TeamCyberwar/Deadlock/CAD files/concept layout1b.PNG

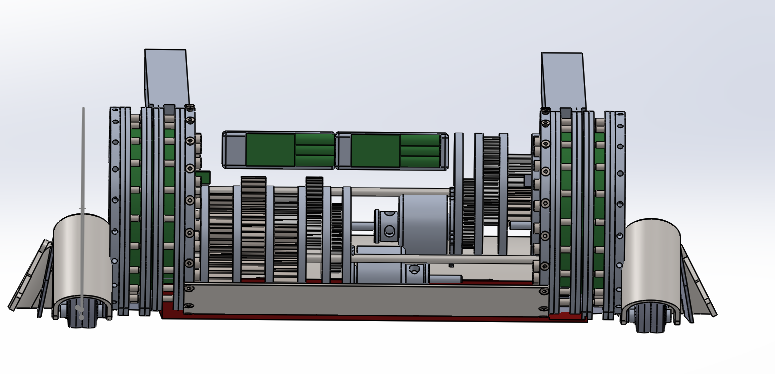
CAD files/concept layout1b.PNG
