TeamCyberwar/Deadlock/CAD files/concept layout1c.PNG

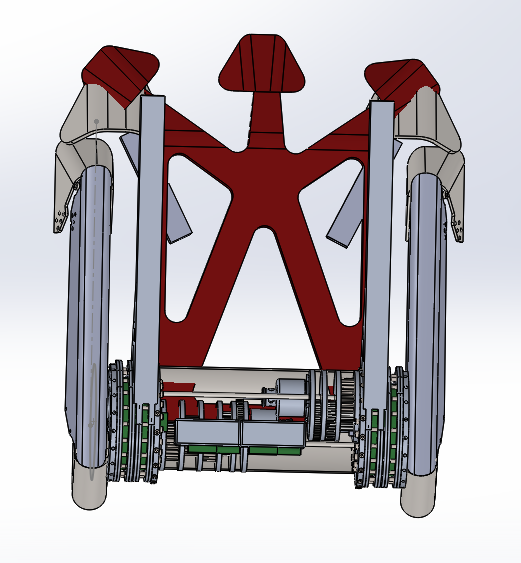
CAD files/concept layout1c.PNG
