TeamCyberwar/Deadlock/readme.md

# What is a Deadlock?

Deadlock is heavyweight combat robot. It’s a fast four wheel drive design whose main weapon is control: a geared lifter & clamping jaws arrangement which is capable of lifting an opponent and rotating them 360 degrees around the main body. The whole robot can do backward rolls. Yes, that is awesome.

Deadlock’s armour is formed from laser cut Hardox sheet, bent and shaped to cover the drive pods and main weapon.

Traction and speed is achieved with full four wheel drive, tank style steering, with power distributed from the 2 high torque 6kw peak brushless motors via chains. The unique body shape allows the front wheels to be close to the lifting point, giving a stable base for driving whilst lifting other robots. An advanced motor control strategy using hall effect sensors allows low speed control from the light but powerful motors.

Deadlock’s weapon is an electrically powered geared lifter/clamper. Using 2 more of the powerful, high torque, 6kw brushless motors, the lift is fast and aggressive. Opponents can not only be lifted and moved around the arena, they can be slammed overhead or into the ground, bashing them into submission. The gearing is achieved by high torque but compact multi stage planetary gearboxes. The weapon is made safe by means of a locking bar when not in the arena.

## I want a Deadlock of my own!
If you have an [onshape](http://onshape.com) account (they're free), you can look at and copy [all the CAD models we used when building Deadlock](https://cad.onshape.com/documents?filter=team&teamId=58c42a52575aee0f7acbd498&column=modifiedAt&order=desc).
If your ambitions are a little smaller, why not build a [scale model of an early iteration](http://www.thingiverse.com/thing:218009) or even a [drivable one](http://www.thingiverse.com/thing:2181223)?

## I *like* Deadlock - where can I find out more?
We're glad to hear it! The best thing to do is to [like and follow us on Facebook](https://www.facebook.com/teamcyberwar) or [follow us on Twitter](https://twitter.com/deadlockrw).

## Acknowledgements

This design was helped by the online community sharing their designs. below are the sources of the files that were used in our test rigs and final design.

All EC connector family models based on model by Graham Baldwin on grabcad https://grabcad.com/library/connector-for-rc-model
RS/3dcontent central for indicator LED model

XT30 by Chrsitian Honig on grabcad https://grabcad.com/library/xt30-connector-1

cable tie model based on model by 'Gregg' on GrabCAd https://grabcad.com/library/cable-tie

cable tie hold down KR5G5-100P by nguyen duc on grabcad https://grabcad.com/library/cable-tie-fixture-misumi-1

vibration isolation VG-2 by RS on 3d content central https://www.3dcontentcentral.com/secure/Download-Partner-Model.aspx?id=327894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

VGS-5 screw direct from essentra components

screws, sprockets, most bearings and eclips from solidworks toolbox

chain root model by  Will Bickerstaff from grabcad https://grabcad.com/library/bs-simplex-roller-chains-1

piano hinge modified from model by Michael Ploof from grabcad https://grabcad.com/library/piano-hinge-mcmaster-carr-part-1658a731-1

vice by Husni Fajar on grabcad https://grabcad.com/library/ragum-vice-1/details?folder_id=1902834

jubilee clip by mark flintoft on grabcad https://grabcad.com/library/jubilee-clips-13mm-wide-1

box end wrench by William Truk on 3dcontentcentral https://www.3dcontentcentral.com/secure/download-model.aspx?catalogid=171&id=229573

pillow block bearings from traceparts http://www.tracepartsonline.net/(S(ny1p1buk5kjeki55kkfjhl45))/partdetails.aspx?PartFamilyID=69-19042013-064161&PartID=69-19042013-064161&sk_Reference=&Class=INAFAG&ClsID=/F_INAFAG/&fwsid=INAFAG&ManId=INAFAG

hammond case models direct from www.hammondmfg.com

sliding T bar from cnc-akura on grabcad https://grabcad.com/library/sliding-t-bar-handles

Eye bolt by J.A.N on grabcad https://grabcad.com/library/din-444-eyebolt-m5-m20-different-sizes-1

banana for scale by Stephan on grabcad https://grabcad.com/library/banana-for-scale-1

# Licence
<br />This work is licensed under a <a rel="license" href="http://creativecommons.org/licenses/by-nc-sa/4.0/">Creative Commons Attribution-NonCommercial-ShareAlike 4.0 International License</a>.
