TeamCyberwar/Deadlock/CAD files/concept layout1a.PNG

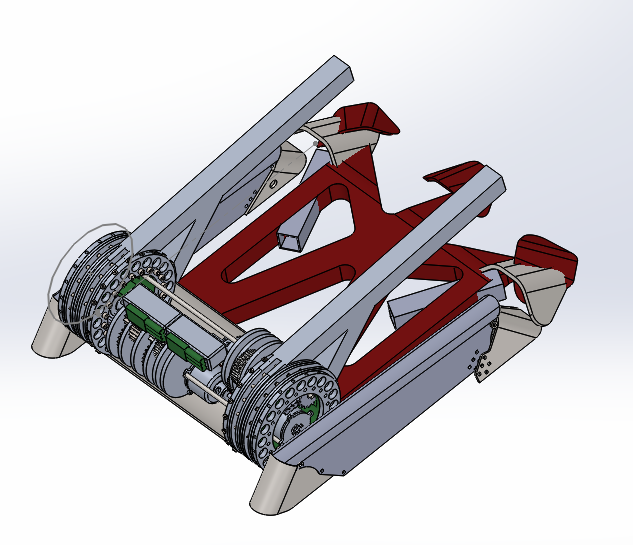
CAD files/concept layout1a.PNG
