TeamCyberwar/Deadlock/CAD files/NYRDI heavy 1.PNG

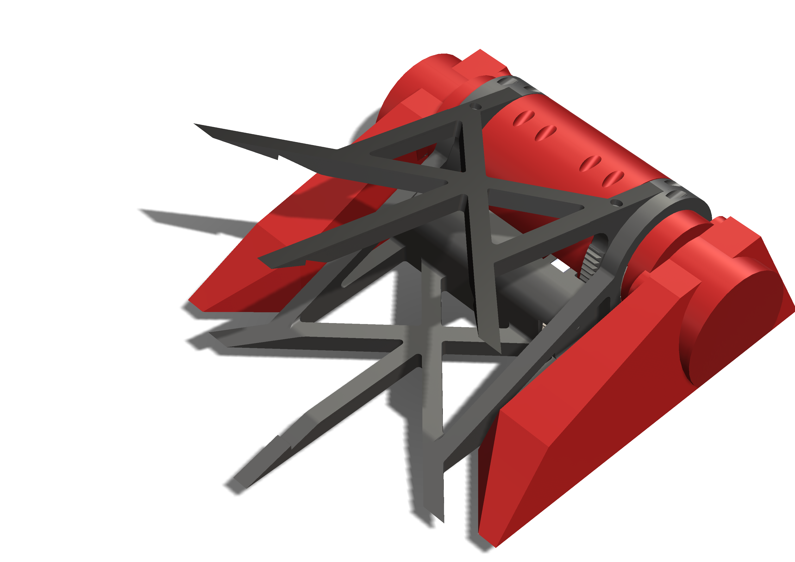
CAD files/NYRDI heavy 1.PNG
