TeamCyberwar/Deadlock/dogfood/Gearbox and Wheel Cassette v2.png

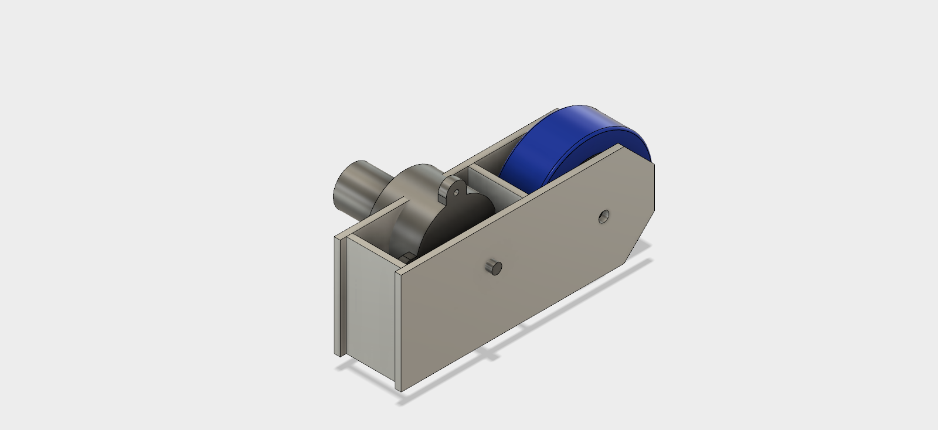
dogfood/Gearbox and Wheel Cassette v2.png
