TeamCyberwar/Deadlock/dogfood/motor mounting holes.PNG

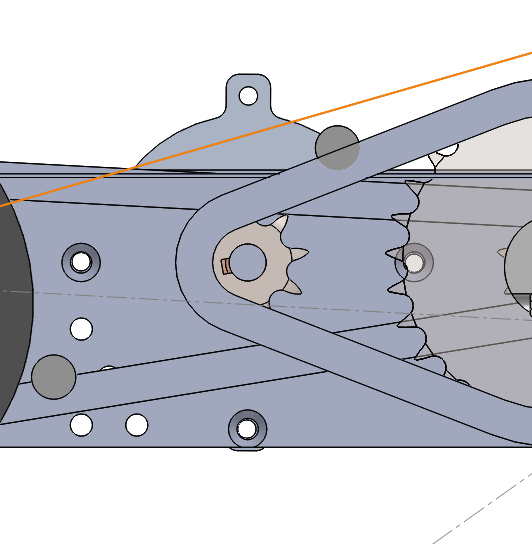
dogfood/motor mounting holes.PNG
