TeamCyberwar/Deadlock/dogfood/sb4a.PNG

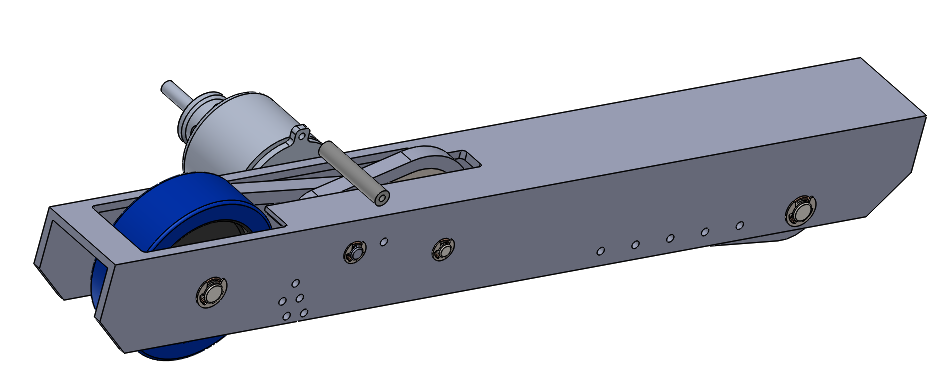
dogfood/sb4a.PNG
