TeamCyberwar/Deadlock/dogfood/sb4b.PNG

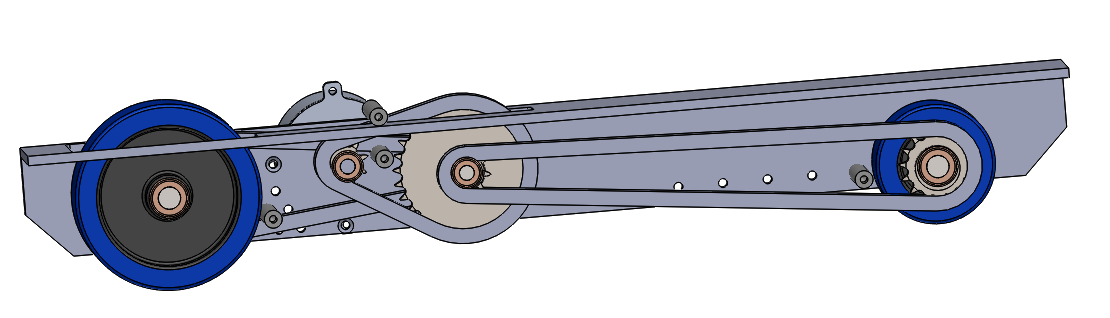
dogfood/sb4b.PNG
