TeamCyberwar/Deadlock/dogfood/sb4c.PNG

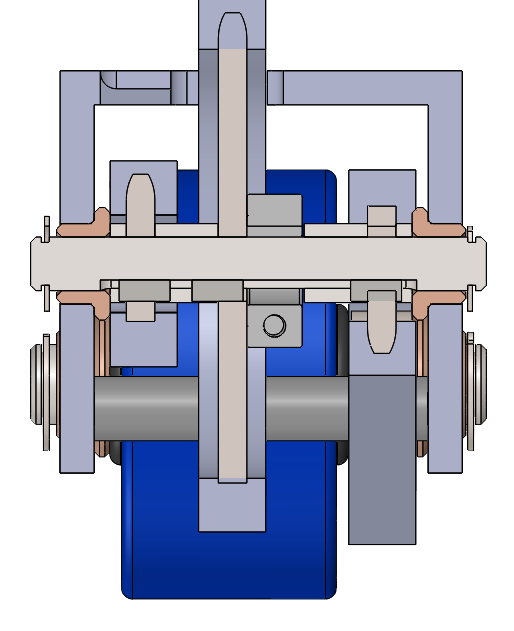
dogfood/sb4c.PNG
