TeamCyberwar/Deadlock/dogfood/sb4d.PNG

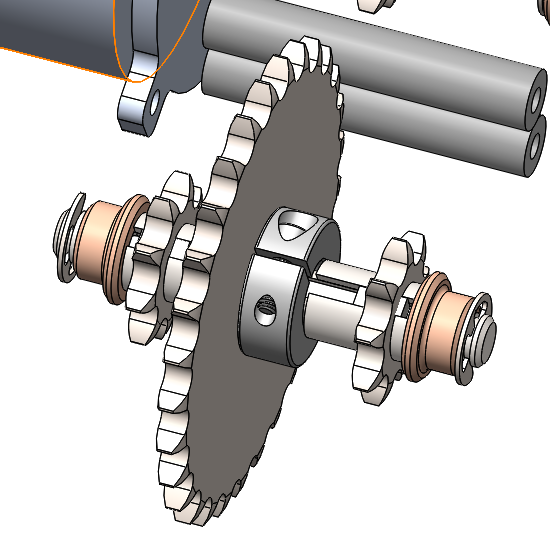
dogfood/sb4d.PNG
