TeamCyberwar/Deadlock/CAD files/piano_hinge_MM_1658A731.SLDASM

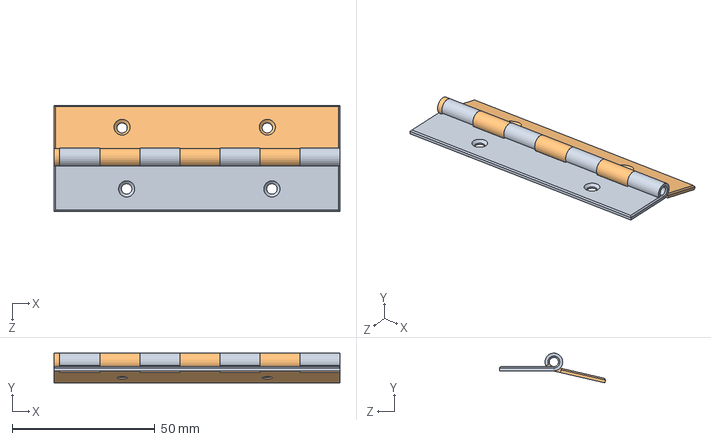
[picture p11: CAD file, 2017-03-15]
CAD files/piano_hinge_MM_1658A731.SLDASM
100.0 x 10.4 x 37.1 mm
piano_hinge_MM_1658A731_A
piano_hinge_MM_1658A731_B
