TeamCyberwar/Deadlock/dogfood/lifter test bed/ucp210_adhynrzrmw05zbap5u401bjt8.SLDASM

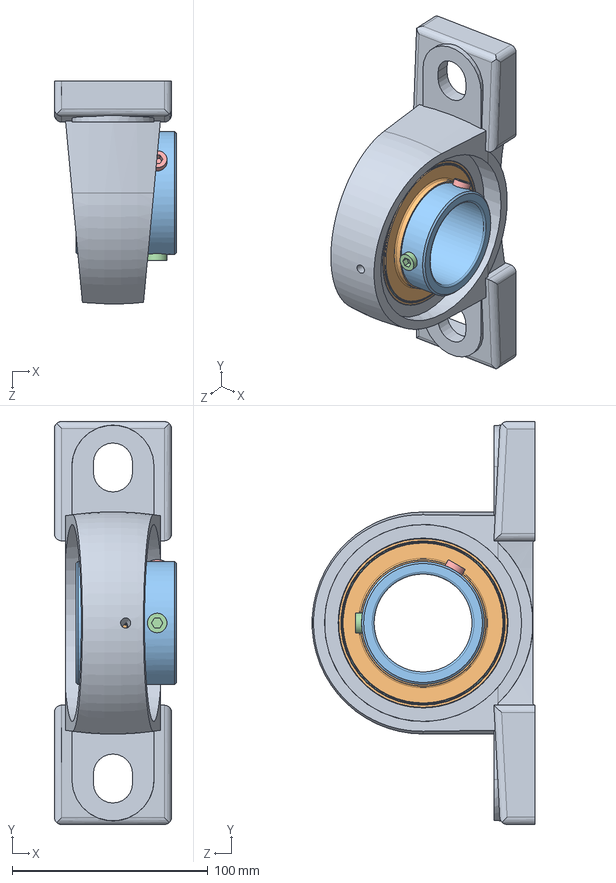
[picture p12: CAD file, 2017-03-15]
dogfood/lifter test bed/ucp210_adhynrzrmw05zbap5u401bjt8.SLDASM
62.6 x 206.0 x 113.9 mm
ucp210_adhynrzrmw05zbap5u401bjt8_01
ucp210_adhynrzrmw05zbap5u401bjt8_02
ucp210_adhynrzrmw05zbap5u401bjt8_03
ucp210_adhynrzrmw05zbap5u401bjt8_04
ucp210_adhynrzrmw05zbap5u401bjt8_05
ucp210_adhynrzrmw05zbap5u401bjt8_06
ucp210_adhynrzrmw05zbap5u401bjt8_07
ucp210_adhynrzrmw05zbap5u401bjt8_08
ucp210_adhynrzrmw05zbap5u401bjt8_09
ucp210_adhynrzrmw05zbap5u401bjt8_10
ucp210_adhynrzrmw05zbap5u401bjt8_11
ucp210_adhynrzrmw05zbap5u401bjt8_12
ucp210_adhynrzrmw05zbap5u401bjt8_13
ucp210_adhynrzrmw05zbap5u401bjt8_14
