TeamCyberwar/Deadlock/dogfood/06B-1b.SLDASM

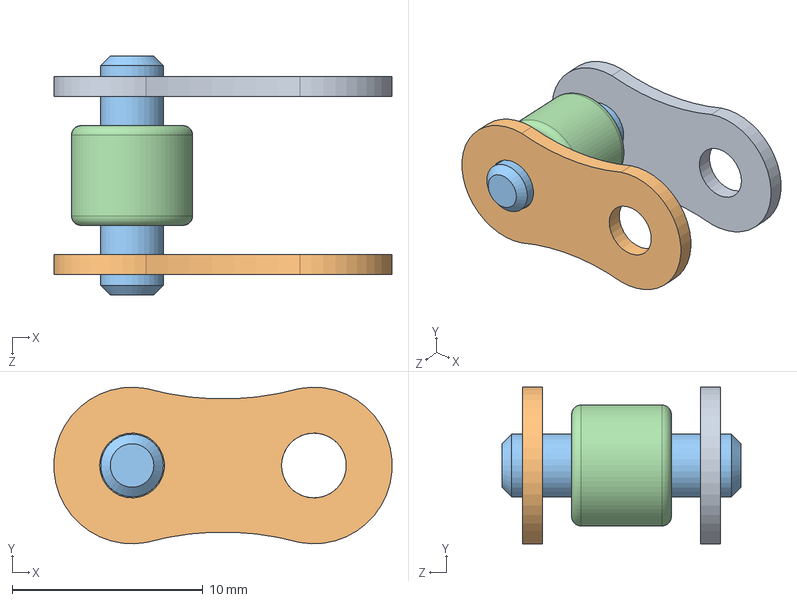
[picture p13: CAD file, 2017-03-15]
dogfood/06B-1b.SLDASM
17.7 x 8.20 x 12.5 mm
Outer_(Mirror_#1)
Outer
Pin_(Mirror_#3)
Roller_(Mirror_#4)
