TeamCyberwar/Deadlock/dogfood/vice/vice.SLDASM

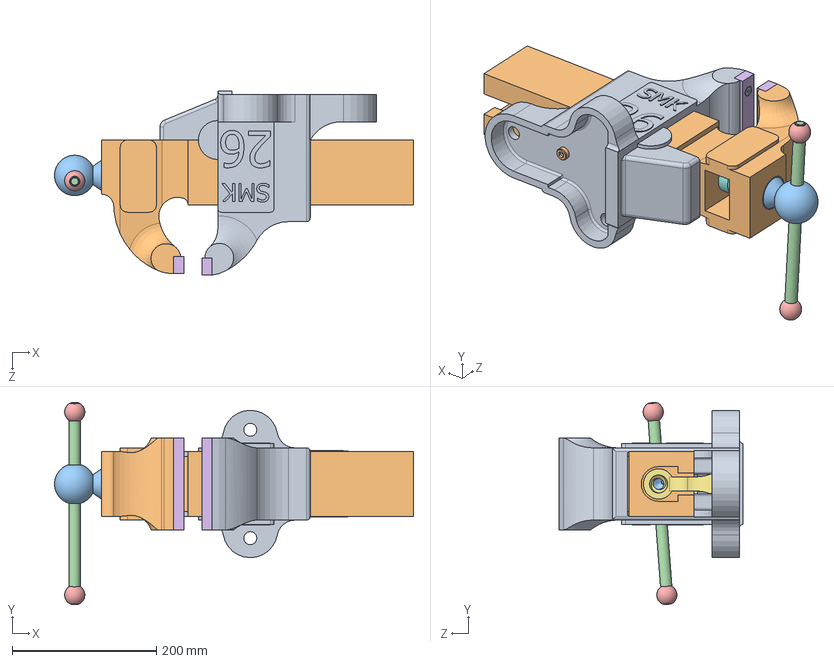
[picture p14: CAD file, 2017-03-15]
dogfood/vice/vice.SLDASM
497.0 x 280.0 x 255.0 mm
Base
Rahang Geser
Shaft Ulir Head
Shaft handle
Shaft Handle Head x 2
Block x 2
Shaft Ulir House
Stoper
ISO 10642 - M6 x 25 x 4
DIN 6912 - M10 x 30
DIN 913 - M5 x 10
