TeamCyberwar/Deadlock/dogfood/vice/Assembly1.stp

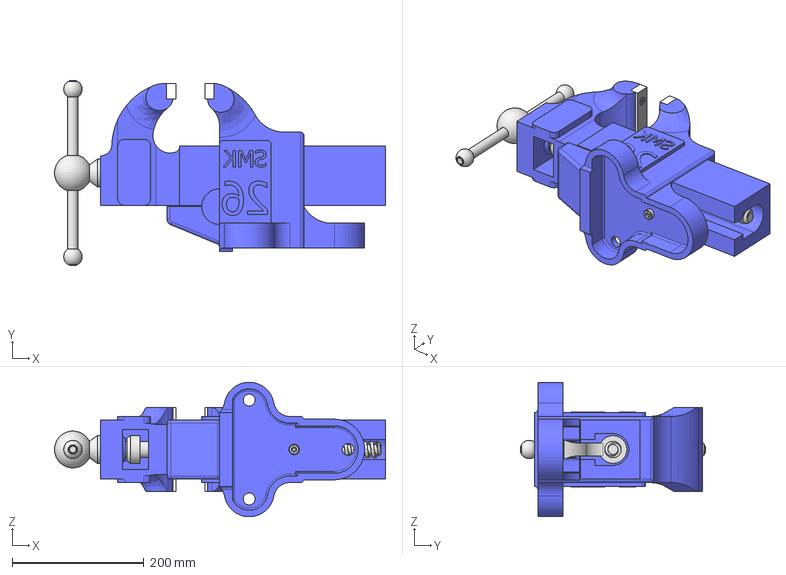
[picture p15: CAD file, 2017-03-15]
dogfood/vice/Assembly1.stp
501.9 x 280.0 x 203.9 mm
