TeamCyberwar/Deadlock/dogfood/06B-1a.SLDASM

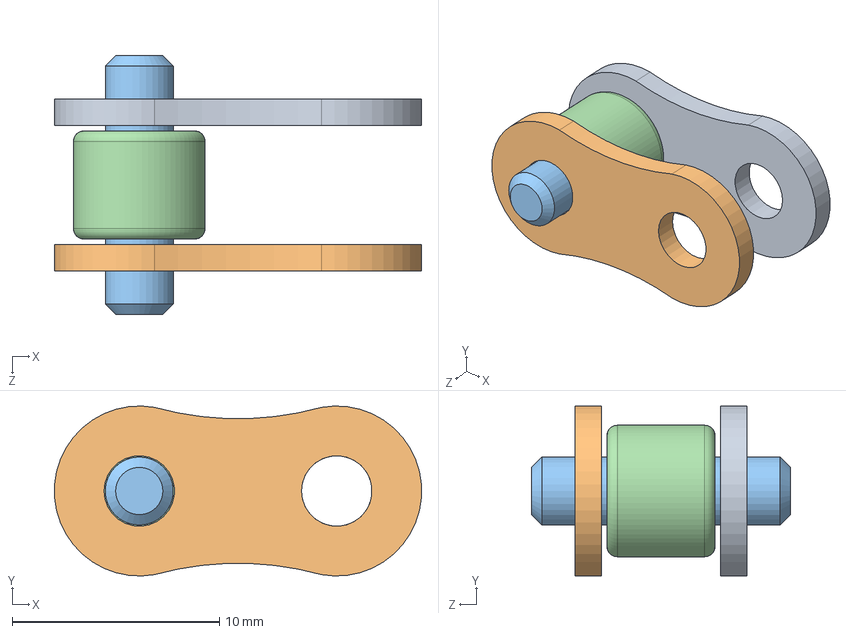
[picture p16: CAD file, 2017-03-15]
dogfood/06B-1a.SLDASM
17.7 x 8.20 x 12.5 mm
Inner_(Mirror_#1)
Inner
Pin
Roller
