TeamCyberwar/Deadlock/dogfood/lifter test bed/lifterc.SLDASM

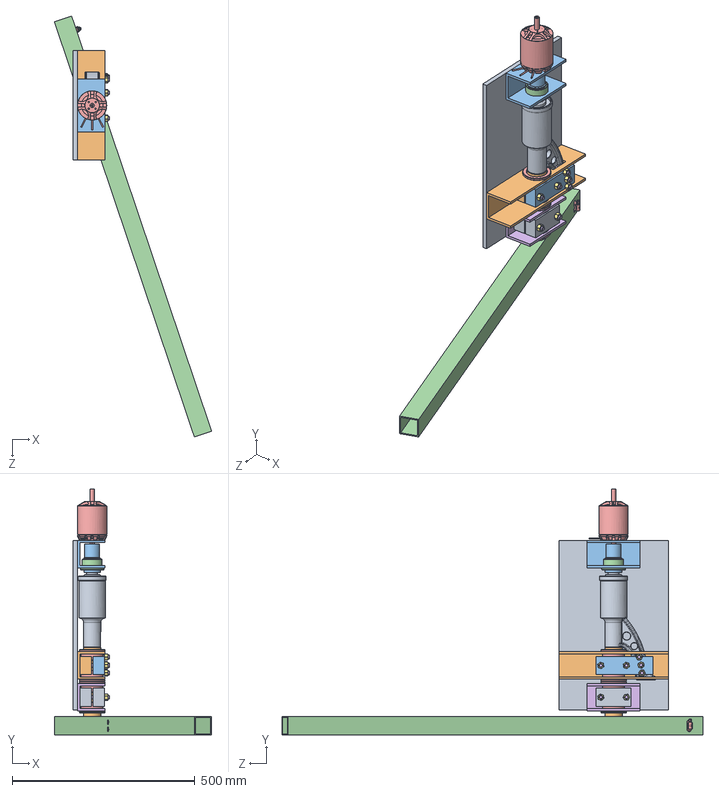
[picture p17: CAD file, 2017-03-15]
dogfood/lifter test bed/lifterc.SLDASM
430.8 x 673.1 x 1153.1 mm
torque multiplier
3x3channelc
3x3channelc2
OBF506030 Flanged Oilite x 4
ISO 10642 - M10 x 100 - 32N x 7
ISO - 4034 - M10 - N x 7
input shaftb
baseboard
33mm socket x 2
20 to 25mm square adapter
OBF455530 Flanged Oilite
C80100 50kv
3x3channelc3
32mm hex bar
0.75in t bar handle
nylon spacer 1 x 2
nylon spacer 2
Mirrornylon spacer 2
steel tube
Jubilee
