TeamCyberwar/Deadlock/eVESC/Mounting HW.sldasm

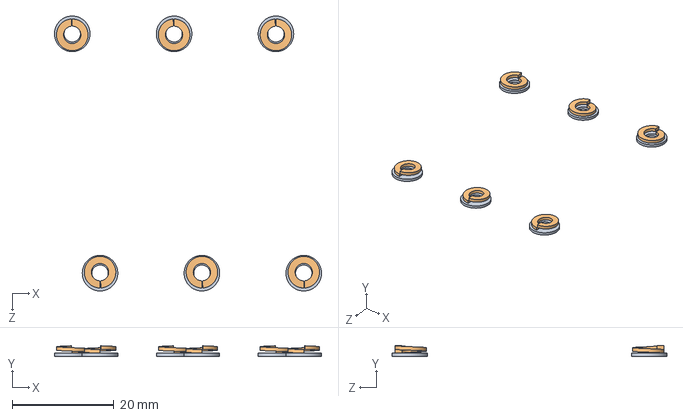
[picture p18: CAD file, 2017-03-15]
eVESC/Mounting HW.sldasm
52.4 x 2.07 x 54.0 mm
M3 washer x 6
M3 split washer x 6
