TeamCyberwar/Deadlock/CAD files/clamp fork v1.sldasm

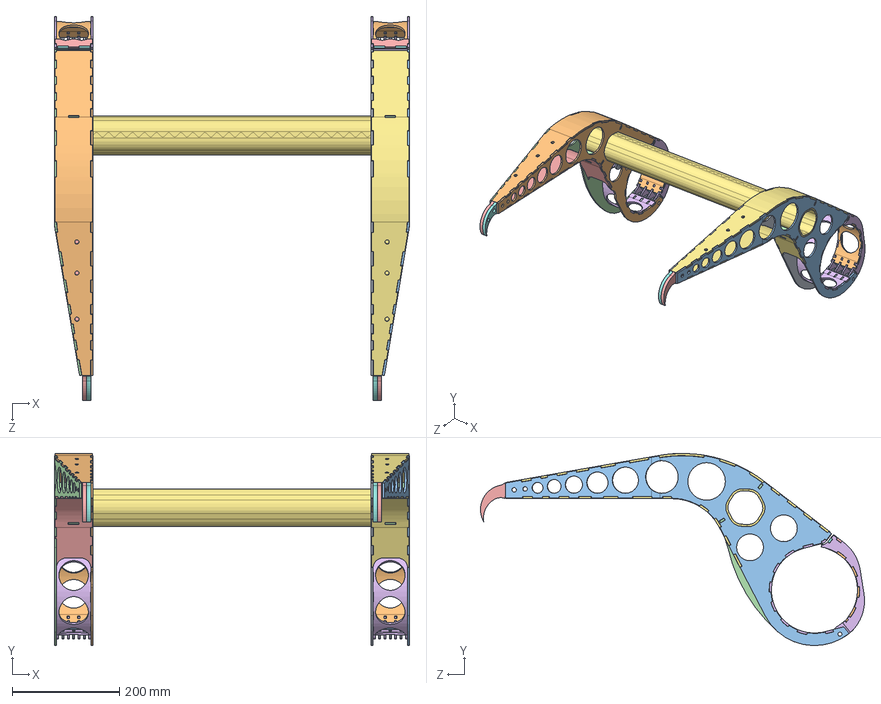
[picture p19: CAD file, 2017-03-15]
CAD files/clamp fork v1.sldasm
661.4 x 357.7 x 714.7 mm
clamp1 x 6
clamp24
clampsaddle10 x 6
clamp20
clampsaddle repeat7 x 2
clampsaddle4 x 8
clamp12
clampclawrepeat x 2
clamp21 x 2
clamp8
clamp18
clamp6 x 2
clampclaw2 x 2
clampsaddle1 x 4
clamp10
clampsaddle3 x 2
clamp17
clampsaddle6 x 2
clamp23
clamp19 x 2
clamp4
clamp9 x 2
clamp tube x 2
