TeamCyberwar/Deadlock/dogfood/16B-2.SLDASM

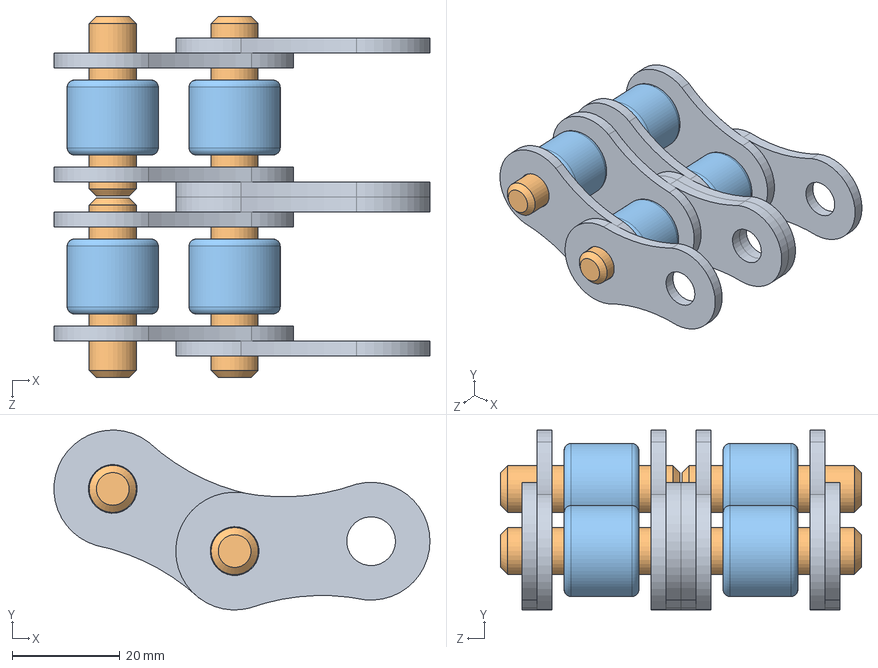
[picture p20: CAD file, 2017-03-15]
dogfood/16B-2.SLDASM
69.8 x 33.4 x 67.0 mm
Outer16 x 8
Pin_(Mirror_#3)16 x 4
Roller_(Mirror_#4)16 x 4
