TeamCyberwar/Deadlock/dogfood/lifter test bed/lifterd.SLDASM

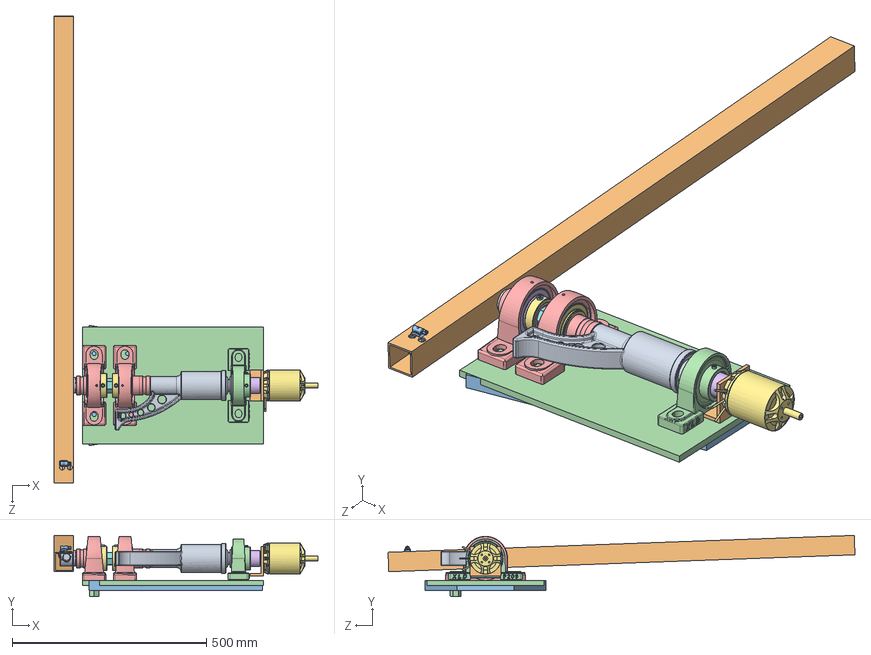
[picture p21: CAD file, 2017-03-15]
dogfood/lifter test bed/lifterd.SLDASM
678.2 x 157.5 x 1201.0 mm
torque multiplier
3x3channeld2
input shaftb
33mm socket x 2
20 to 25mm square adapter
C80100 50kv
32mm hex bar
0.75in t bar handle
steel tube
Jubilee
User Library-Block Bearings Pilow Blocks
ucp210_adhynrzrmw05zbap5u401bjt8_01 x 2
ucp210_adhynrzrmw05zbap5u401bjt8_02 x 2
ucp210_adhynrzrmw05zbap5u401bjt8_03 x 2
ucp210_adhynrzrmw05zbap5u401bjt8_04 x 2
ucp210_adhynrzrmw05zbap5u401bjt8_05 x 2
ucp210_adhynrzrmw05zbap5u401bjt8_06 x 2
ucp210_adhynrzrmw05zbap5u401bjt8_07 x 2
ucp210_adhynrzrmw05zbap5u401bjt8_08 x 2
ucp210_adhynrzrmw05zbap5u401bjt8_09 x 2
ucp210_adhynrzrmw05zbap5u401bjt8_10 x 2
ucp210_adhynrzrmw05zbap5u401bjt8_11 x 2
ucp210_adhynrzrmw05zbap5u401bjt8_12 x 2
ucp210_adhynrzrmw05zbap5u401bjt8_13 x 2
ucp210_adhynrzrmw05zbap5u401bjt8_14 x 2
welded frame2
ISO - 4034 - M16 - N
