TeamCyberwar/Deadlock/eVESC/VESC Power Stage v7.SLDASM

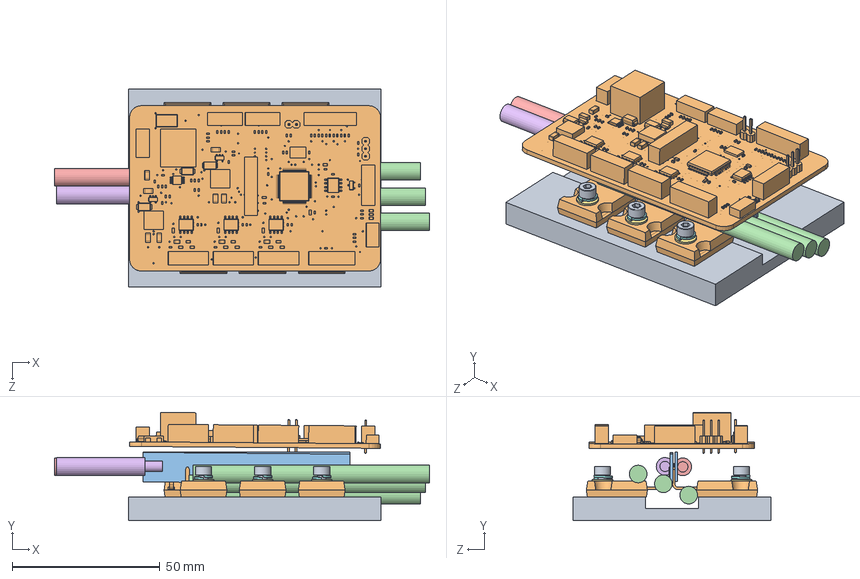
[picture p22: CAD file, 2017-03-15]
eVESC/VESC Power Stage v7.SLDASM
126.9 x 36.6 x 67.0 mm
Heatsink 8mm
TO-247AC-HF v1 x 6
Bus Bar x 2
10AWG Phase Wire x 3
10AWG VCC Wire
10AWG GND Wire
M3 washer x 6
M3 split washer x 6
M3 x 12 - 12N x 6
eVESC v2
