TeamCyberwar/Deadlock/CAD files/drive pod v0.9.SLDASM

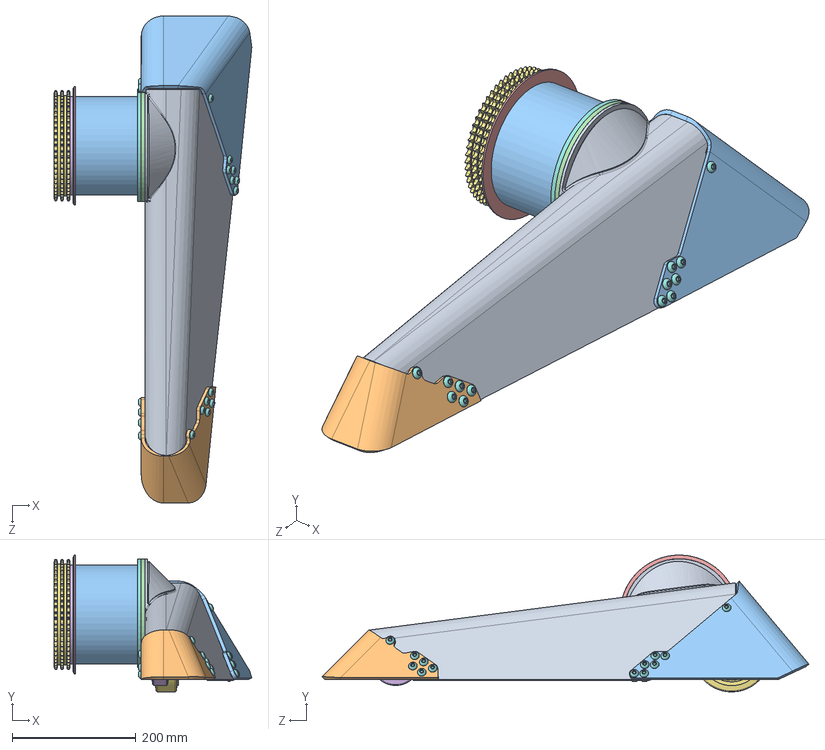
[picture p23: CAD file, 2017-03-15]
CAD files/drive pod v0.9.SLDASM
319.5 x 221.2 x 787.3 mm
pod tube flared v0.8
front wheel mount flared2
rear wheel mount flaredv0.6
06b1 15T
23Z 06B-1
80mm wheel 4
125mm wheel v2
Inner_(Mirror_#1) x 75
Inner x 75
Pin x 75
Roller x 75
Outer_(Mirror_#1) x 74
Outer x 74
Pin_(Mirror_#3) x 74
Roller_(Mirror_#4) x 74
rear wheel hub v2
OBF253020 Flanged Oilite x 3
rear wheel axle
front wheel hub
front wheel axle2
drive pod base v0.4
OBF152110 Flanged Oilite
9T 06b3
ISO 7380 - M8 x 16 - 16N x 26
ISO 10642 - M3 x 8 - 8N x 4
M6 x 40 - 24N x 4
ISO 10642 - M4 x 30 - 20N x 4
ISO 4762 M8 x 140 - 28N x 20
ISO 4762 M6 x 16 - 16N x 4
ISO 4762 M6 x 20 - 20N
ISO 4762 M6 x 12 - 12N x 5
1301-NSK self aligning bearing
drive pod rear plastic block v0.3
5 x 14 pin x 4
nylon tube v3
outer inner anti friction ring v3
inner flange plate
inner spacer plate v0.2
57T 06b3 v0.2
front drive chain keeper
rear drive chain keeper
M4 barrel nut x 4
drive motor bearing spacer
Washer ISO 7092 - 14
B27.7M - 3CM1-15
B27.7M - 3CM1-25
rear wheel plastic washer
intermediate anti friction ring v3
ISO 4762 M5 x 20 - 20N
ISO 4762 M6 x 25 - 25N x 4
