TeamCyberwar/Deadlock/eVESC/housed vesc.SLDASM

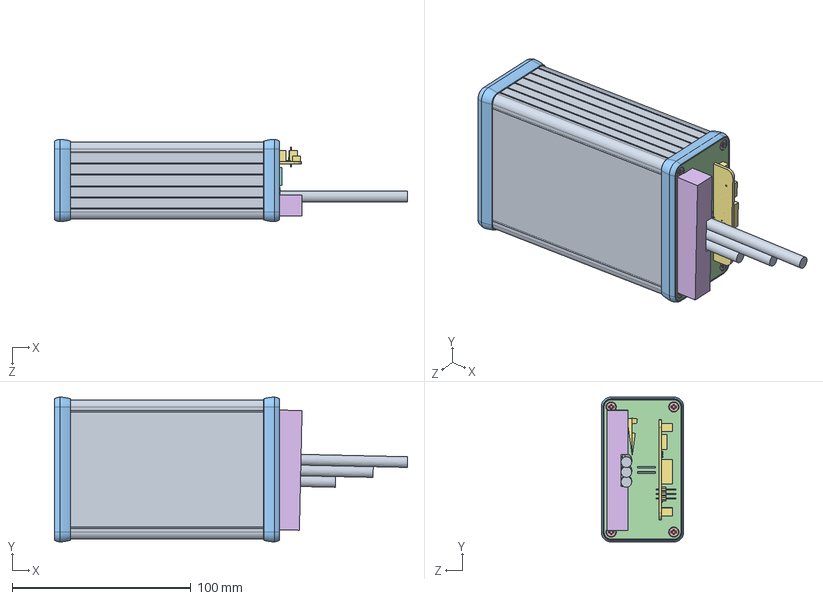
[picture p24: CAD file, 2017-03-15]
eVESC/housed vesc.SLDASM
197.5 x 81.1 x 46.1 mm
K Channel Extrusion 120mmt
K Cap Extrusion 120mm
K Bezel Open x 2
K End Plate
1455 screw x 8
Heatsink
TO-247AC-HF v1 x 6
Bus Bar x 2
10AWG Phase Wire x 3
10AWG VCC Wire
10AWG GND Wire
M3 washer x 6
M3 split washer x 6
M3x12mm socket x 6
eVESC v2
