TeamCyberwar/Deadlock/dogfood/lifter test bed/0.5in t bar handles.SLDASM

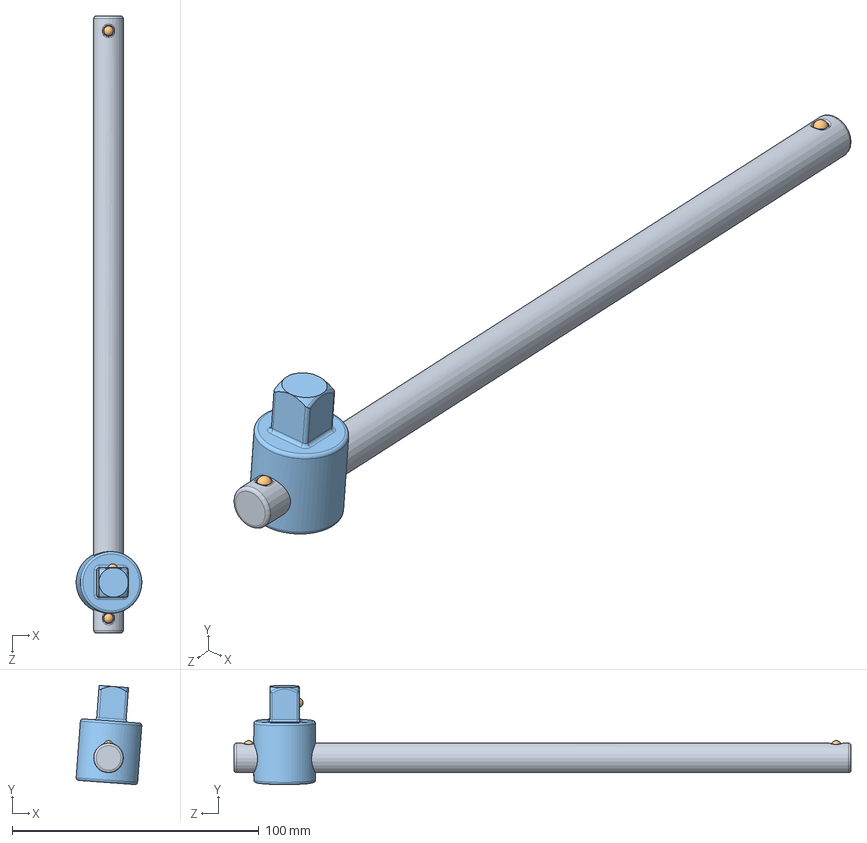
[picture p25: CAD file, 2017-03-15]
dogfood/lifter test bed/0.5in t bar handles.SLDASM
26.6 x 40.2 x 250.0 mm
Part2 ball x 3
Part3 conector
