TeamCyberwar/Deadlock/CAD files/front forks v2.7 from sheet.sldasm

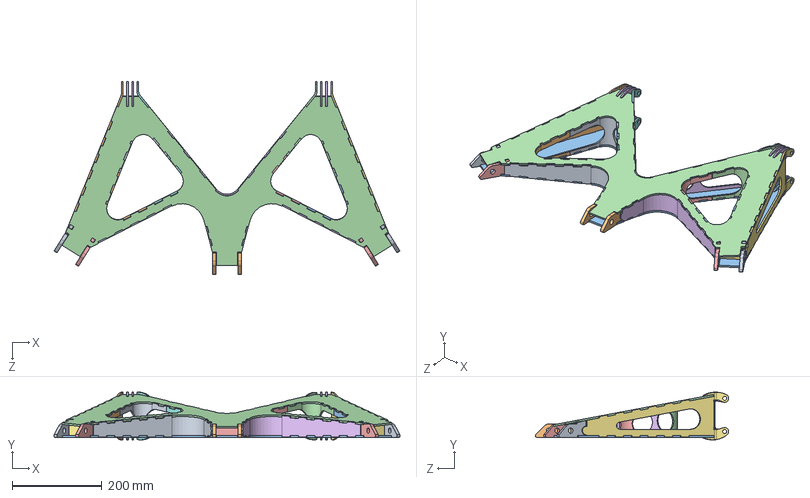
[picture p26: CAD file, 2017-03-15]
CAD files/front forks v2.7 from sheet.sldasm
771.7 x 106.4 x 431.5 mm
fork16 v2
fork10 x 2
fork9 v2
fork7 v2
fork8
fork1 x 4
fork4 x 2
fork3
fork18 x 2
fork11
fork2 x 4
fork6
fork20 x 2
fork15 v2
fork12
fork22
fork23
fork5
fork24
fork25
fork26
fork27
