TeamCyberwar/Deadlock/CAD files/lifter hardox v3.6 from sheet.sldasm

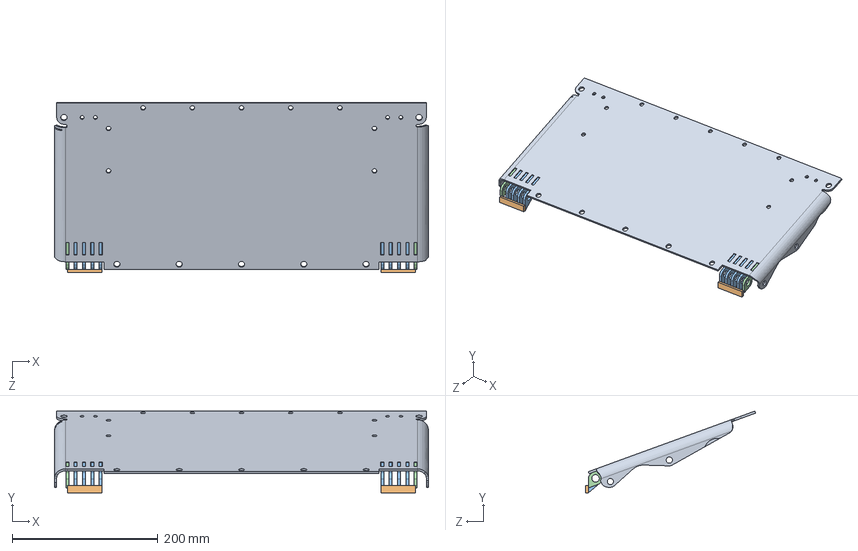
[picture p27: CAD file, 2017-03-15]
CAD files/lifter hardox v3.6 from sheet.sldasm
513.0 x 112.3 x 233.5 mm
lifter1v2
lifter2v2 x 2
lifter3v2 x 8
lifter4v2 x 2
