TeamCyberwar/Deadlock/CAD files/clamp chain v2.sldasm

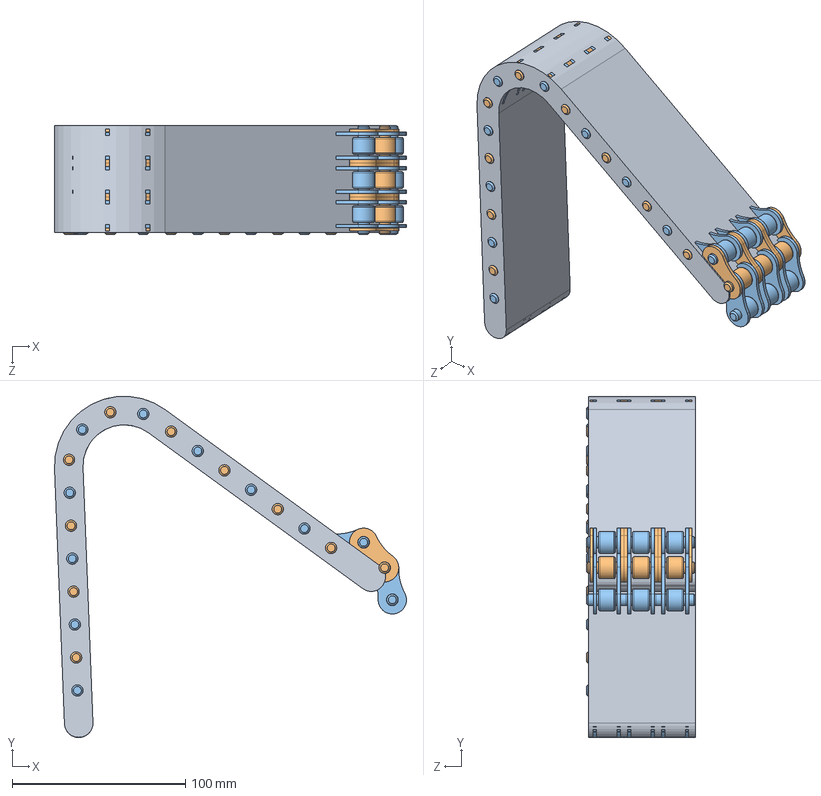
[picture p28: CAD file, 2017-03-15]
CAD files/clamp chain v2.sldasm
203.4 x 197.1 x 63.2 mm
simple clamp chain v2
12B-3b x 10
12B-3a x 11
