TeamCyberwar/Deadlock/dogfood/SB drive pod 3b.SLDASM

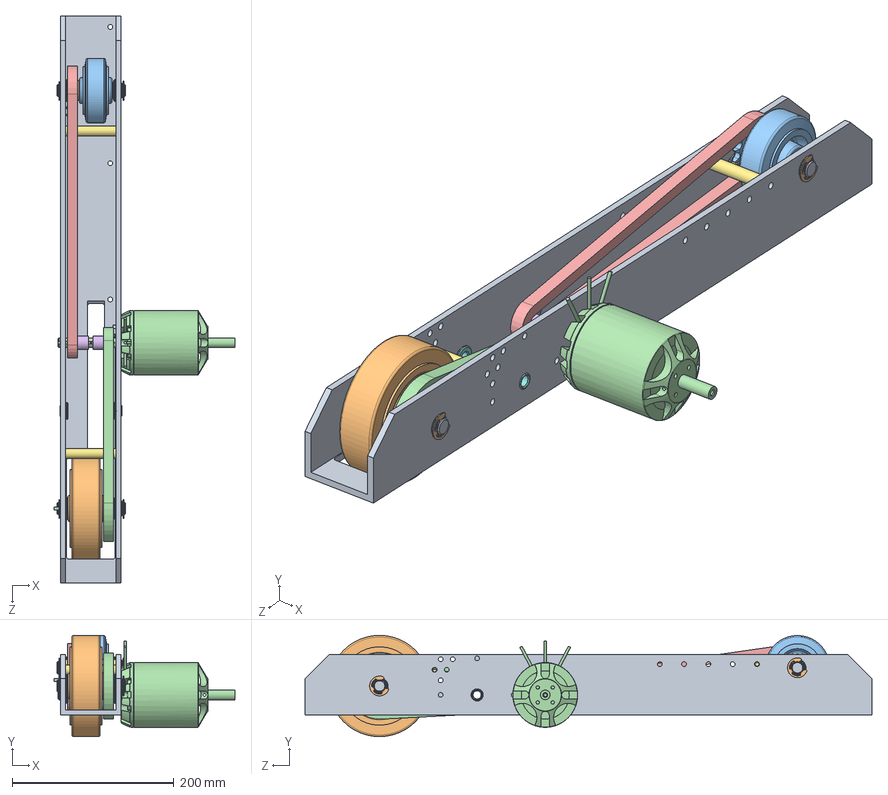
[picture p29: CAD file, 2017-03-15]
dogfood/SB drive pod 3b.SLDASM
223.4 x 124.9 x 700.0 mm
3x3channel 3
125mm wheel 458-9670 3
80mm wheel 3
Outer_(Mirror_#1)
Outer
Inner_(Mirror_#1)
Inner
Pin_(Mirror_#3)
Pin
Roller_(Mirror_#4)
Roller
3rd chain
Chain wheel ISO - 9Z 06B-1 --9SB18H22L12.0N x 2
Chain wheel ISO - 24Z 06B-1 --24SA15.0S1
OBF152110 Flanged Oilite x 4
15mm axle 682 187 x 2
B27.7M - 3CM1-16 x 4
Chain wheel ISO - 15Z 06B-1 --15SA10.0N
4mm key x 4
3mm key x 3
wheel spacer2 x 2
chain tensioner 282-0632 x 2
OBF101510 Flanged Oilite x 2
rear wheel sleeve
Front wheel sleeve
rear sprocket spacer
C80100 50kv
