TeamCyberwar/Deadlock/CAD files/EC5-Male-connector.SLDASM

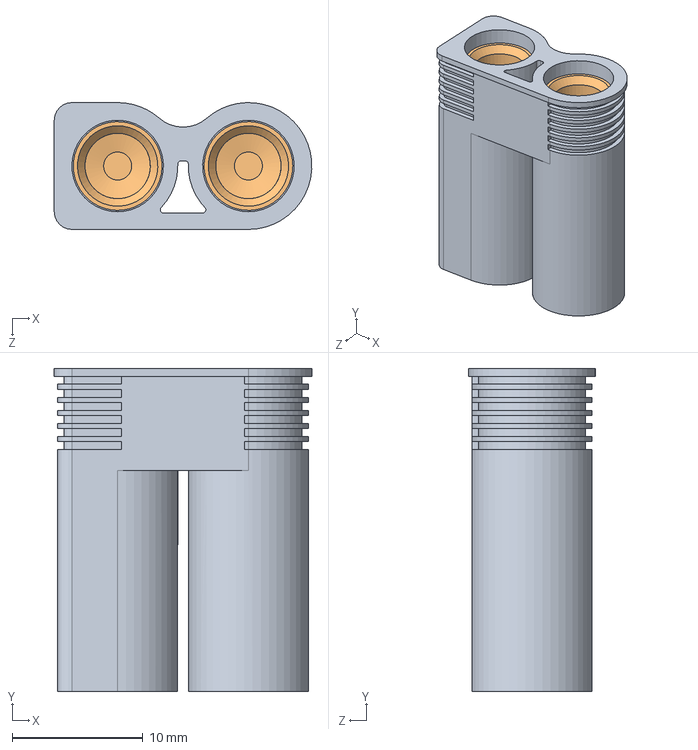
[picture p30: CAD file, 2017-03-15]
CAD files/EC5-Male-connector.SLDASM
19.7 x 24.7 x 9.70 mm
EC5 Male housing
EC3 Male contact x 2
