TeamCyberwar/Deadlock/CAD files/motor antirotation bracket laser cut.sldasm

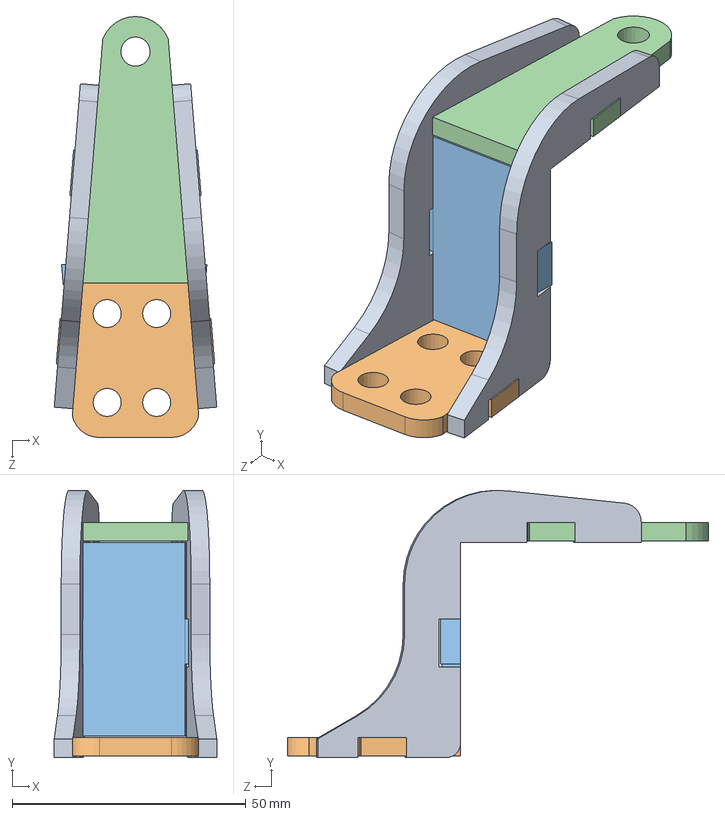
[picture p31: CAD file, 2017-03-15]
CAD files/motor antirotation bracket laser cut.sldasm
34.8 x 57.1 x 90.0 mm
motorantirotation1 x 2
motorantirotation2
motorantirotation3
motorantirotation4
