TeamCyberwar/Deadlock/dogfood/06B-1.SLDASM

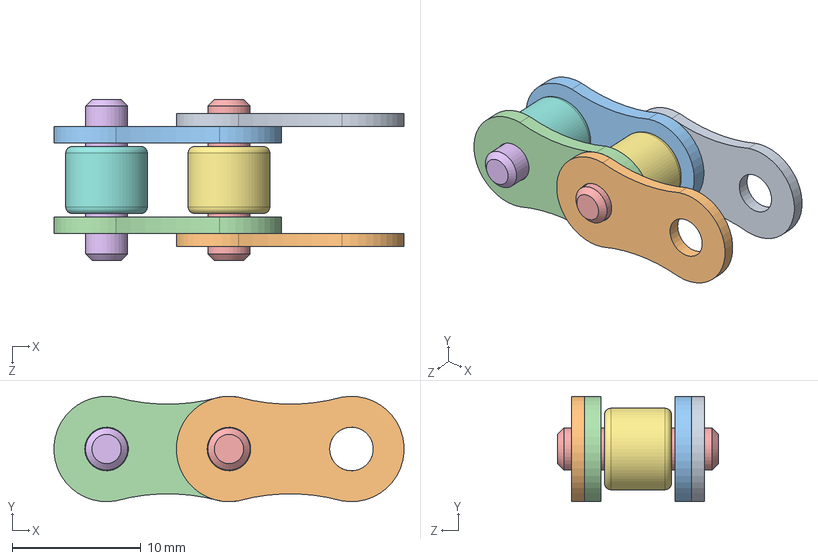
[picture p32: CAD file, 2017-03-15]
dogfood/06B-1.SLDASM
27.2 x 8.20 x 12.5 mm
Outer_(Mirror_#1)
Outer
Inner_(Mirror_#1)
Inner
Pin_(Mirror_#3)
Pin
Roller_(Mirror_#4)
Roller
