TeamCyberwar/Deadlock/CAD files/front fork options.sldasm

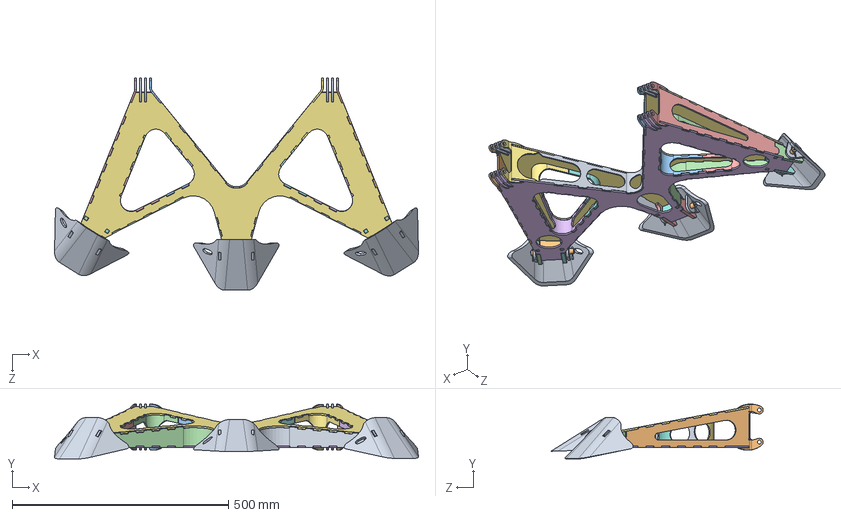
[picture p33: CAD file, 2017-03-15]
CAD files/front fork options.sldasm
841.4 x 126.6 x 491.1 mm
wedgelet for laser cutting 6mm x 3
M12 based wedgelet pin x 3
split pin x 6
fork16 v2
fork10 x 2
fork9 v2
fork7 v2
fork8
fork1 x 4
fork4 x 2
fork3
fork18 x 2
fork11
fork2 x 4
fork6
fork20 x 2
fork15 v2
fork12
fork22
fork23
fork5
fork24
fork25
fork26
fork27
