TeamCyberwar/Deadlock/CAD files/pod tube flared v0.8 from sheet.sldasm

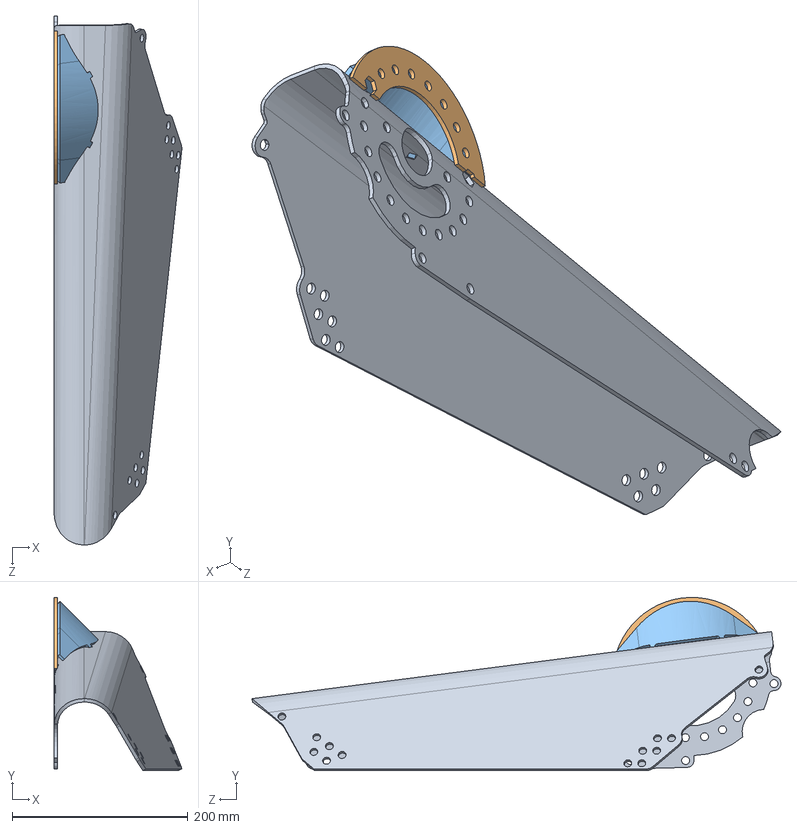
[picture p34: CAD file, 2017-03-15]
CAD files/pod tube flared v0.8 from sheet.sldasm
145.3 x 197.0 x 602.1 mm
pod tube
pod tube gusset
pod tube mounting plate
