TeamCyberwar/Deadlock/CAD files/custom wheel.SLDASM

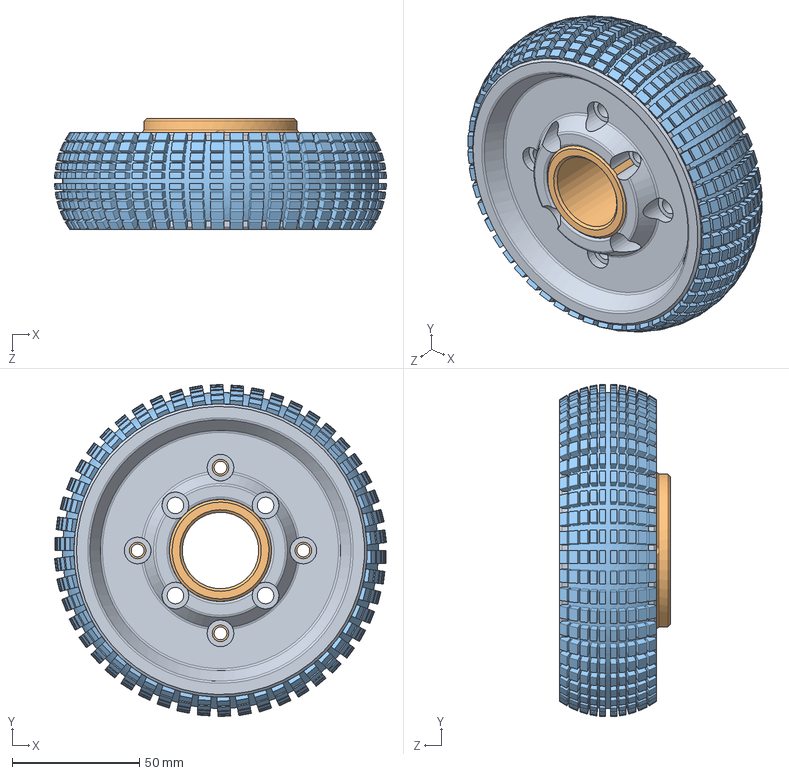
[picture p35: CAD file, 2017-03-15]
CAD files/custom wheel.SLDASM
130.2 x 130.4 x 43.4 mm
solid HDPE wheels
rear wheel hub v2
tyre
