TeamCyberwar/Deadlock/CAD files/wedgelet for laser cutting 6mm.SLDASM

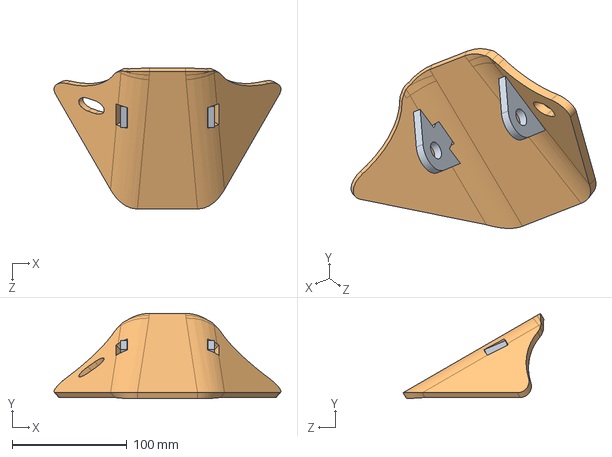
[picture p36: CAD file, 2017-03-15]
CAD files/wedgelet for laser cutting 6mm.SLDASM
198.2 x 74.5 x 123.0 mm
wedgelet2 x 2
wedgelet1
