TeamCyberwar/Deadlock/CAD files/XT30.SLDASM

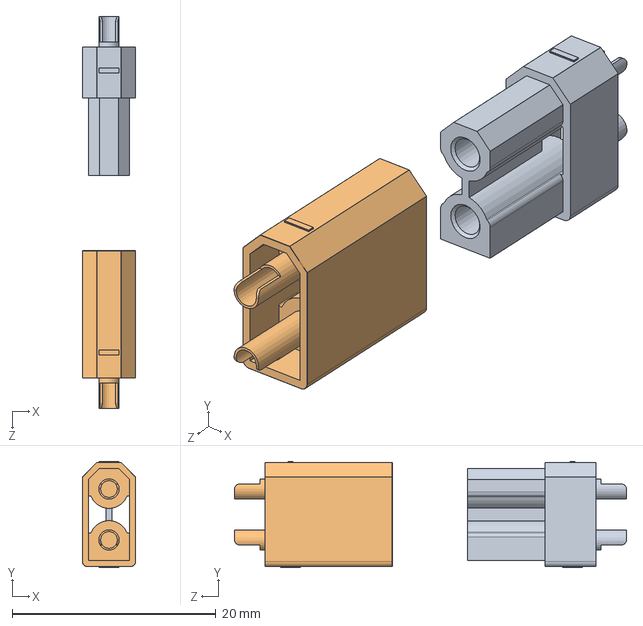
[picture p37: CAD file, 2017-03-15]
CAD files/XT30.SLDASM
5.25 x 10.4 x 38.5 mm
XT30_Buchse
XT30_Stecker
