TeamCyberwar/Deadlock/CAD files/forks comparison.SLDASM

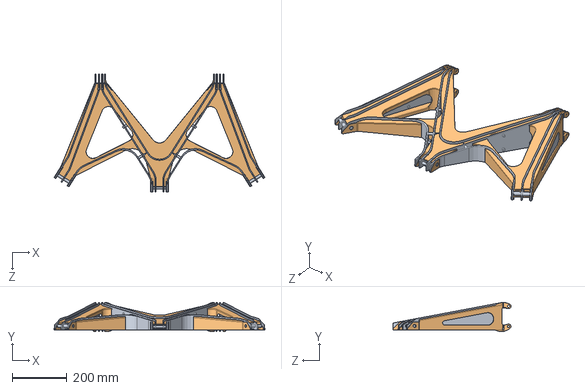
[picture p38: CAD file, 2017-03-15]
CAD files/forks comparison.SLDASM
771.7 x 106.4 x 431.5 mm
no weld forks
front forks v2.6
