TeamCyberwar/Deadlock/CAD files/right lifter chain.sldasm

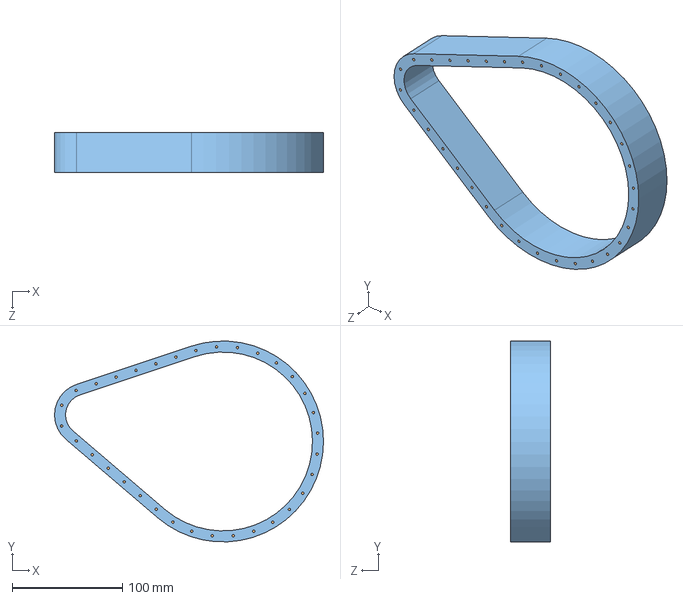
[picture p39: CAD file, 2017-03-15]
CAD files/right lifter chain.sldasm
243.7 x 181.7 x 36.0 mm
06B-3a x 33
06B-3b x 33
