TeamCyberwar/Deadlock/dogfood/EC3 Connector Socket.SLDASM

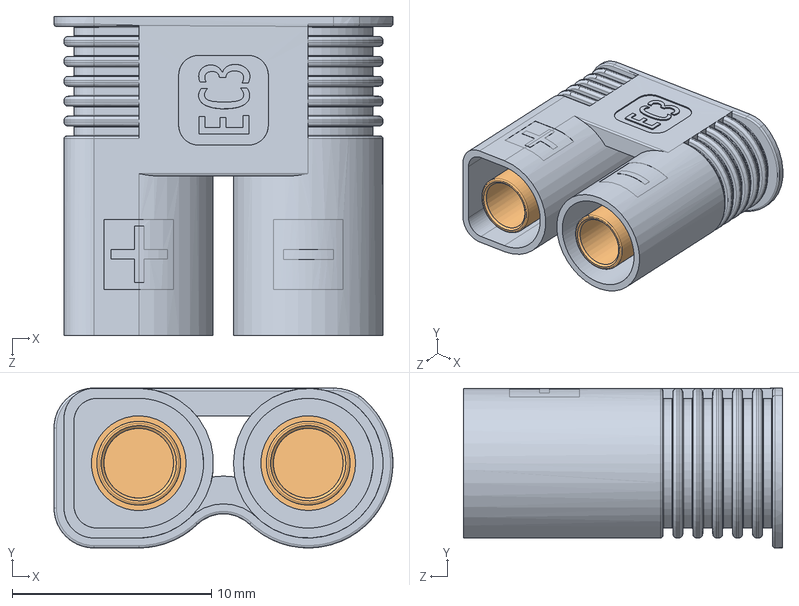
[picture p40: CAD file, 2017-03-15]
dogfood/EC3 Connector Socket.SLDASM
17.0 x 8.02 x 16.0 mm
3-5mm Bullit Socket x 2
