TeamCyberwar/Deadlock/CAD files/tube from plate.SLDASM

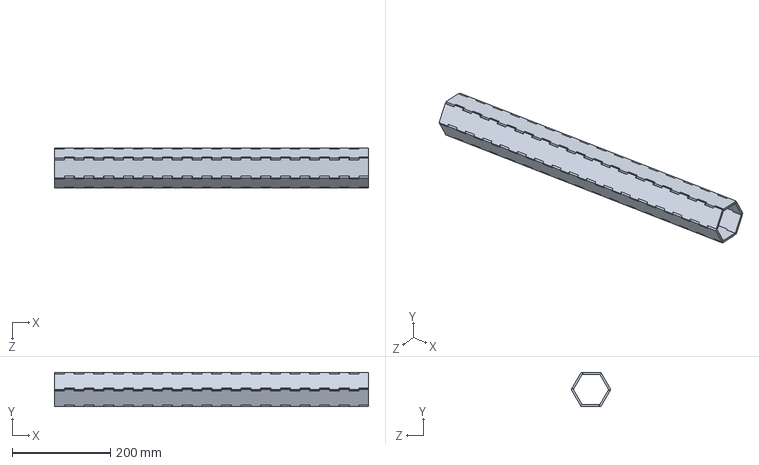
[picture p41: CAD file, 2017-03-15]
CAD files/tube from plate.SLDASM
640.0 x 70.0 x 80.8 mm
tube from plate x 6
