TeamCyberwar/Deadlock/CAD files/baseplate v0.3.sldasm

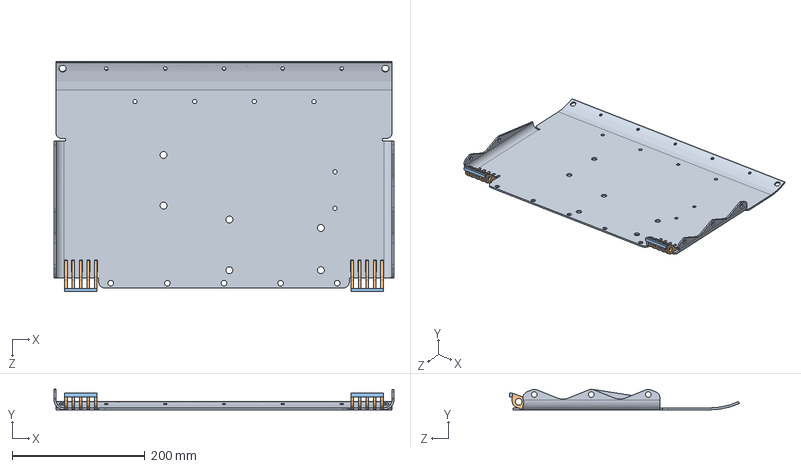
[picture p42: CAD file, 2017-03-15]
CAD files/baseplate v0.3.sldasm
513.0 x 31.0 x 346.4 mm
base1v2
base2v2 x 10
base3v2 x 2
