TeamCyberwar/Deadlock/CAD files/gearmotor assembly v3.SLDASM

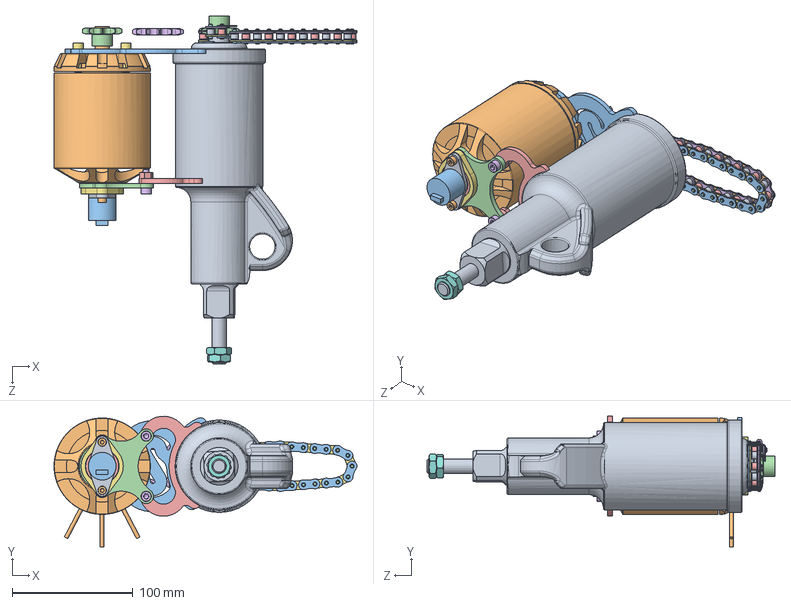
[picture p43: CAD file, 2017-03-15]
CAD files/gearmotor assembly v3.SLDASM
251.4 x 108.3 x 288.6 mm
torque multiplier v2
C80100 50kv v2
motor rear mount v0.2
motor bearing support v2
6001 ball bearing
ISO 4762 M5 x 16 - 16N x 2
M5 x 20 x 4
thin M12 - Nut x 2
encoder mounting plate
M4 x 12 - 12N x 2
AEAT-6010-A06
9T 06b1 x 2
motor rear mount bracket v0.3
Inner_(Mirror_#1) x 15
Inner x 15
Pin x 15
Roller x 15
Outer_(Mirror_#1) x 15
Outer x 15
Pin_(Mirror_#3) x 15
Roller_(Mirror_#4) x 15
weapon first stage chain tensioner
motor rear bearing support
