TeamCyberwar/Deadlock/CAD files/wedgelet assembly.sldasm

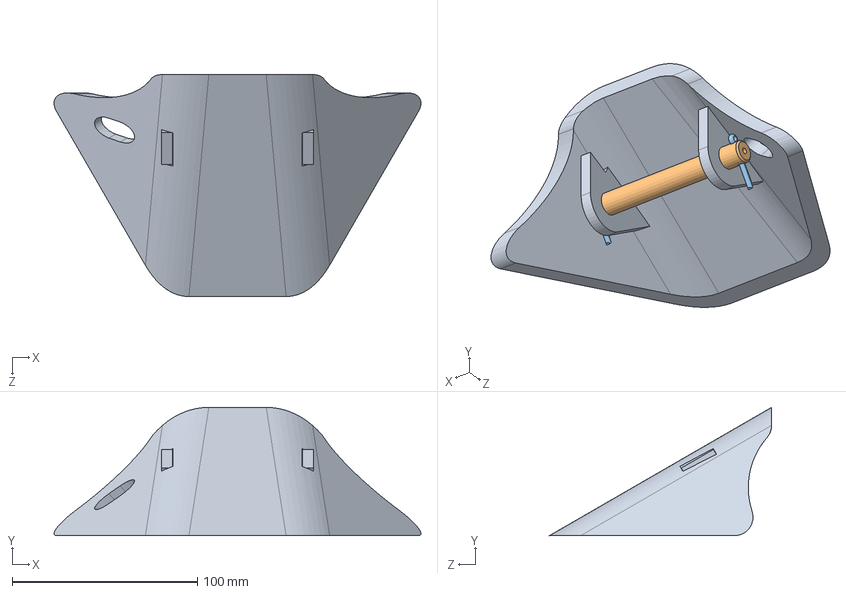
[picture p44: CAD file, 2017-03-15]
CAD files/wedgelet assembly.sldasm
198.2 x 69.3 x 120.0 mm
wedgelet for laser cutting 6mm
M12 based wedgelet pin
split pin x 2
