TeamCyberwar/Deadlock/dogfood/SB drive pod.SLDASM

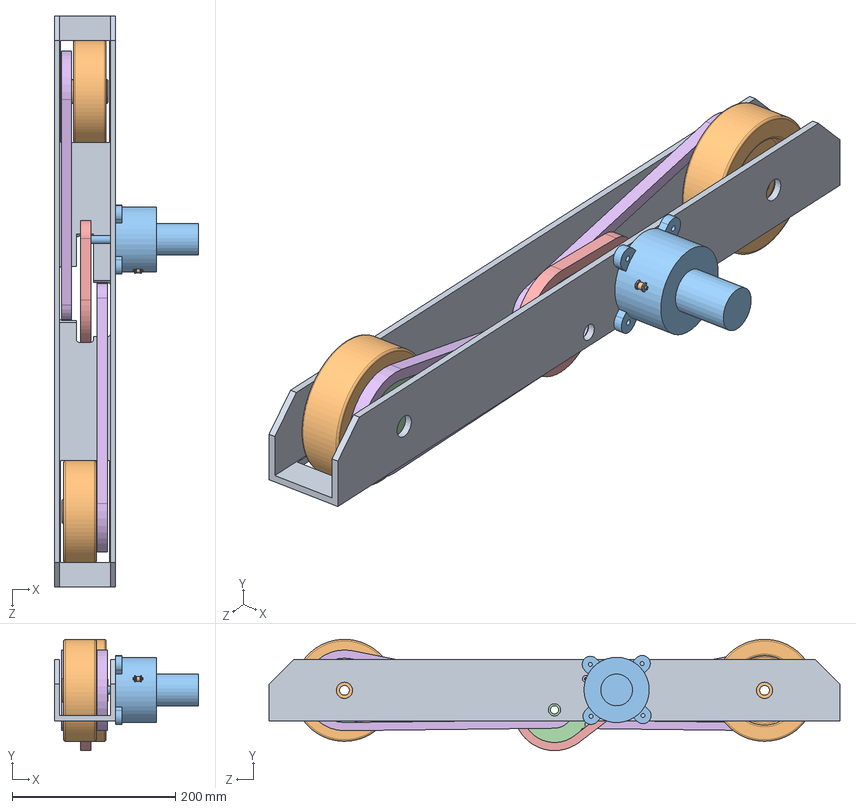
[picture p45: CAD file, 2017-03-15]
dogfood/SB drive pod.SLDASM
177.0 x 136.4 x 700.0 mm
3x3channel
125mm wheel 458-9670 x 2
Outer_(Mirror_#1) x 2
Outer x 2
Inner_(Mirror_#1) x 2
Inner x 2
Pin_(Mirror_#3) x 2
Pin x 2
Roller_(Mirror_#4) x 2
Roller x 2
simplified 50cc
short pitch roller chain wheel_s_iso x 6
1st chain
2nd chain x 2
