TeamCyberwar/Deadlock/(list of files, cad)

Other CAD files:
dogfood/Mirror06B-1a80.SLDASM
dogfood/Mirror06B-1a52.SLDASM
dogfood/Mirror06B-1a64.SLDASM
dogfood/Mirror06B-1a13.SLDASM
dogfood/Mirror06B-1a27.SLDASM
dogfood/Mirror06B-1b13.SLDASM
dogfood/Mirror06B-1b44.SLDASM
dogfood/Mirror06B-1a60.SLDASM
dogfood/Mirror06B-1b64.SLDASM
eVESC/1455K Channel and Cover 120mm.sldasm
dogfood/Mirror06B-1a68.SLDASM
dogfood/Mirror06B-1a25.SLDASM
dogfood/Mirror06B-1b75.SLDASM
dogfood/Mirror06B-1b49.SLDASM
dogfood/Mirror06B-1a19.SLDASM
dogfood/Mirror06B-1b54.SLDASM
dogfood/Mirror06B-1a54.SLDASM
dogfood/Mirror06B-1a26.SLDASM
dogfood/Mirror06B-1a30.SLDASM
dogfood/Mirror06B-1b74.SLDASM
dogfood/Mirror06B-1a34.SLDASM
dogfood/Mirror06B-1b55.SLDASM
dogfood/Mirror06B-1a59.SLDASM
dogfood/Mirror06B-1b63.SLDASM
dogfood/Mirror06B-1a3.SLDASM
dogfood/Mirror06B-1a31.SLDASM
dogfood/Mirror06B-1a15.SLDASM
dogfood/Mirror06B-1a62.SLDASM
dogfood/Mirror06B-1b68.SLDASM
dogfood/Mirror06B-1a53.SLDASM
dogfood/Mirror06B-1b18.SLDASM
dogfood/Mirror06B-1a41.SLDASM
dogfood/Mirror06B-1a57.SLDASM
dogfood/Mirror06B-1a10.SLDASM
dogfood/Mirror06B-1a70.SLDASM
dogfood/Mirror06B-1b59.SLDASM
dogfood/Mirror06B-1b16.SLDASM
dogfood/Mirror06B-1b23.SLDASM
dogfood/Mirror06B-1a21.SLDASM
dogfood/Mirror06B-1a74.SLDASM
dogfood/Mirror06B-1a11.SLDASM
dogfood/Mirror06B-1a66.SLDASM
dogfood/Mirror06B-1a75.SLDASM
dogfood/Mirror06B-1b36.SLDASM
CAD files/clamp assembly v0.5.SLDASM
dogfood/Mirror06B-1a56.SLDASM
dogfood/Mirror06B-1a22.SLDASM
dogfood/Mirror06B-1b25.SLDASM
dogfood/Mirror06B-1b28.SLDASM
dogfood/Mirror06B-1a44.SLDASM
dogfood/Mirror06B-1a28.SLDASM
dogfood/Mirror06B-1a71.SLDASM
dogfood/Mirror06B-1b56.SLDASM
dogfood/Mirror06B-1b79.SLDASM
dogfood/Mirror06B-1b57.SLDASM
dogfood/Mirror06B-1b15.SLDASM
dogfood/Mirror06B-1b22.SLDASM
dogfood/Mirror06B-1a12.SLDASM
dogfood/Mirror06B-1b32.SLDASM
dogfood/Mirror06B-1b52.SLDASM
dogfood/Mirror06B-1a33.SLDASM
dogfood/Mirror06B-1a8.SLDASM
dogfood/Mirror06B-1b70.SLDASM
dogfood/Mirror06B-1a5.SLDASM
dogfood/Mirror06B-1b46.SLDASM
dogfood/Mirror06B-1a72.SLDASM
dogfood/Mirror06B-1b19.SLDASM
dogfood/Mirror06B-1b72.SLDASM
dogfood/Mirror06B-1b6.SLDASM
dogfood/Mirror06B-1a39.SLDASM
dogfood/Mirror06B-1b31.SLDASM
dogfood/Mirror06B-1b26.SLDASM
dogfood/Mirror06B-1a29.SLDASM
dogfood/Mirror06B-1b78.SLDASM
dogfood/Mirror06B-1a69.SLDASM
dogfood/Mirror06B-1a47.SLDASM
dogfood/Mirror06B-1b42.SLDASM
dogfood/16B-2a.SLDASM
dogfood/Mirror06B-1a40.SLDASM
dogfood/Mirror06B-1a18.SLDASM
dogfood/Mirror06B-1b45.SLDASM
dogfood/Mirror06B-1b21.SLDASM
dogfood/Mirror06B-1b73.SLDASM
dogfood/Mirror06B-1a17.SLDASM
dogfood/Mirror06B-1a2.SLDASM
dogfood/Mirror06B-1a46.SLDASM
dogfood/Mirror06B-1b71.SLDASM
dogfood/Mirror06B-1a50.SLDASM
dogfood/Mirror06B-1a35.SLDASM
dogfood/Mirror06B-1b2.SLDASM
dogfood/Mirror06B-1b20.SLDASM
dogfood/Mirror06B-1b11.SLDASM
dogfood/Mirror06B-1a45.SLDASM
dogfood/Mirror06B-1b65.SLDASM
dogfood/Mirror06B-1a48.SLDASM
dogfood/Mirror06B-1b67.SLDASM
dogfood/Mirror06B-1b17.SLDASM
dogfood/Mirror06B-1b9.SLDASM
dogfood/Mirror06B-1b35.SLDASM
dogfood/Mirror06B-1a.SLDASM
dogfood/Mirror06B-1a20.SLDASM
dogfood/Mirror06B-1b69.SLDASM
dogfood/Mirror06B-1b51.SLDASM
dogfood/Mirror06B-1a79.SLDASM
dogfood/Mirror06B-1b80.SLDASM
dogfood/Mirror06B-1b5.SLDASM
dogfood/Mirror06B-1a9.SLDASM
dogfood/Mirror06B-1b37.SLDASM
dogfood/Mirror06B-1b38.SLDASM
dogfood/Mirror06B-1a32.SLDASM
dogfood/Mirror06B-1b4.SLDASM
dogfood/Mirror06B-1b58.SLDASM
dogfood/Mirror06B-1a7.SLDASM
dogfood/Mirror06B-1b12.SLDASM
dogfood/Mirror06B-1a4.SLDASM
CAD files/06b1 15T.SLDDRW
CAD files/06b1 15T.sldprt
CAD files/125mm wheel v2.SLDDRW
CAD files/12B3 10T.SLDDRW
CAD files/12B3 10T.sldprt
CAD files/1301-NSK self aligning bearing.SLDPRT
CAD files/15Z 06B-3 --15SB75H50L24.0R1.SLDDRW
CAD files/15Z 06B-3 idler.SLDDRW
CAD files/15mm hdpe 408 3857.SLDPRT
CAD files/160mm nylon rod.SLDPRT
CAD files/16mm rod.SLDPRT
CAD files/20mm hdpe 408 3863.SLDPRT
CAD files/21T 06b3 clutch.SLDDRW
CAD files/21T 06b3 clutch.sldprt
CAD files/23T 06b1.SLDDRW
CAD files/23Z 06B-1.sldprt
CAD files/2mm acetal.SLDPRT
CAD files/30T 06b1.SLDDRW
CAD files/30T 06b1.sldprt
CAD files/30mm hdpe 408 3885.SLDPRT
CAD files/3201-0403 quick release pin.SLDPRT
CAD files/33010.SLDPRT
CAD files/35304.SLDPRT
CAD files/3mm acetal.SLDPRT
CAD files/50mm silver steel 447-8902.SLDPRT
CAD files/57T 06b3 v0.2.SLDDRW
CAD files/57T 06b3 v0.2.sldprt
CAD files/5ah 5s.SLDPRT
CAD files/5mm delrin 514 338.SLDPRT
CAD files/6mm delrin 325 7057.SLDPRT
CAD files/80mm wheel 4.SLDDRW
CAD files/80mm wheel 4.SLDPRT
CAD files/9T 06b1.SLDDRW
CAD files/9T 06b1.sldprt
CAD files/9T 06b3.SLDDRW
CAD files/9T 06b3.sldprt
CAD files/AEAT-6010-A06.SLDPRT
CAD files/C80100 50kv v2.SLDPRT
CAD files/C80100 50kv.SLDPRT
CAD files/Cable Tie.SLDPRT
CAD files/Cable Tie2.SLDPRT
CAD files/Cable Tie3.SLDPRT
CAD files/EC3 Male contact.sldprt
CAD files/EC5 Male housing.sldprt
CAD files/IRT2020.SLDPRT
CAD files/KR5G5-100P.SLDPRT
CAD files/M12 based wedgelet pin .SLDDRW
CAD files/M12 based wedgelet pin .sldprt
CAD files/M3 clinch nut RS 827 603.sldprt
CAD files/M4 barrel nut.SLDPRT
CAD files/M6 penny washer.sldprt
CAD files/M8 barrel nut.SLDPRT
CAD files/Mirror1301-NSK self aligning bearing.SLDPRT
CAD files/Mirror80mm wheel 4.SLDPRT
CAD files/MirrorC80100 50kv.SLDPRT
CAD files/MirrorM4 barrel nut.SLDPRT
CAD files/MirrorOBF253020 Flanged Oilite.SLDPRT
CAD files/Mirrordrive motor bearing spacer.SLDPRT
CAD files/Mirrordrive pod base v0.4.SLDPRT
CAD files/Mirrordrive pod v0.8.SLDASM
CAD files/Mirrorfront drive chain keeper.SLDPRT
CAD files/Mirrorfront wheel axle2.SLDPRT
CAD files/Mirrorfront wheel mount flared2.SLDPRT
CAD files/Mirrorinner flange plate.SLDPRT
CAD files/Mirrorinner spacer plate v0.2.SLDPRT
CAD files/Mirrornylon tube v3.SLDPRT
CAD files/Mirrorouter inner anti friction ring v3.SLDPRT
CAD files/Mirrorpod tube flared v0.8.SLDPRT
CAD files/Mirrorrear drive chain keeper.SLDPRT
CAD files/Mirrorrear wheel axle.SLDPRT
CAD files/Mirrorrear wheel mount flaredv0.6.SLDPRT
CAD files/OBF253020 Flanged Oilite.SLDPRT
CAD files/RS513-925 24mmID needle bearing.sldprt
CAD files/USB-Socket.SLDPRT
CAD files/VGS_5_PART1.sldprt
CAD files/XT30_Buchse.sldprt
CAD files/XT30_Stecker.sldprt
CAD files/bananaforscale.SLDPRT
CAD files/base1.SLDDRW
CAD files/base1.sldprt
CAD files/base1fordxf.SLDDRW
CAD files/base1v2.SLDDRW
CAD files/base1v2.sldprt
CAD files/base1v2fordxf.SLDDRW
CAD files/base2.sldprt
CAD files/base2fordxf.SLDDRW
CAD files/base2forscale.SLDDRW
CAD files/base2v2.sldprt
CAD files/base2v2fordxf.SLDDRW
CAD files/base2v2forscale.SLDDRW
CAD files/base3.sldprt
CAD files/base3fordxf.SLDDRW
CAD files/base3forscale.SLDDRW
CAD files/base3v2.sldprt
CAD files/base3v2fordxf.SLDDRW
CAD files/base3v2forscale.SLDDRW
CAD files/baseplate v0.2 sheetmetal.SLDPRT
CAD files/baseplate v0.2.SLDDRW
CAD files/baseplate v0.2.SLDPRT
CAD files/baseplate v0.2.sldasm
CAD files/baseplate v0.3 sheetmetal.SLDPRT
CAD files/baseplate v0.3.SLDDRW
CAD files/battery backboard v4.SLDDRW
CAD files/battery backboard v4.SLDPRT
CAD files/battery backboard v4fordxf.SLDDRW
CAD files/battery box bottom plate v2 fordxf.SLDDRW
CAD files/battery box bottom plate v2.SLDDRW
CAD files/battery box bottom plate v2.SLDPRT
CAD files/battery box side plate v2.SLDDRW
CAD files/battery box side plate v2.SLDPRT
CAD files/battery box side plate v2fordxf.SLDDRW
CAD files/battery box top plate v4 for dxf.SLDDRW
CAD files/battery box top plate v4.SLDDRW
CAD files/battery box top plate v4.SLDPRT
CAD files/battery foam2.SLDPRT
CAD files/battery pack top plate fordxf.SLDDRW
CAD files/battery pack top plate forscale.SLDDRW
CAD files/battery pack top plate.SLDPRT
CAD files/battery velcro grommet.SLDPRT
CAD files/battery velcro.SLDPRT
CAD files/belleville washer.SLDPRT
CAD files/cabletie holder.SLDPRT
CAD files/castle BAT connector.SLDPRT
CAD files/castle ESC connector.SLDPRT
CAD files/castlecreations 6.5 connector.SLDPRT
CAD files/clamp arm pins.SLDDRW
CAD files/clamp arm pins.SLDPRT
CAD files/clamp arm top chain pin.SLDDRW
CAD files/clamp arm top chain pin.SLDPRT
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
