TeamCyberwar/Deadlock/dogfood/lifter test bed/testbed1.PNG

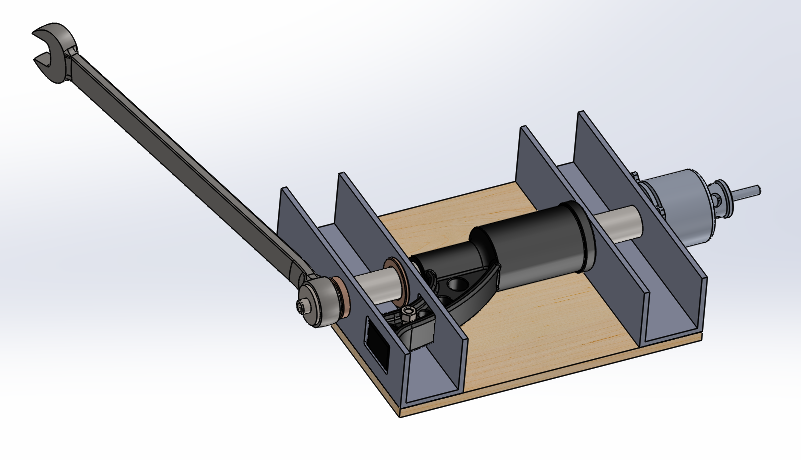
dogfood/lifter test bed/testbed1.PNG
