TeamCyberwar/Deadlock/drawings and step files/folding/clamp10.PDF

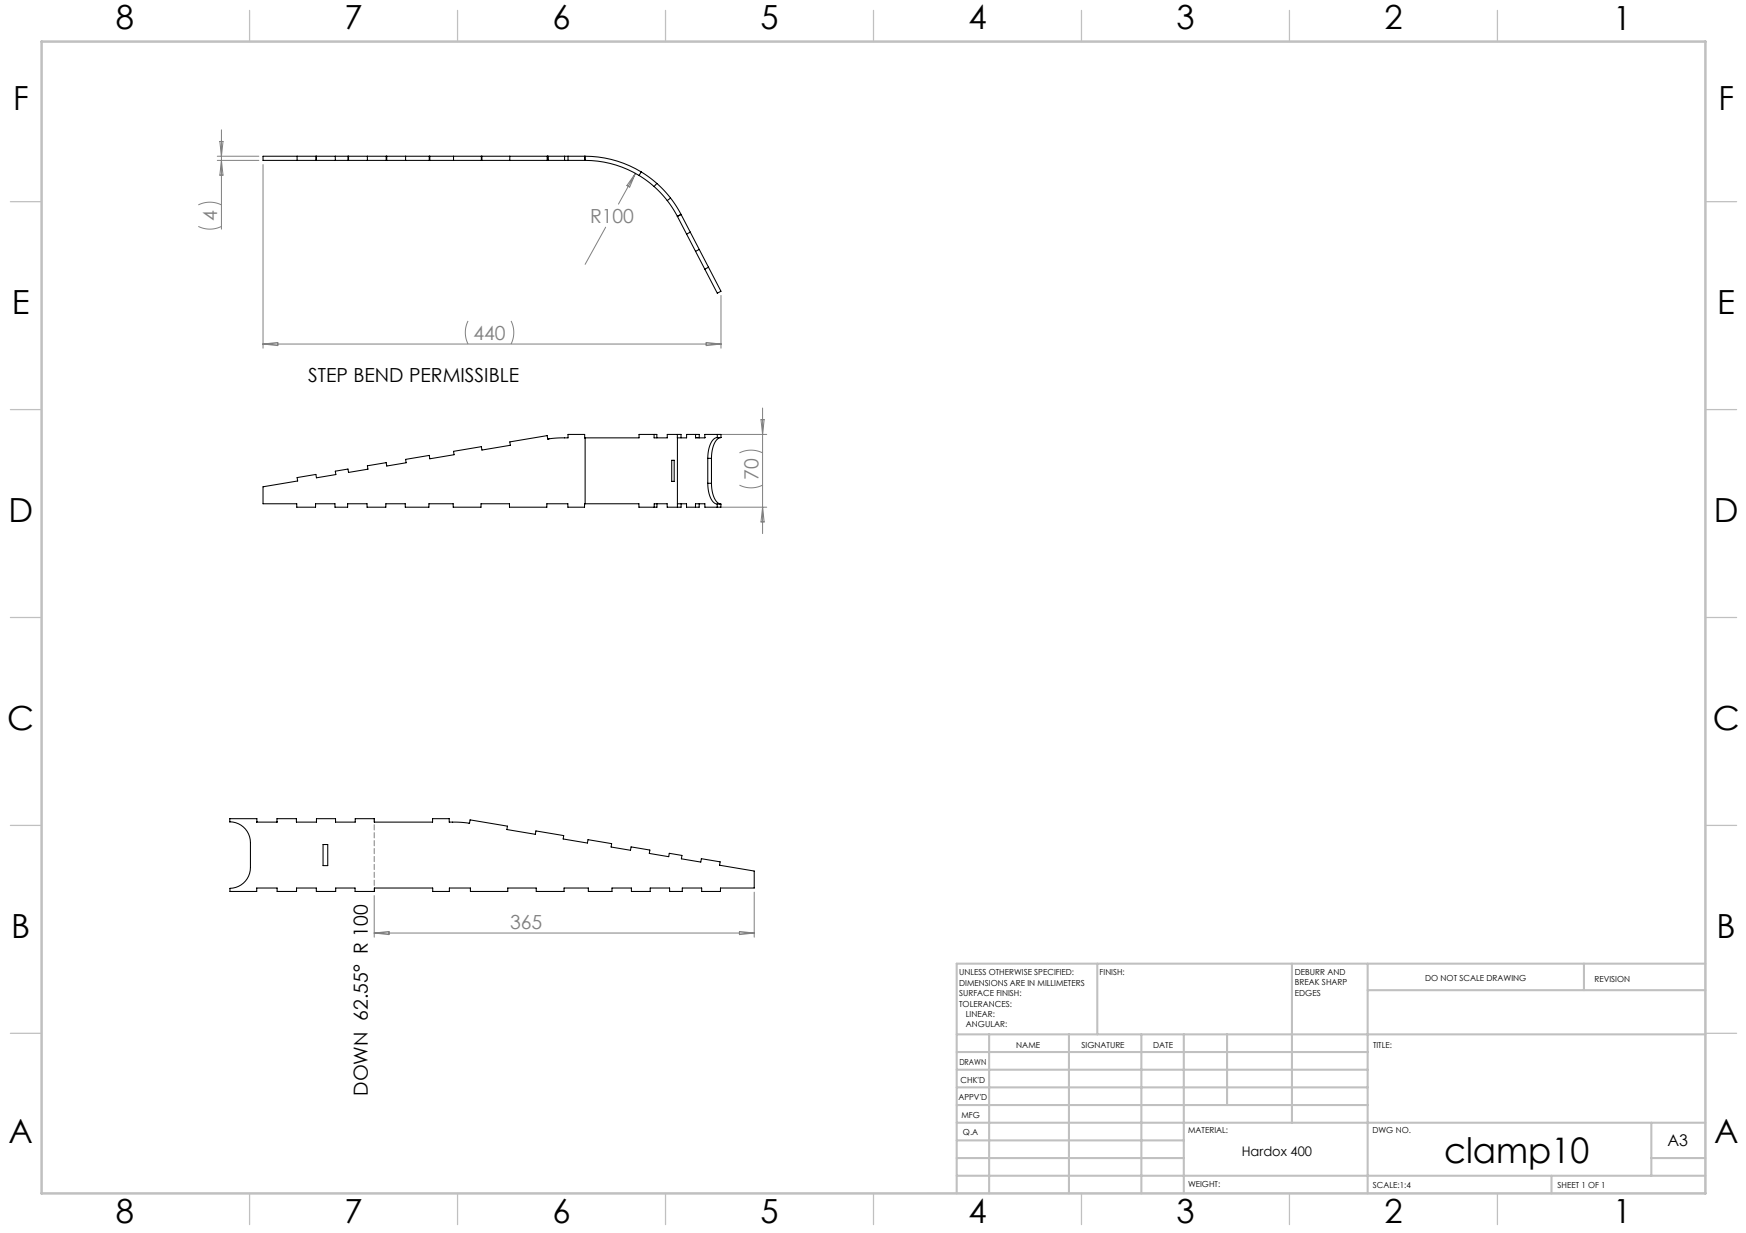
[picture p50: page 1]
DOWN 62.55° R 100; FINISH:; DEBURR AND; BREAK SHARP; DO NOT SCALE DRAWING; REVISION; SCALE:1:4; SHEET 1 OF 1

STEP BEND PERMISSIBLE

UNLESS OTHERWISE SPECIFIED:
DIMENSIONS ARE IN MILLIMETERS
SURFACE FINISH:
TOLERANCES:
LINEAR:
ANGULAR:

NAME | SIGNATURE | DATE | | | | TITLE:

DRAWN
CHK'D
APPV'D
MFG
Q.A | | | | MATERIAL: | DWG NO. clamp10 | A3 Hardox 400
