TeamCyberwar/Deadlock/drawings and step files/folding/front wheel mount flared2.PDF

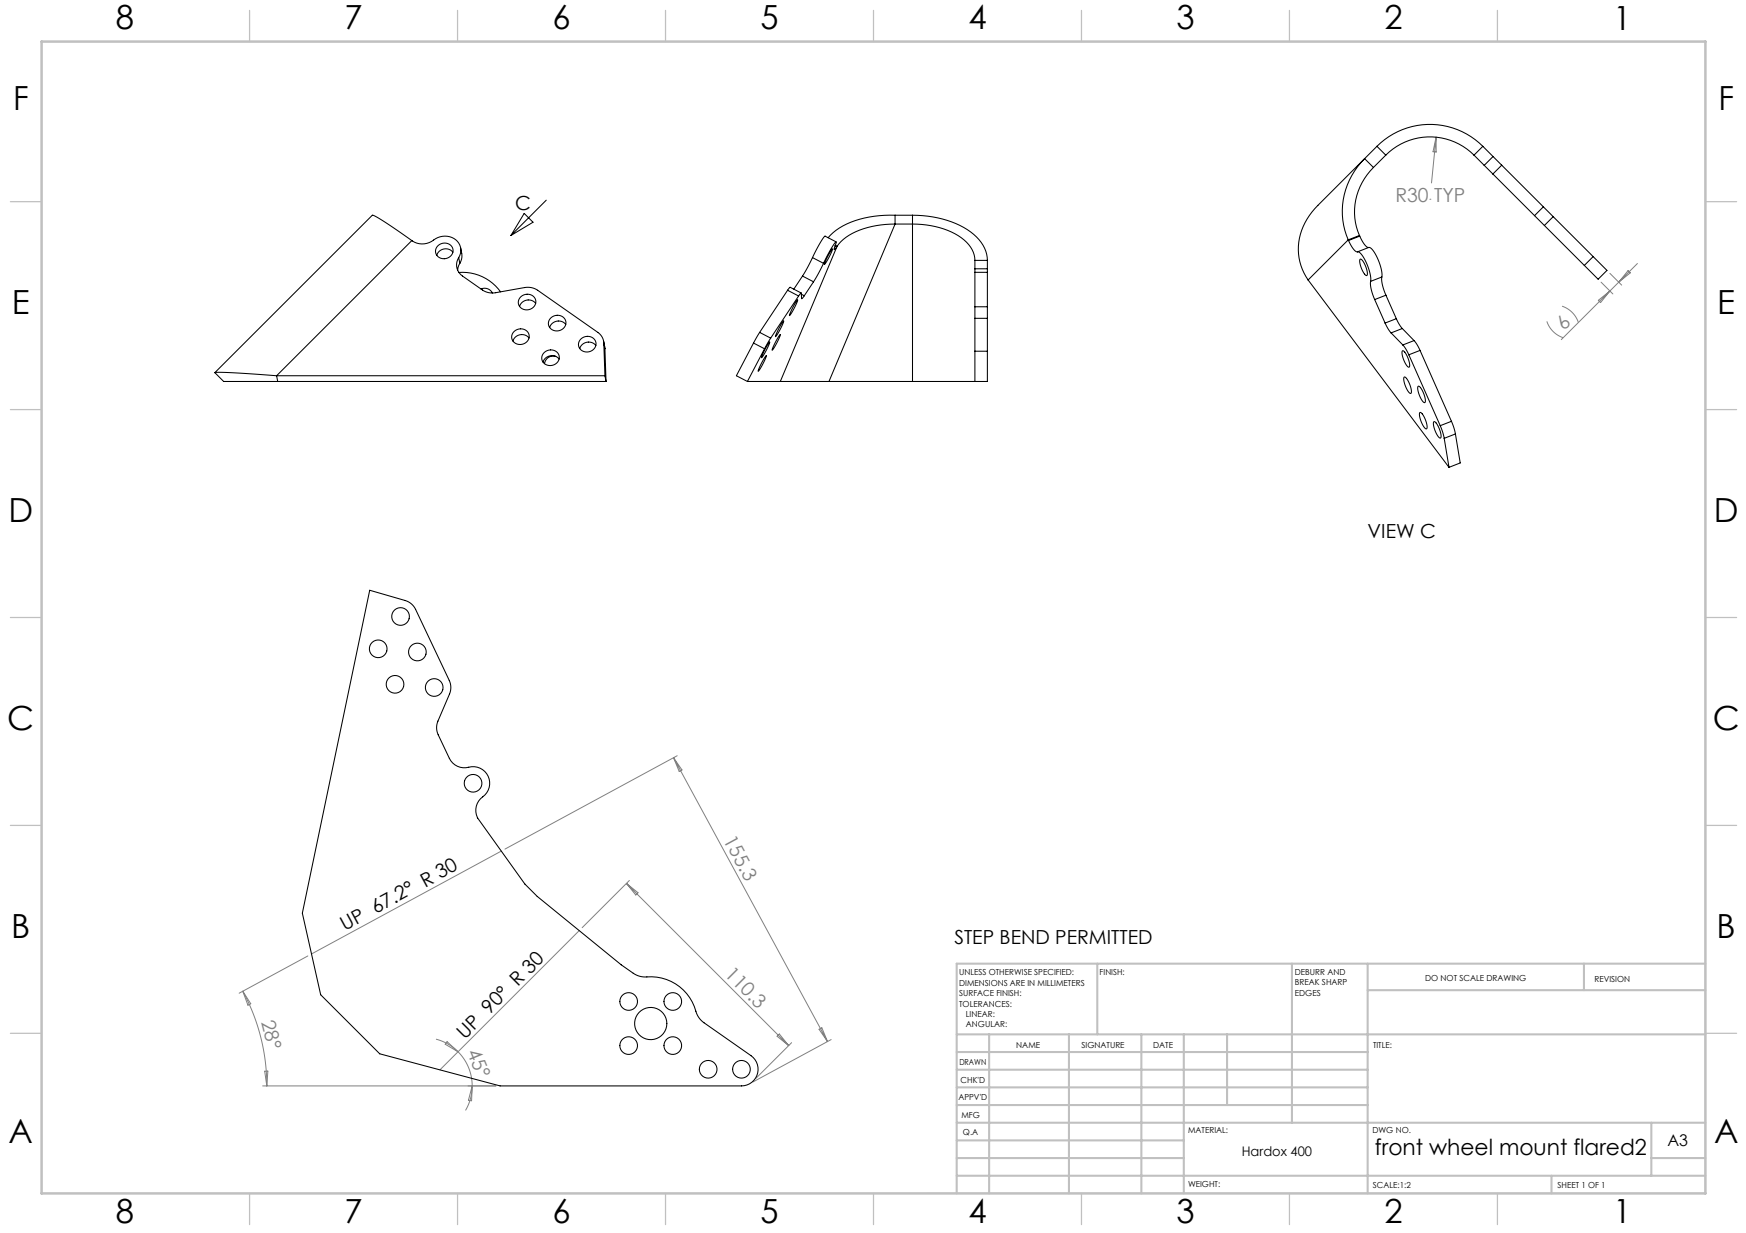
[picture p54: page 1]
R30 TYP; VIEW C; FINISH:; DEBURR AND; BREAK SHARP; DO NOT SCALE DRAWING; REVISION; SCALE:1:2; SHEET 1 OF 1

STEP BEND PERMITTED

UNLESS OTHERWISE SPECIFIED:
DIMENSIONS ARE IN MILLIMETERS
SURFACE FINISH:
TOLERANCES:
LINEAR:
ANGULAR:

NAME | SIGNATURE | DATE | | | | TITLE:

DRAWN
CHK'D
APPV'D
MFG
Q.A | | | | MATERIAL: | DWG NO. front wheel mount flared2 | A3 Hardox 400
