TeamCyberwar/Deadlock/drawings and step files/folding/lifter hardox back armour v0.2.PDF

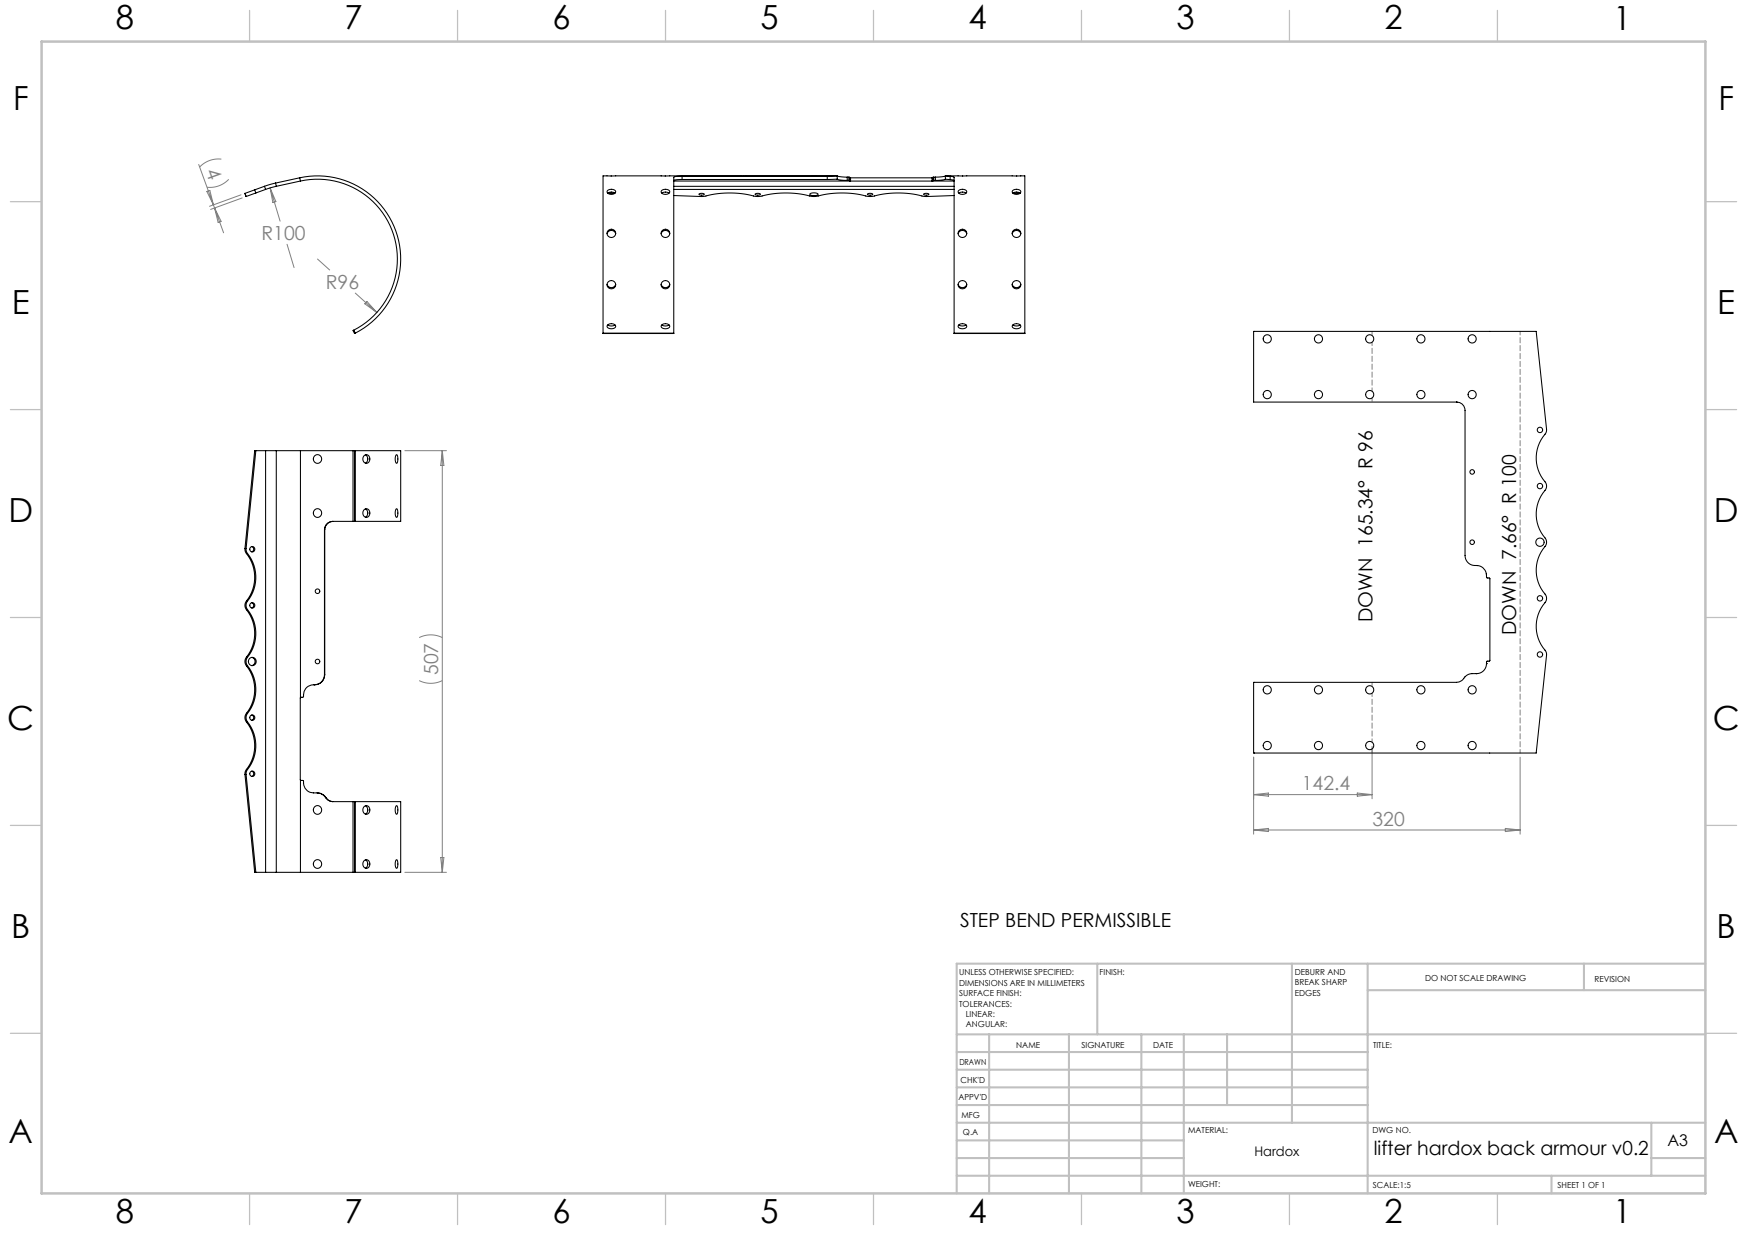
[picture p55: page 1]
DOWN 7.66° R 100; DOWN 165.34° R 96; FINISH:; DEBURR AND; BREAK SHARP; DO NOT SCALE DRAWING; REVISION; SCALE:1:5; SHEET 1 OF 1

STEP BEND PERMISSIBLE

UNLESS OTHERWISE SPECIFIED:
DIMENSIONS ARE IN MILLIMETERS
SURFACE FINISH:
TOLERANCES:
LINEAR:
ANGULAR:

NAME | SIGNATURE | DATE | | | | TITLE:

DRAWN
CHK'D
APPV'D
MFG
Q.A | | | | MATERIAL: | DWG NO. lifter hardox back armour v0.2 | A3 Hardox
