TeamCyberwar/Deadlock/drawings and step files/folding/link cover v2.PDF

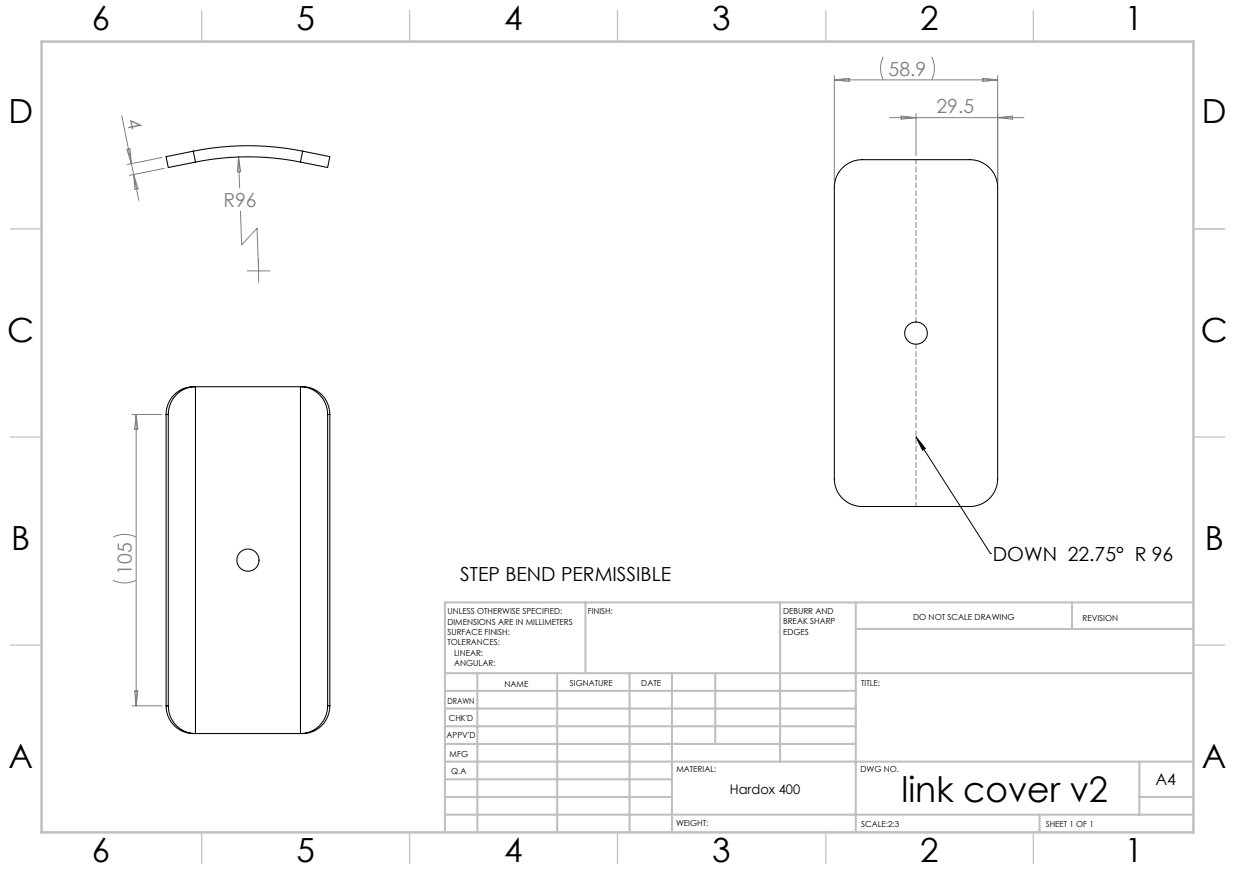
[picture p56: page 1]
DOWN 22.75° R 96; FINISH:; DEBURR AND; BREAK SHARP; DO NOT SCALE DRAWING; REVISION; SCALE:2:3; SHEET 1 OF 1

STEP BEND PERMISSIBLE

UNLESS OTHERWISE SPECIFIED:
DIMENSIONS ARE IN MILLIMETERS
SURFACE FINISH:
TOLERANCES:
LINEAR:
ANGULAR:

NAME | SIGNATURE | DATE | | | | TITLE:

DRAWN
CHK'D
APPV'D
MFG
Q.A | | | | MATERIAL: Hardox 400 | DWG NO. link cover v2 | A4
