TeamCyberwar/Deadlock/drawings and step files/folding/open hex tube.PDF

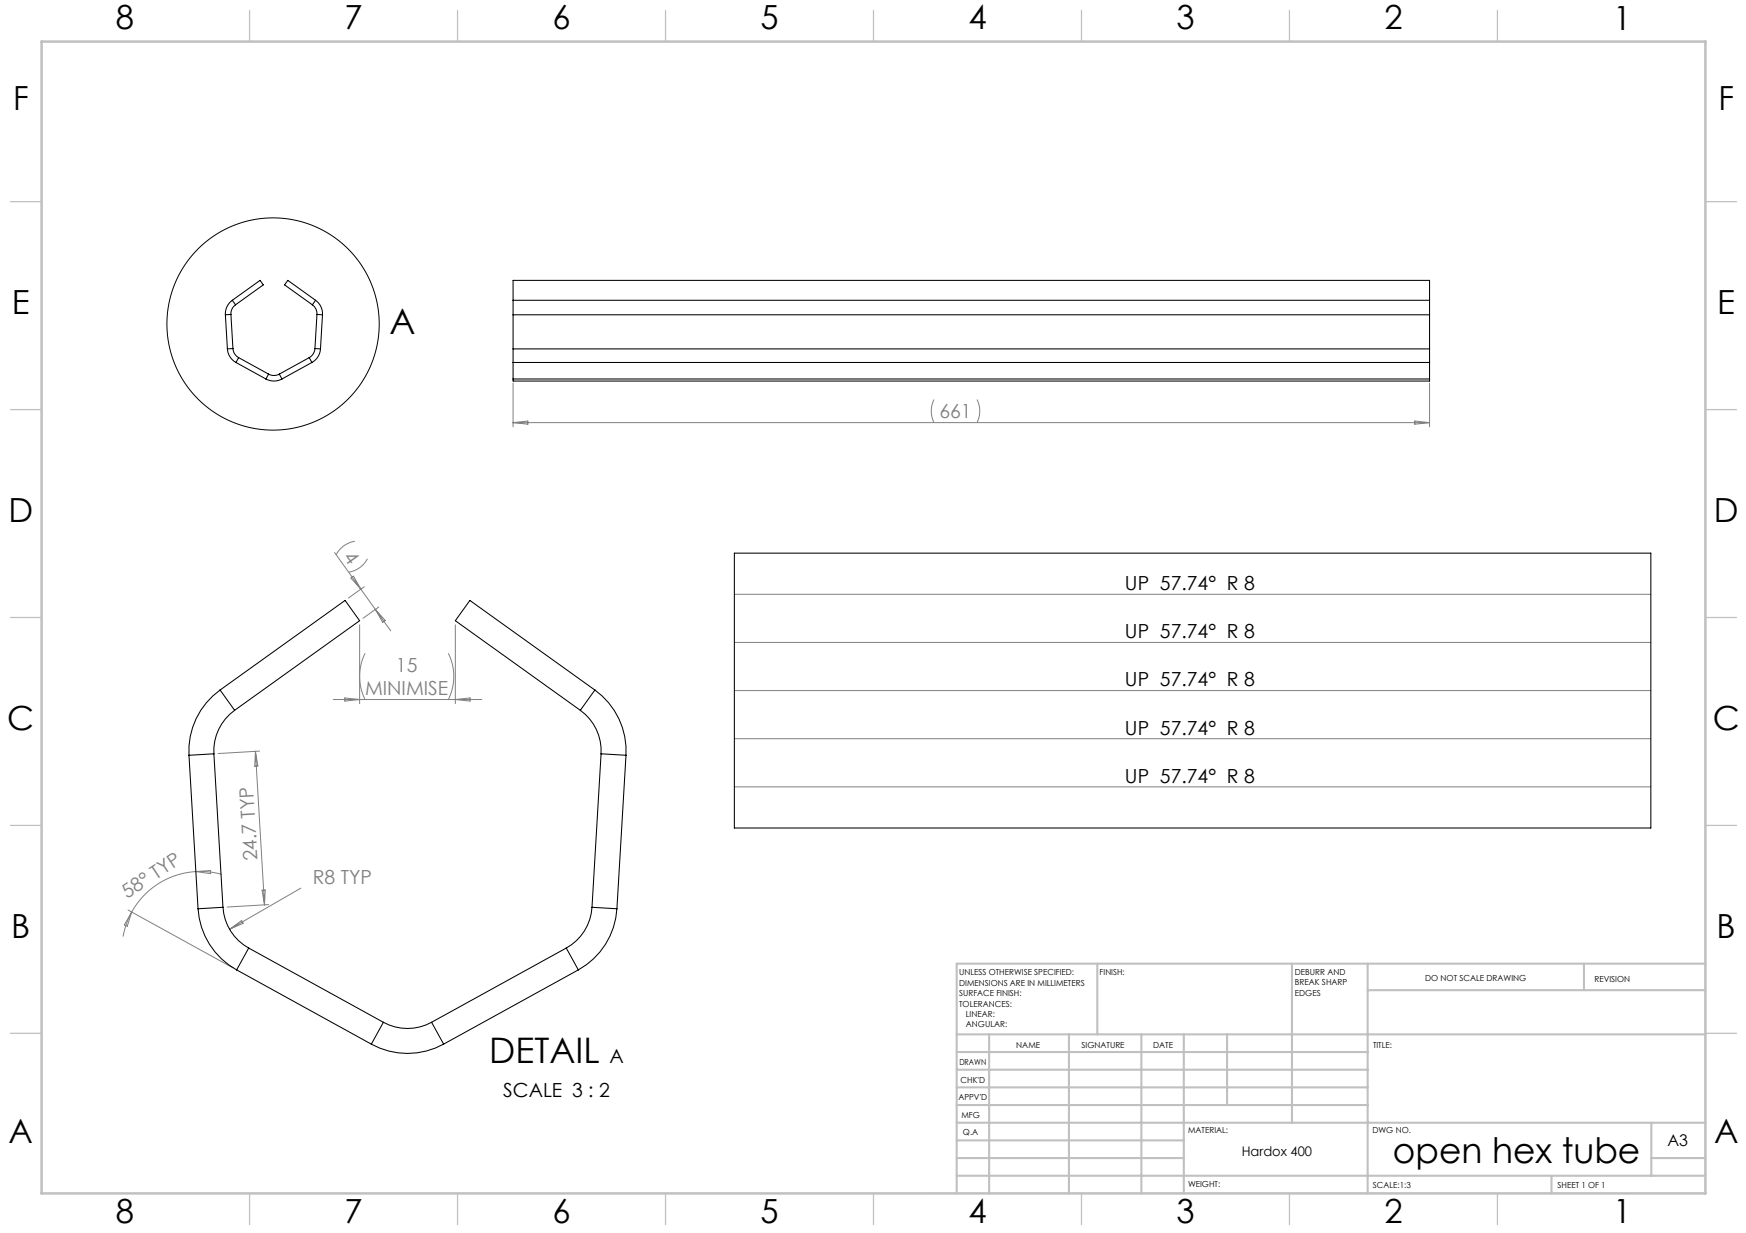
[picture p57: page 1]
24.7 TYP; 58° TYP; R8 TYP; DETAIL A; SCALE 3 : 2; FINISH:; DEBURR AND; BREAK SHARP; DO NOT SCALE DRAWING; REVISION; SCALE:1:3; SHEET 1 OF 1

UNLESS OTHERWISE SPECIFIED:
DIMENSIONS ARE IN MILLIMETERS
SURFACE FINISH:
TOLERANCES:
LINEAR:
ANGULAR:

NAME | SIGNATURE | DATE | | | | TITLE:

DRAWN
CHK'D
APPV'D
MFG
Q.A | | | | MATERIAL: | DWG NO. open hex tube | A3 Hardox 400
