TeamCyberwar/Deadlock/drawings and step files/machining/06b1 15T.PDF

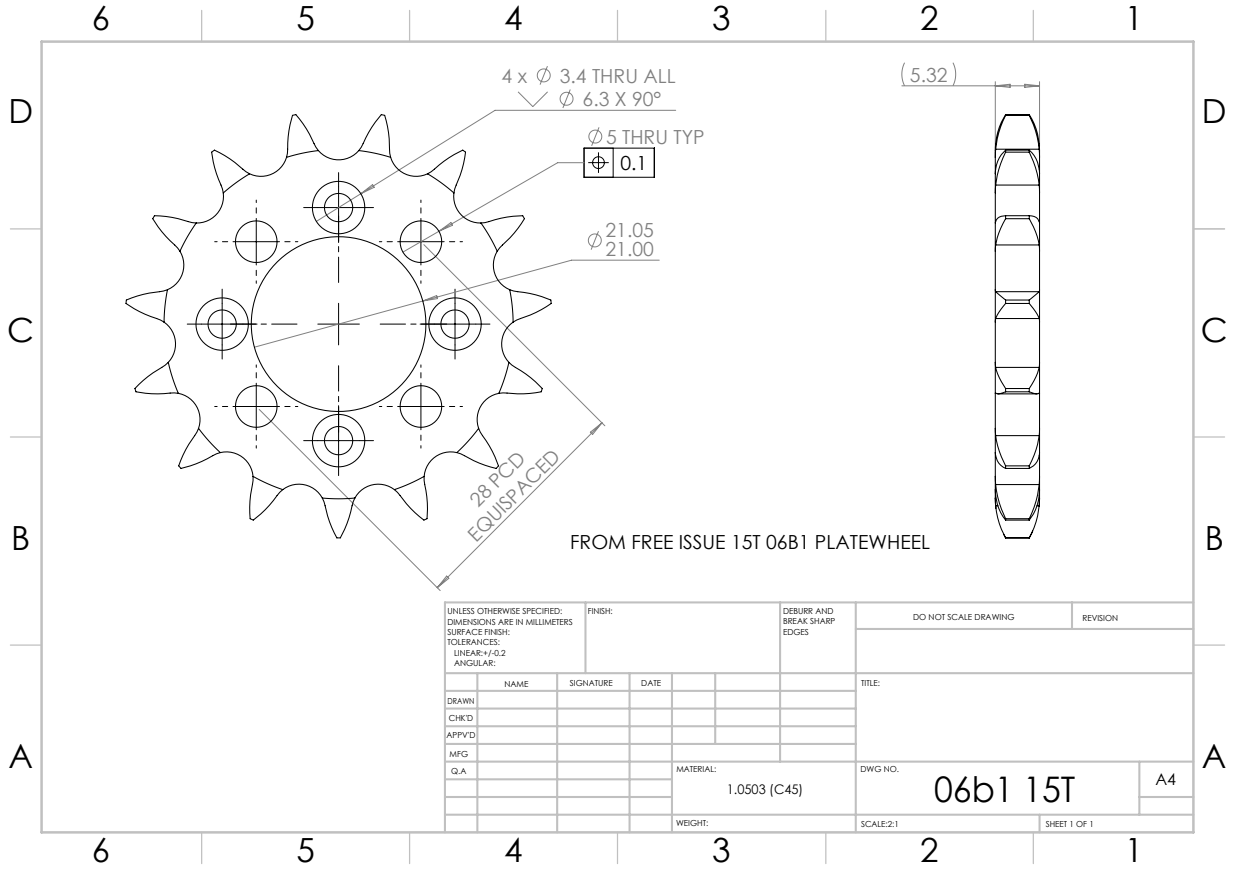
[picture p59: page 1]
28 PCD; 5 THRU TYP; 3.4 THRU ALL; FINISH:; DEBURR AND; BREAK SHARP; DO NOT SCALE DRAWING; REVISION; SCALE:2:1; SHEET 1 OF 1

FROM FREE ISSUE 15T 06B1 PLATEWHEEL

UNLESS OTHERWISE SPECIFIED:
DIMENSIONS ARE IN MILLIMETERS
SURFACE FINISH:
TOLERANCES:
LINEAR:+/-0.2
ANGULAR:

NAME | SIGNATURE | DATE | | | | TITLE:

DRAWN
CHK'D
APPV'D
MFG
Q.A | | | | MATERIAL: | DWG NO. 06b1 15T | A4 1.0503 (C45)
