TeamCyberwar/Deadlock/drawings and step files/machining/12B3 10T.PDF

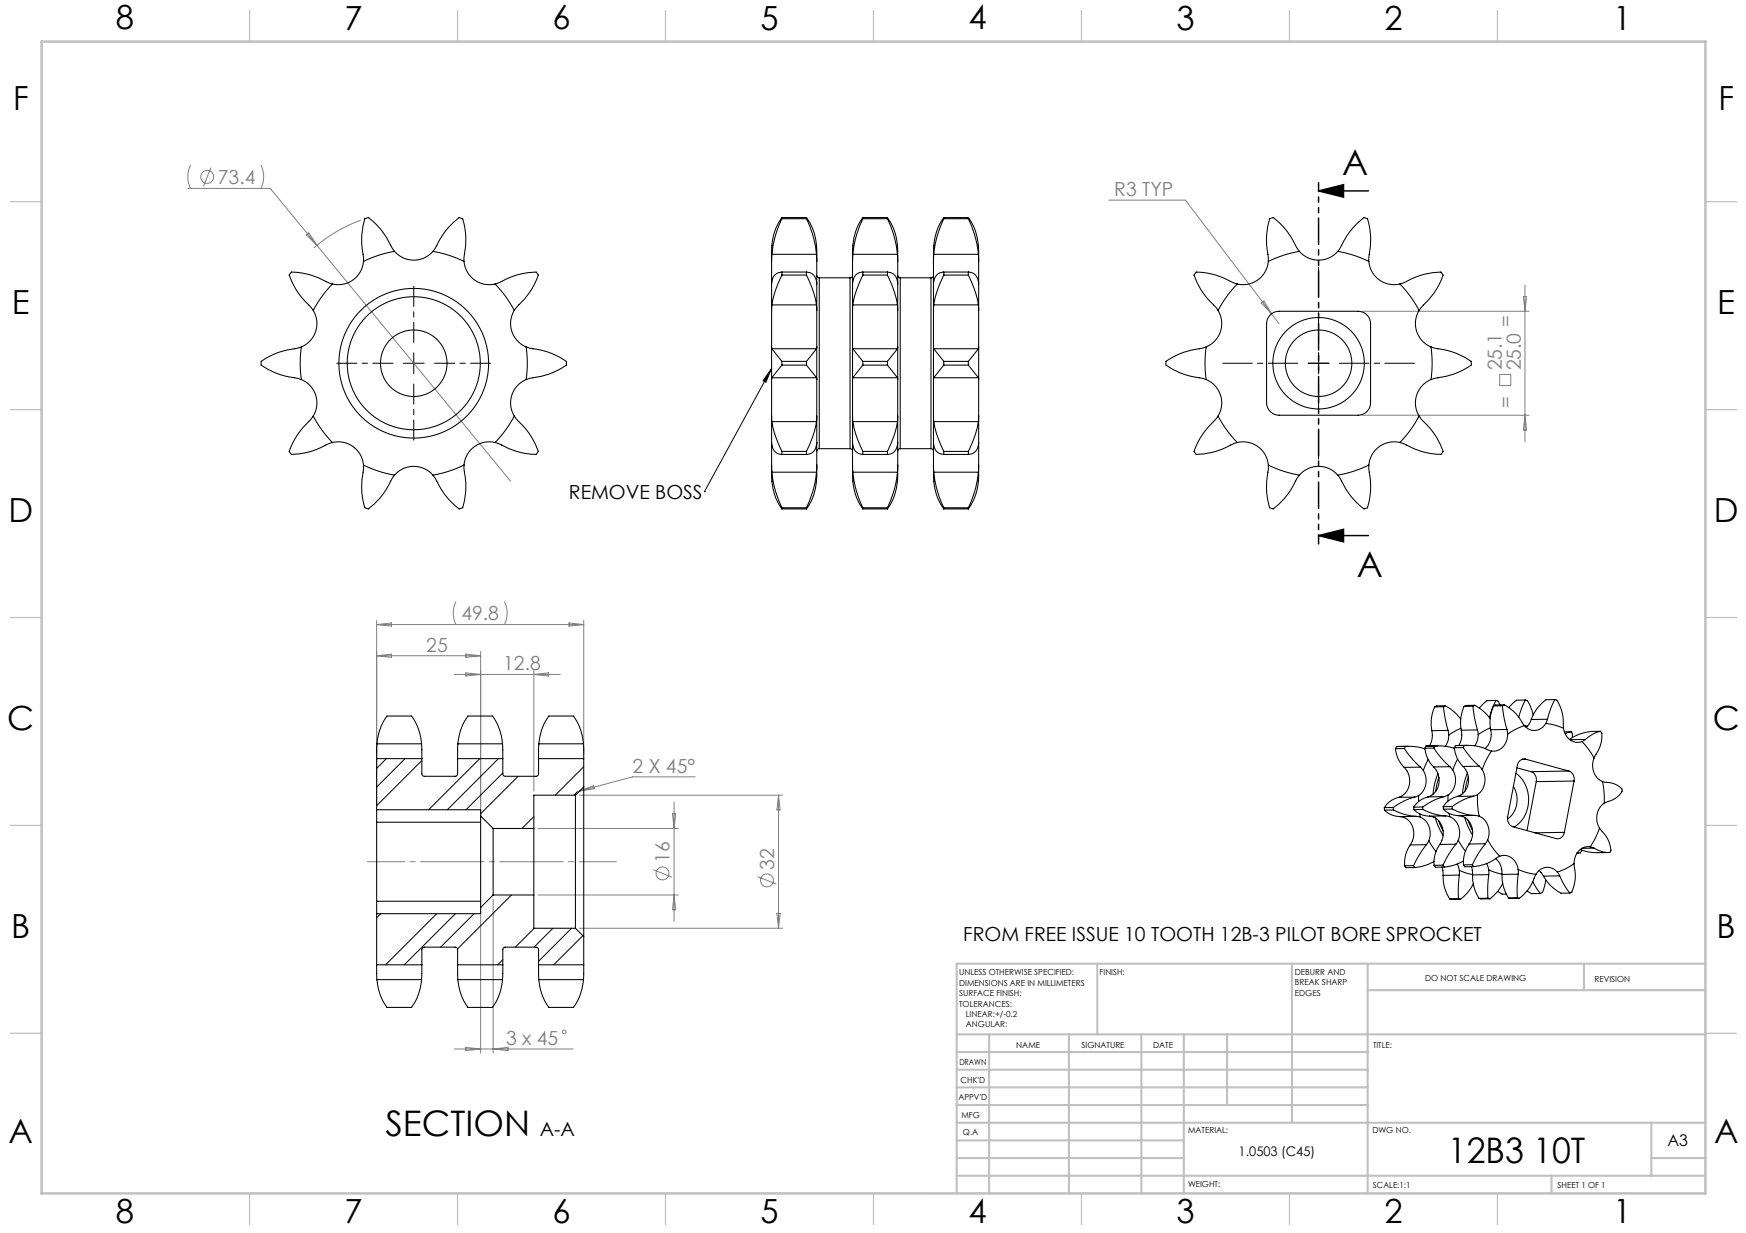
[picture p60: page 1]
REMOVE BOSS; R3 TYP; SECTION A-A; FINISH:; DEBURR AND; BREAK SHARP; DO NOT SCALE DRAWING; REVISION; SCALE:1:1; SHEET 1 OF 1

FROM FREE ISSUE 10 TOOTH 12B-3 PILOT BORE SPROCKET

UNLESS OTHERWISE SPECIFIED:
DIMENSIONS ARE IN MILLIMETERS
SURFACE FINISH:
TOLERANCES:
LINEAR:+/-0.2
ANGULAR:

NAME | SIGNATURE | DATE | | | | TITLE:

DRAWN
CHK'D
APPV'D
MFG
Q.A | | | | MATERIAL: | DWG NO. 12B3 10T | A3 1.0503 (C45)
