TeamCyberwar/Deadlock/drawings and step files/machining/15Z 06B-3 idler.PDF

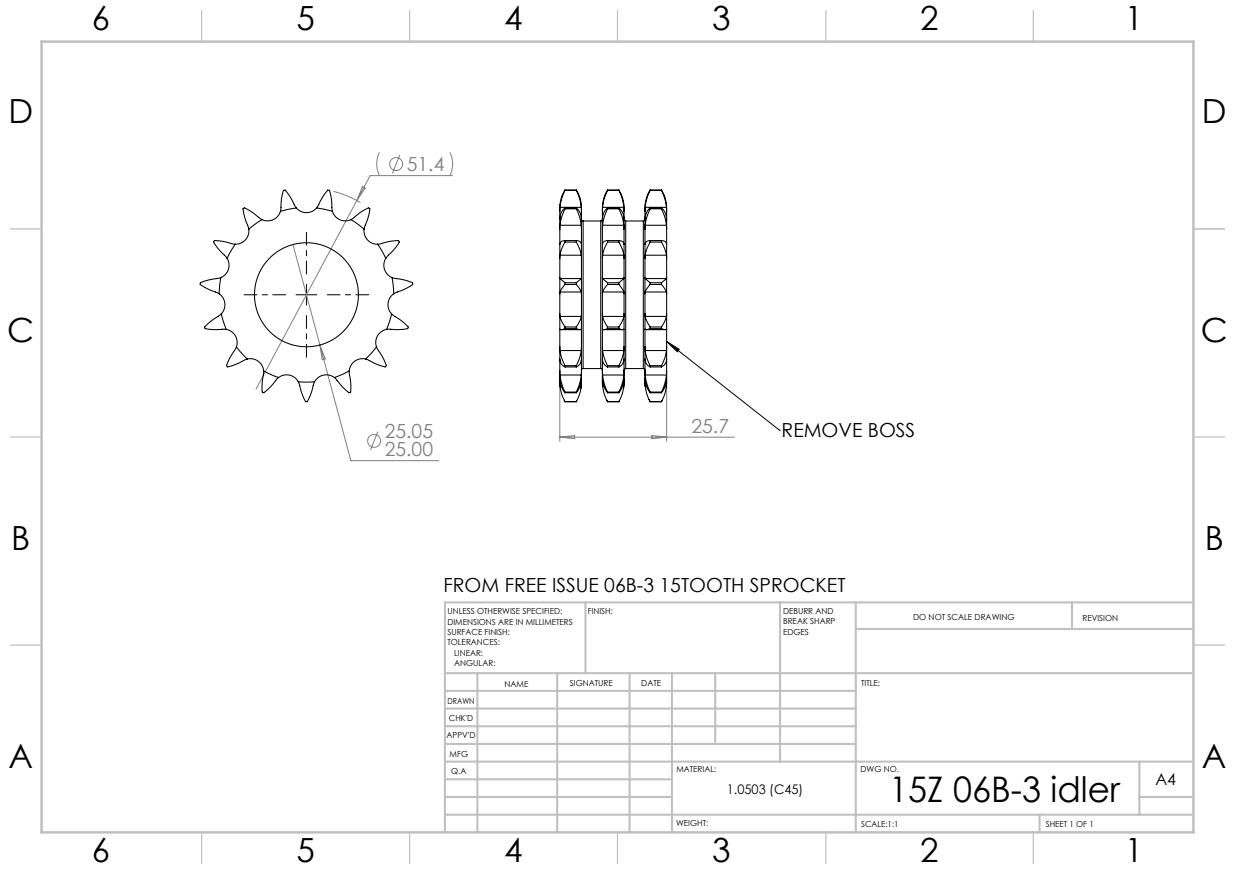
[picture p61: page 1]
REMOVE BOSS; FINISH:; DEBURR AND; BREAK SHARP; DO NOT SCALE DRAWING; REVISION; SCALE:1:1; SHEET 1 OF 1

FROM FREE ISSUE 06B-3 15TOOTH SPROCKET

UNLESS OTHERWISE SPECIFIED:
DIMENSIONS ARE IN MILLIMETERS
SURFACE FINISH:
TOLERANCES:
LINEAR:
ANGULAR:

NAME | SIGNATURE | DATE | | | | TITLE:

DRAWN
CHK'D
APPV'D
MFG
Q.A | | | | MATERIAL: | DWG NO. 15Z 06B-3 idler | A4 1.0503 (C45)
