TeamCyberwar/Deadlock/drawings and step files/machining/21T 06b3 clutch.PDF

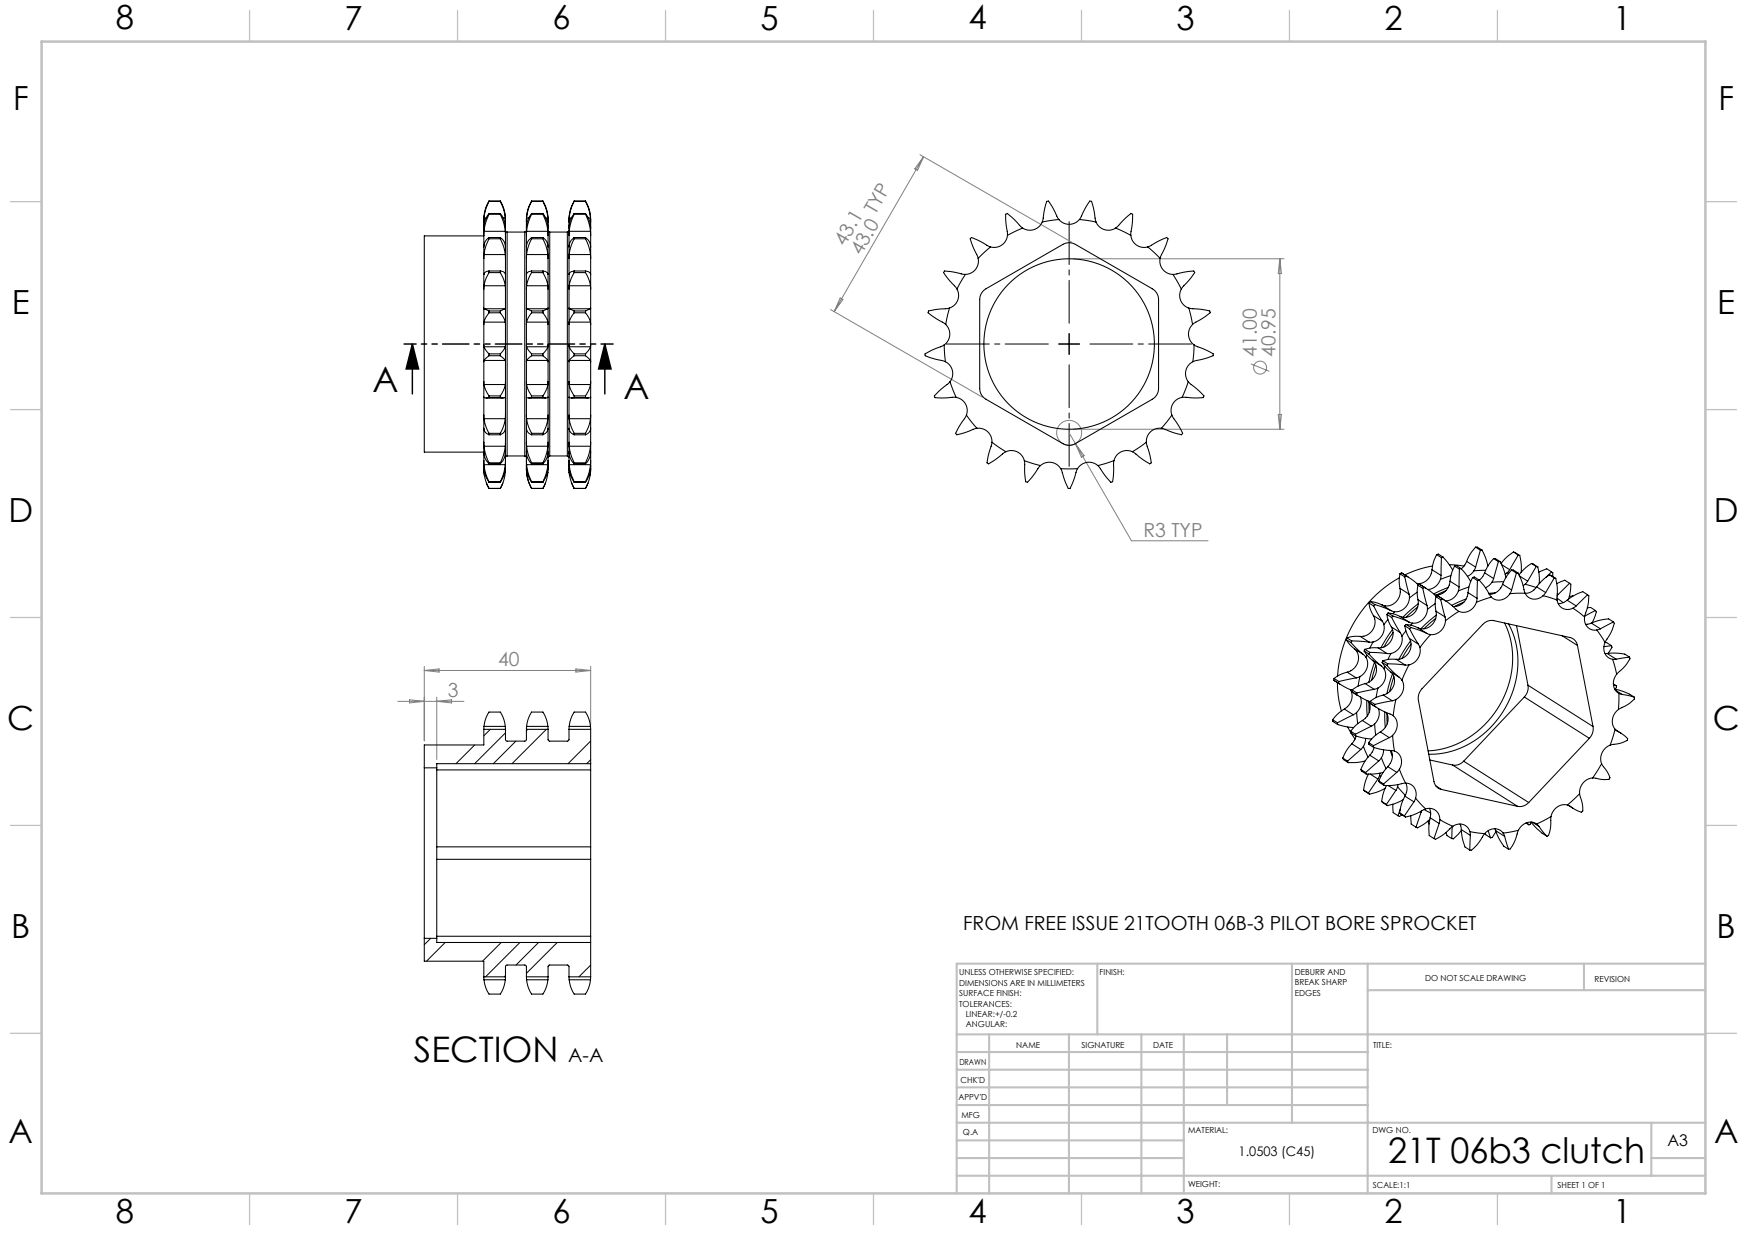
[picture p62: page 1]
SECTION A-A; 43.0 TYP; R3 TYP; FINISH:; DEBURR AND; BREAK SHARP; DO NOT SCALE DRAWING; REVISION; SCALE:1:1; SHEET 1 OF 1

FROM FREE ISSUE 21TOOTH 06B-3 PILOT BORE SPROCKET

UNLESS OTHERWISE SPECIFIED:
DIMENSIONS ARE IN MILLIMETERS
SURFACE FINISH:
TOLERANCES:
LINEAR:+/-0.2
ANGULAR:

NAME | SIGNATURE | DATE | | | | TITLE:

DRAWN
CHK'D
APPV'D
MFG
Q.A | | | | MATERIAL: | DWG NO. 21T 06b3 clutch | A3 1.0503 (C45)
