TeamCyberwar/Deadlock/drawings and step files/machining/23T 06b1.PDF

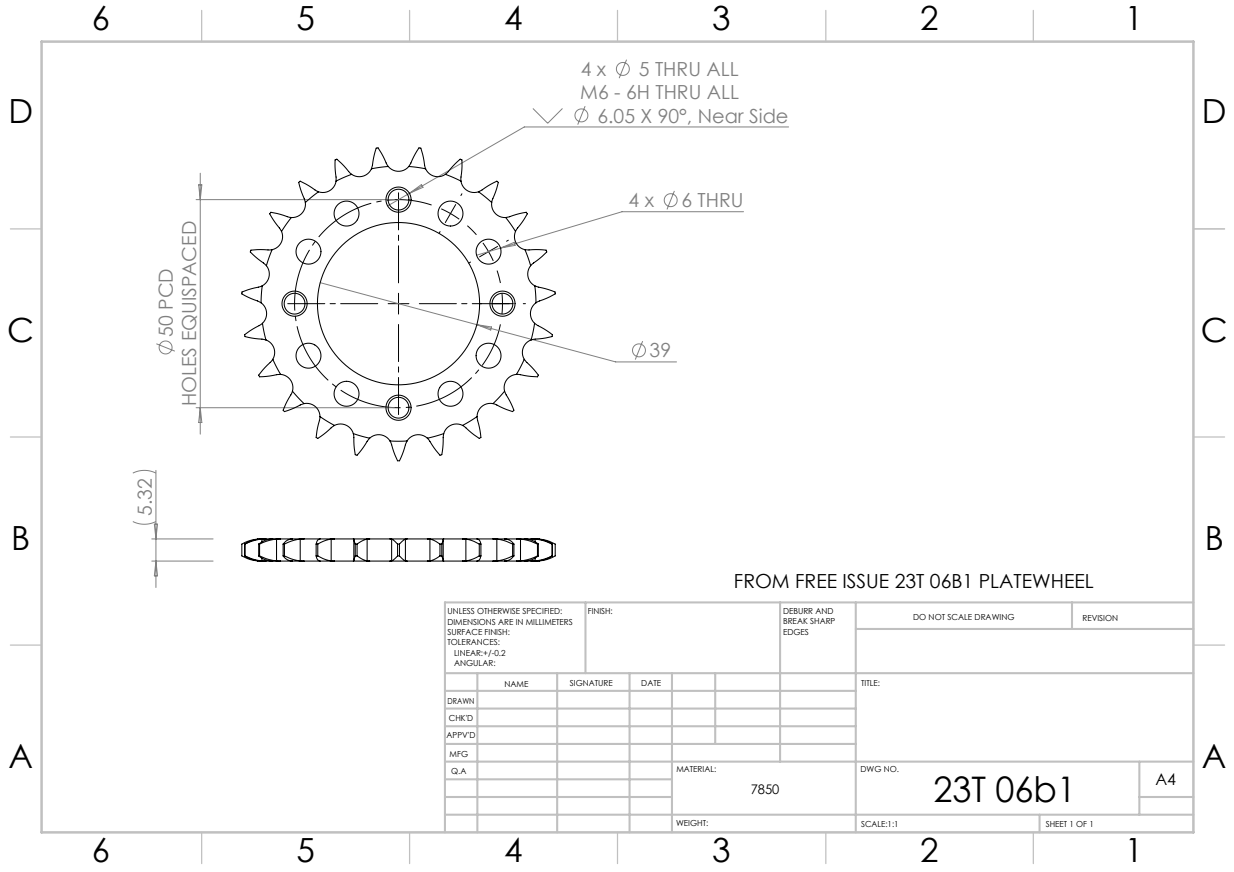
[picture p63: page 1]
5 THRU ALL; M6 - 6H THRU ALL 6.05 X 90°, Near Side; 4 x 6 THRU; 50 PCD; HOLES EQUISPACED; FINISH:; DEBURR AND; BREAK SHARP; DO NOT SCALE DRAWING; REVISION; SCALE:1:1; SHEET 1 OF 1

FROM FREE ISSUE 23T 06B1 PLATEWHEEL

UNLESS OTHERWISE SPECIFIED:
DIMENSIONS ARE IN MILLIMETERS
SURFACE FINISH:
TOLERANCES:
LINEAR:+/-0.2
ANGULAR:

NAME | SIGNATURE | DATE | | | | TITLE:

DRAWN
CHK'D
APPV'D
MFG
Q.A | | | | MATERIAL: 7850 | DWG NO. 23T 06b1 | A4
