TeamCyberwar/Deadlock/drawings and step files/machining/30T 06b1.PDF

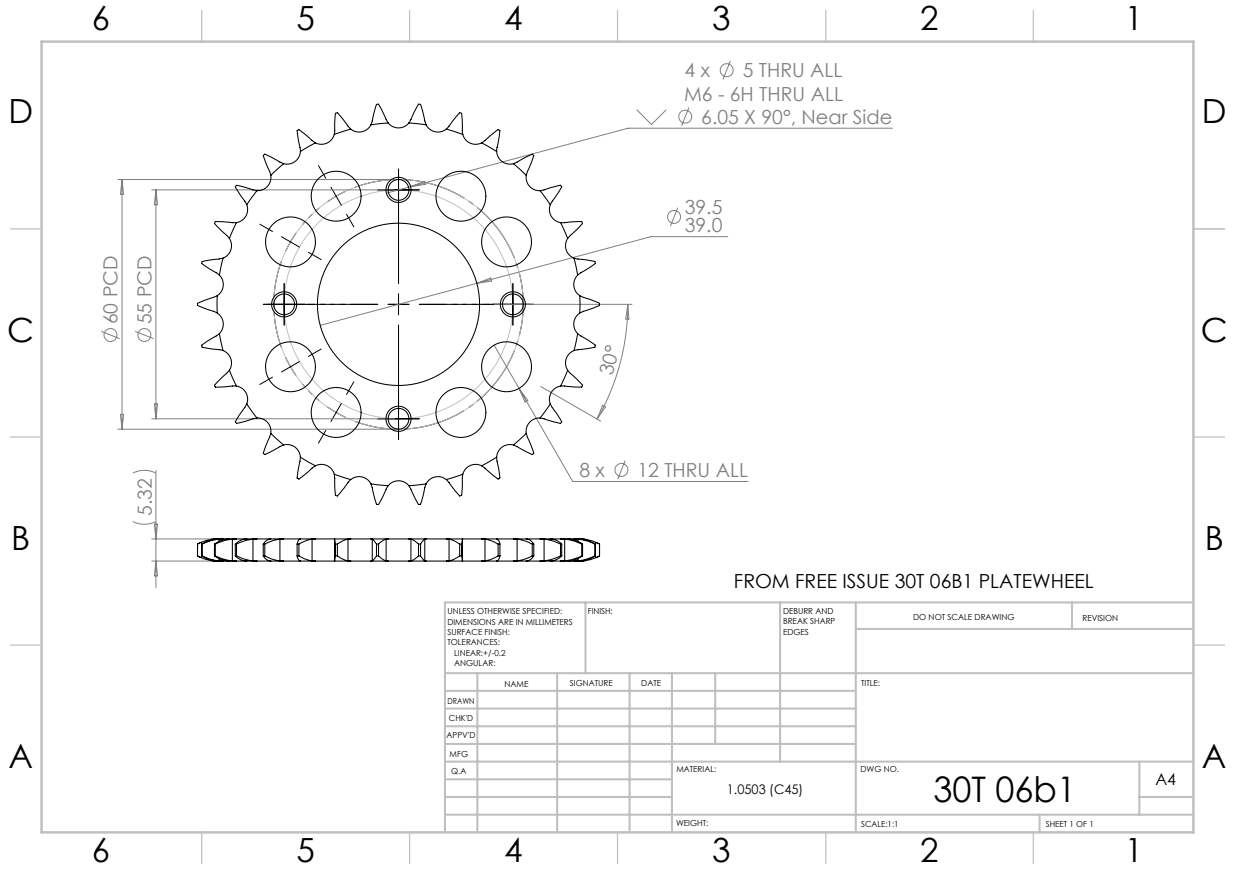
[picture p64: page 1]
5 THRU ALL; M6 - 6H THRU ALL 6.05 X 90°, Near Side; 12 THRU ALL; 60 PCD; 55 PCD 5.32; FINISH:; DEBURR AND; BREAK SHARP; DO NOT SCALE DRAWING; REVISION; SCALE:1:1; SHEET 1 OF 1

FROM FREE ISSUE 30T 06B1 PLATEWHEEL

UNLESS OTHERWISE SPECIFIED:
DIMENSIONS ARE IN MILLIMETERS
SURFACE FINISH:
TOLERANCES:
LINEAR:+/-0.2
ANGULAR:

NAME | SIGNATURE | DATE | | | | TITLE:

DRAWN
CHK'D
APPV'D
MFG
Q.A | | | | MATERIAL: | DWG NO. 30T 06b1 | A4 1.0503 (C45)
