TeamCyberwar/Deadlock/drawings and step files/machining/57T 06b3 v0.2.PDF

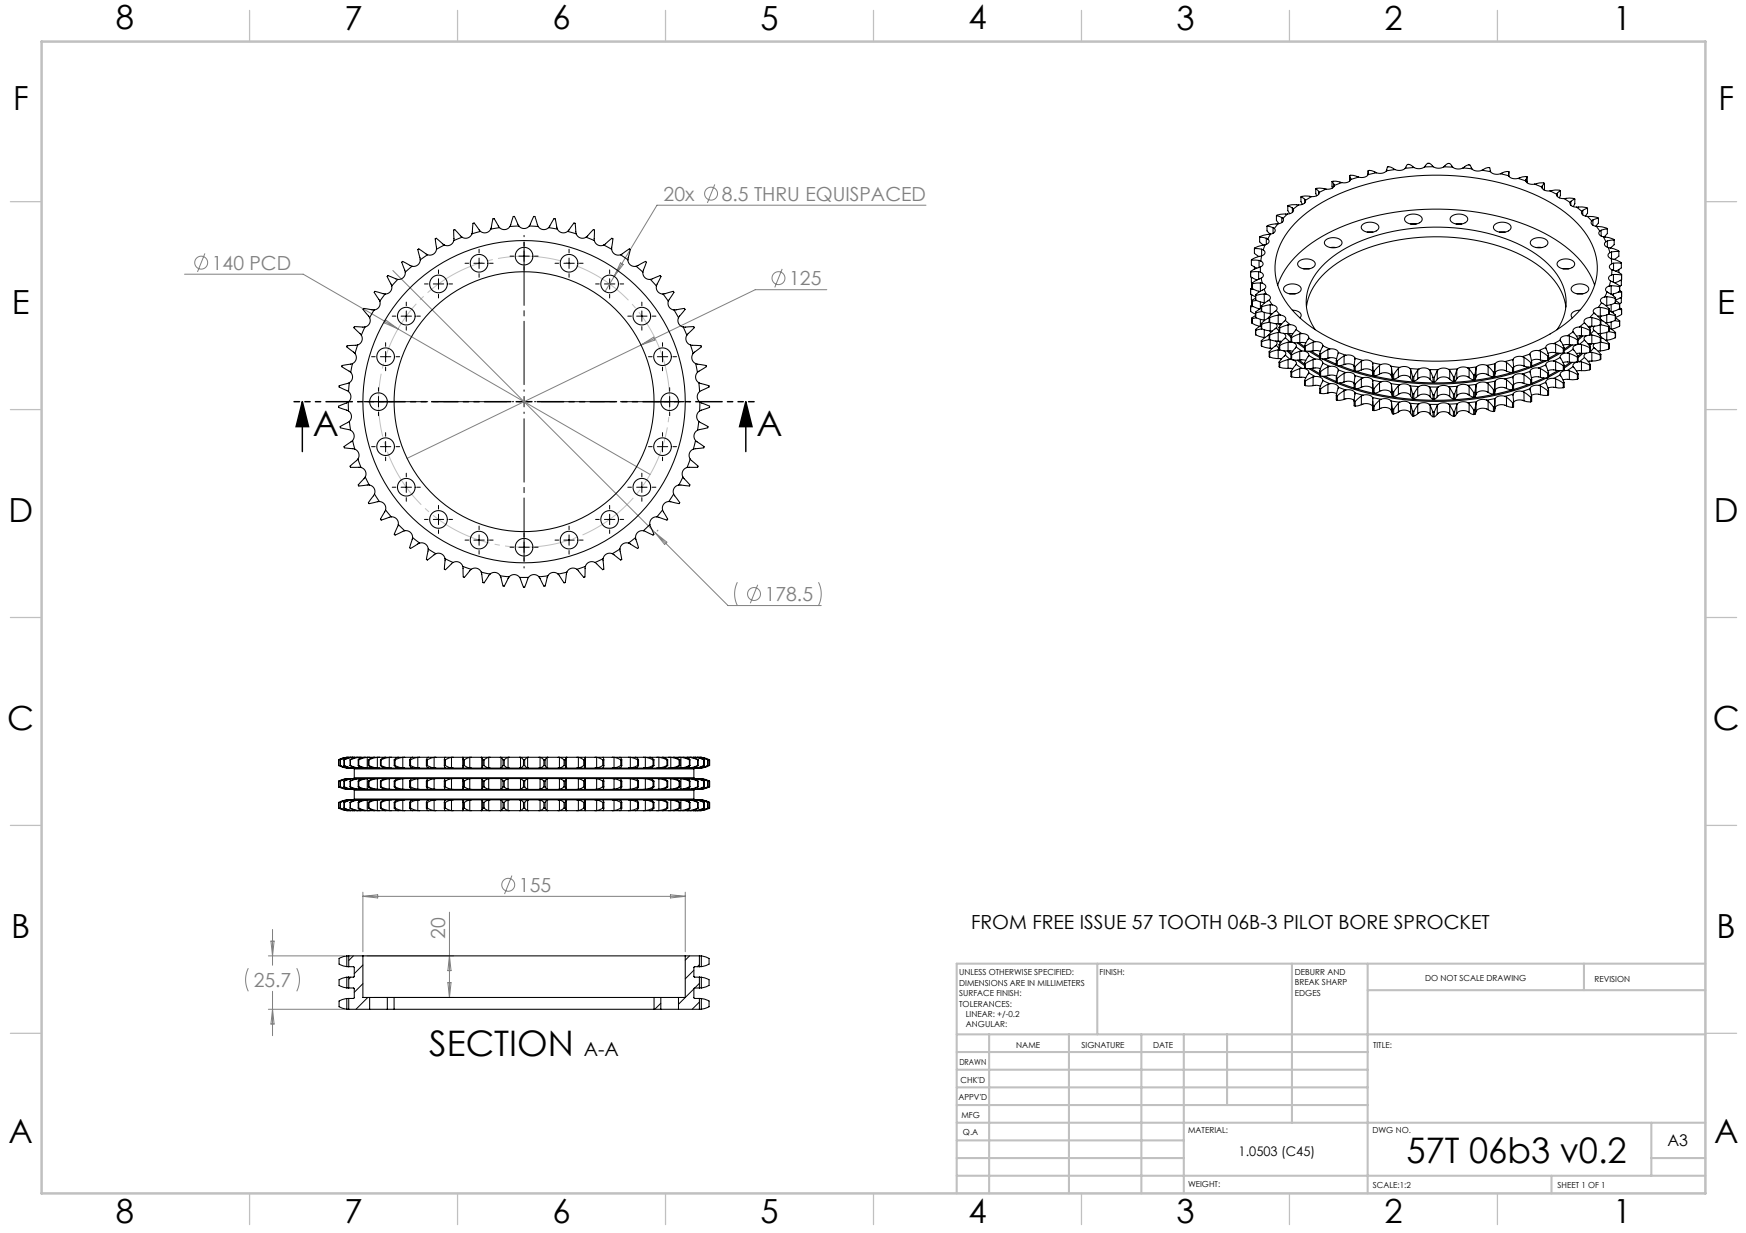
[picture p65: page 1]
20x 8.5 THRU EQUISPACED; 140 PCD; SECTION A-A; FINISH:; DEBURR AND; BREAK SHARP; DO NOT SCALE DRAWING; REVISION; SCALE:1:2; SHEET 1 OF 1

FROM FREE ISSUE 57 TOOTH 06B-3 PILOT BORE SPROCKET

UNLESS OTHERWISE SPECIFIED:
DIMENSIONS ARE IN MILLIMETERS
SURFACE FINISH:
TOLERANCES:
LINEAR: +/-0.2
ANGULAR:

NAME | SIGNATURE | DATE | | | | TITLE:

DRAWN
CHK'D
APPV'D
MFG
Q.A | | | | MATERIAL: | DWG NO. 57T 06b3 v0.2 | A3 1.0503 (C45)
