TeamCyberwar/Deadlock/drawings and step files/machining/9T 06b1.PDF

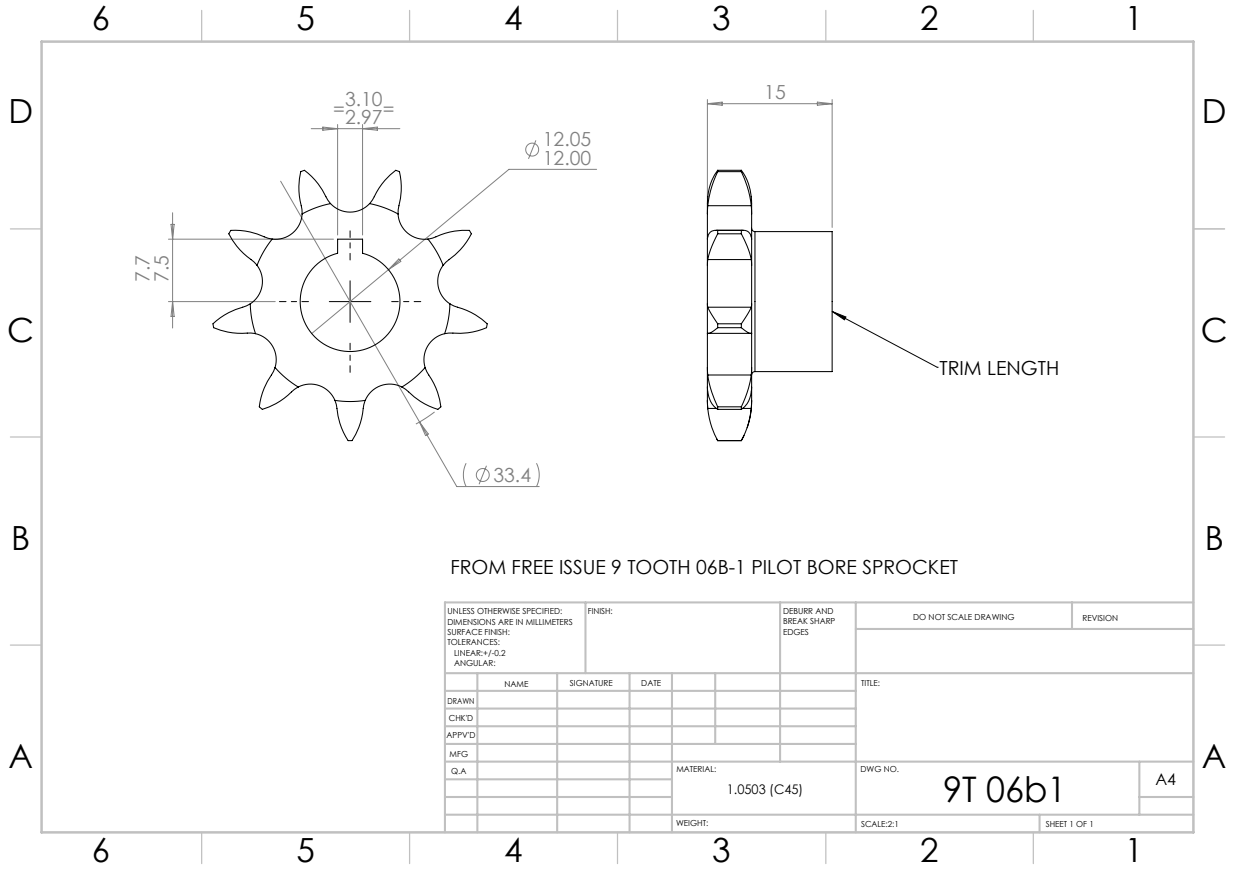
[picture p66: page 1]
TRIM LENGTH; FINISH:; DEBURR AND; BREAK SHARP; DO NOT SCALE DRAWING; REVISION; SCALE:2:1; SHEET 1 OF 1

FROM FREE ISSUE 9 TOOTH 06B-1 PILOT BORE SPROCKET

UNLESS OTHERWISE SPECIFIED:
DIMENSIONS ARE IN MILLIMETERS
SURFACE FINISH:
TOLERANCES:
LINEAR:+/-0.2
ANGULAR:

NAME | SIGNATURE | DATE | | | | TITLE:

DRAWN
CHK'D
APPV'D
MFG
Q.A | | | | MATERIAL: | DWG NO. 9T 06b1 | A4 1.0503 (C45)
