TeamCyberwar/Deadlock/drawings and step files/machining/9T 06b3.PDF

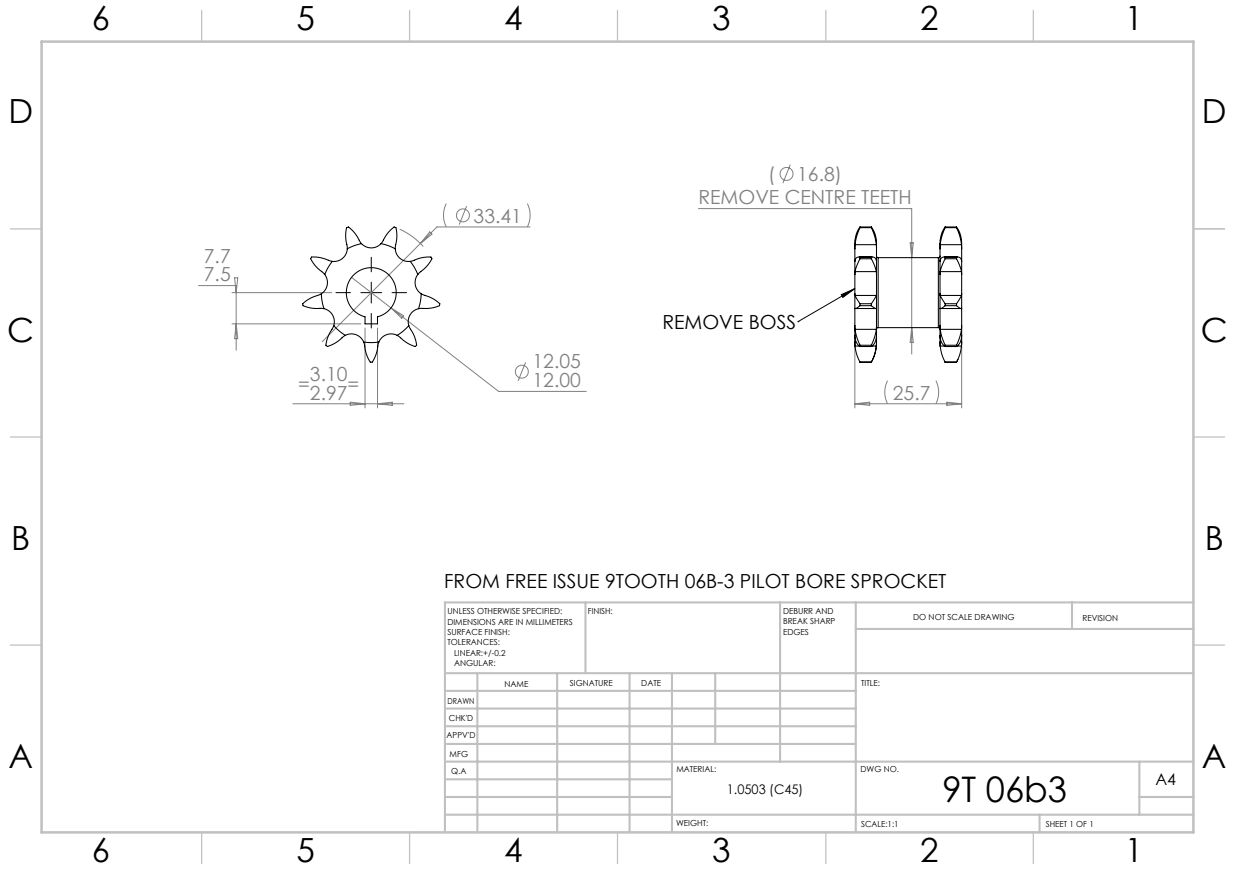
[picture p67: page 1]
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

REMOVE CENTRE TEETH

FROM FREE ISSUE 9TOOTH 06B-3 PILOT BORE SPROCKET

UNLESS OTHERWISE SPECIFIED:
DIMENSIONS ARE IN MILLIMETERS
SURFACE FINISH:
TOLERANCES:
LINEAR:+/-0.2
ANGULAR:

NAME | SIGNATURE | DATE | | | | TITLE:

DRAWN
CHK'D
APPV'D
MFG
Q.A | | | | MATERIAL: | DWG NO. 9T 06b3 | A4 1.0503 (C45)
