TeamCyberwar/Deadlock/drawings and step files/machining/baseplate v0.3.PDF

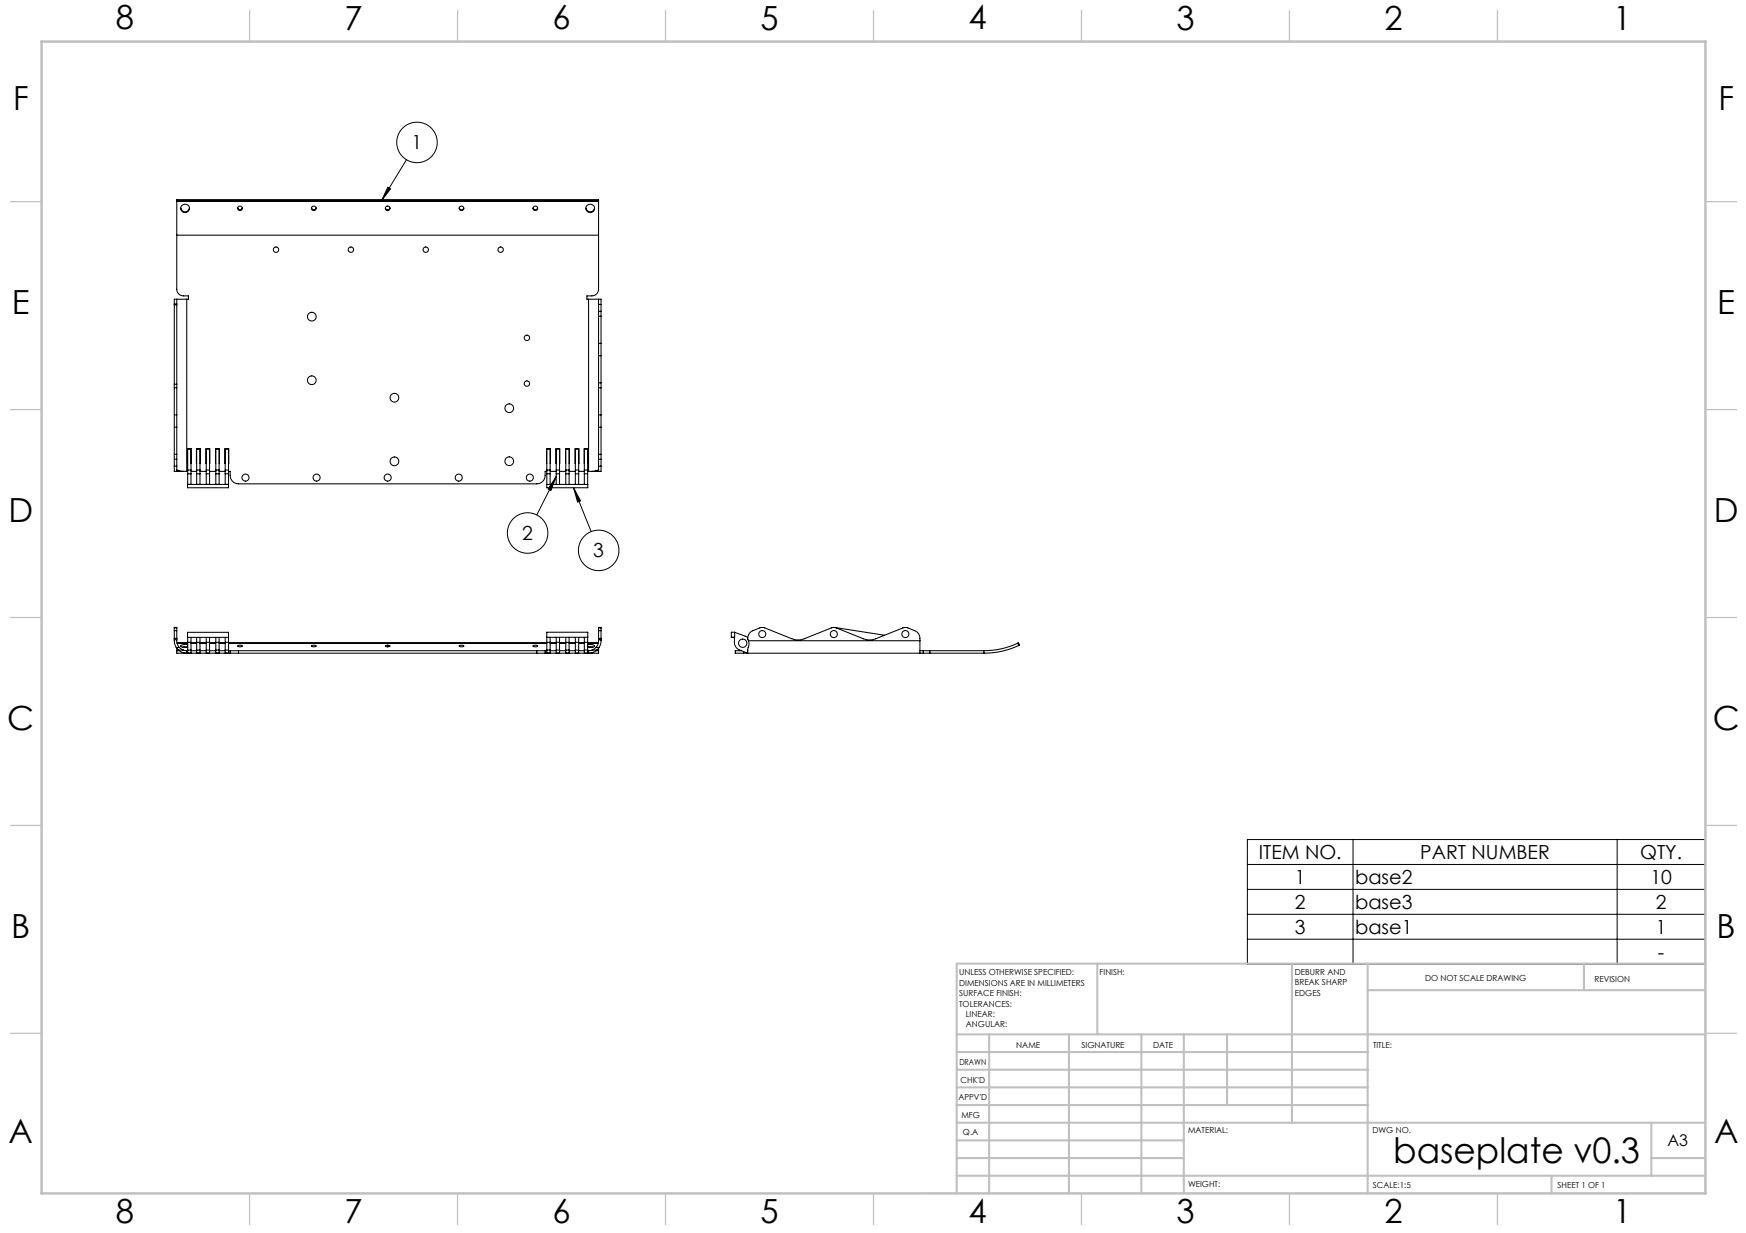
[picture p68: page 1]
SCALE:1:5; SHEET 1 OF 1

ITEM NO. | PART NUMBER | QTY.
1 | base2 | 10
2 | base3 | 2
3 | base1 | 1

UNLESS OTHERWISE SPECIFIED: DIMENSIONS ARE IN MILLIMETERS SURFACE FINISH: TOLERANCES: LINEAR: ANGULAR: | FINISH: | DEBURR AND BREAK SHARP EDGES | DO NOT SCALE DRAWING | REVISION

NAME | SIGNATURE | DATE | | | | TITLE:

DRAWN
CHK'D
APPV'D
MFG
Q.A | | | | MATERIAL: | DWG NO. baseplate v0.3 | A3
