TeamCyberwar/Deadlock/drawings and step files/machining/clamp arm pins.PDF

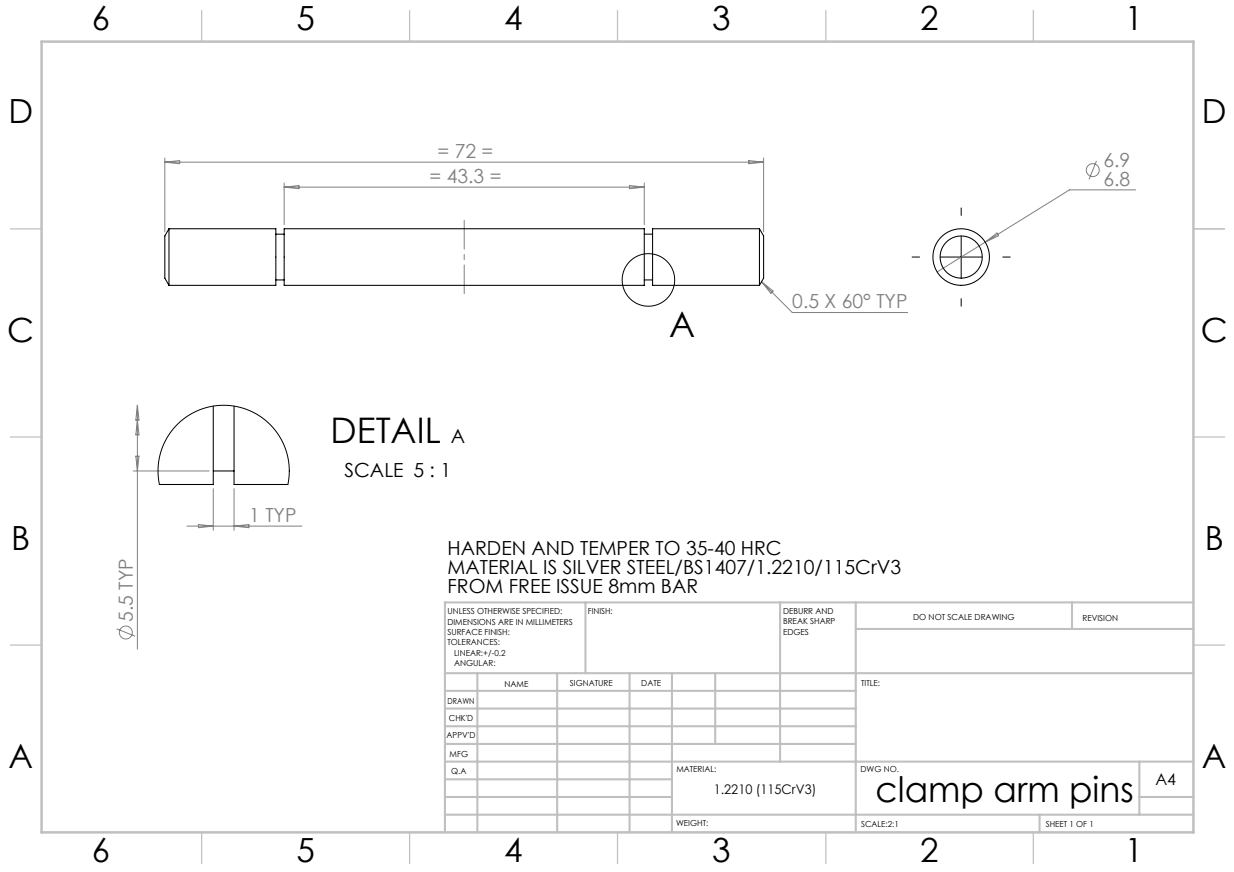
[picture p69: page 1]
0.5 X 60° TYP; 1 TYP; 5.5 TYP; DETAIL A; SCALE 5 : 1; FINISH:; DEBURR AND; BREAK SHARP; DO NOT SCALE DRAWING; REVISION; SCALE:2:1; SHEET 1 OF 1

HARDEN AND TEMPER TO 35-40 HRC
MATERIAL IS SILVER STEEL/BS1407/1.2210/115CrV3
FROM FREE ISSUE 8mm BAR

UNLESS OTHERWISE SPECIFIED:
DIMENSIONS ARE IN MILLIMETERS
SURFACE FINISH:
TOLERANCES:
LINEAR:+/-0.2
ANGULAR:

NAME | SIGNATURE | DATE | | | | TITLE:

DRAWN
CHK'D
APPV'D
MFG
Q.A | | | | MATERIAL: | DWG NO. clamp arm pins | A4 1.2210 (115CrV3)
