TeamCyberwar/Deadlock/drawings and step files/machining/clamp fork v1.PDF

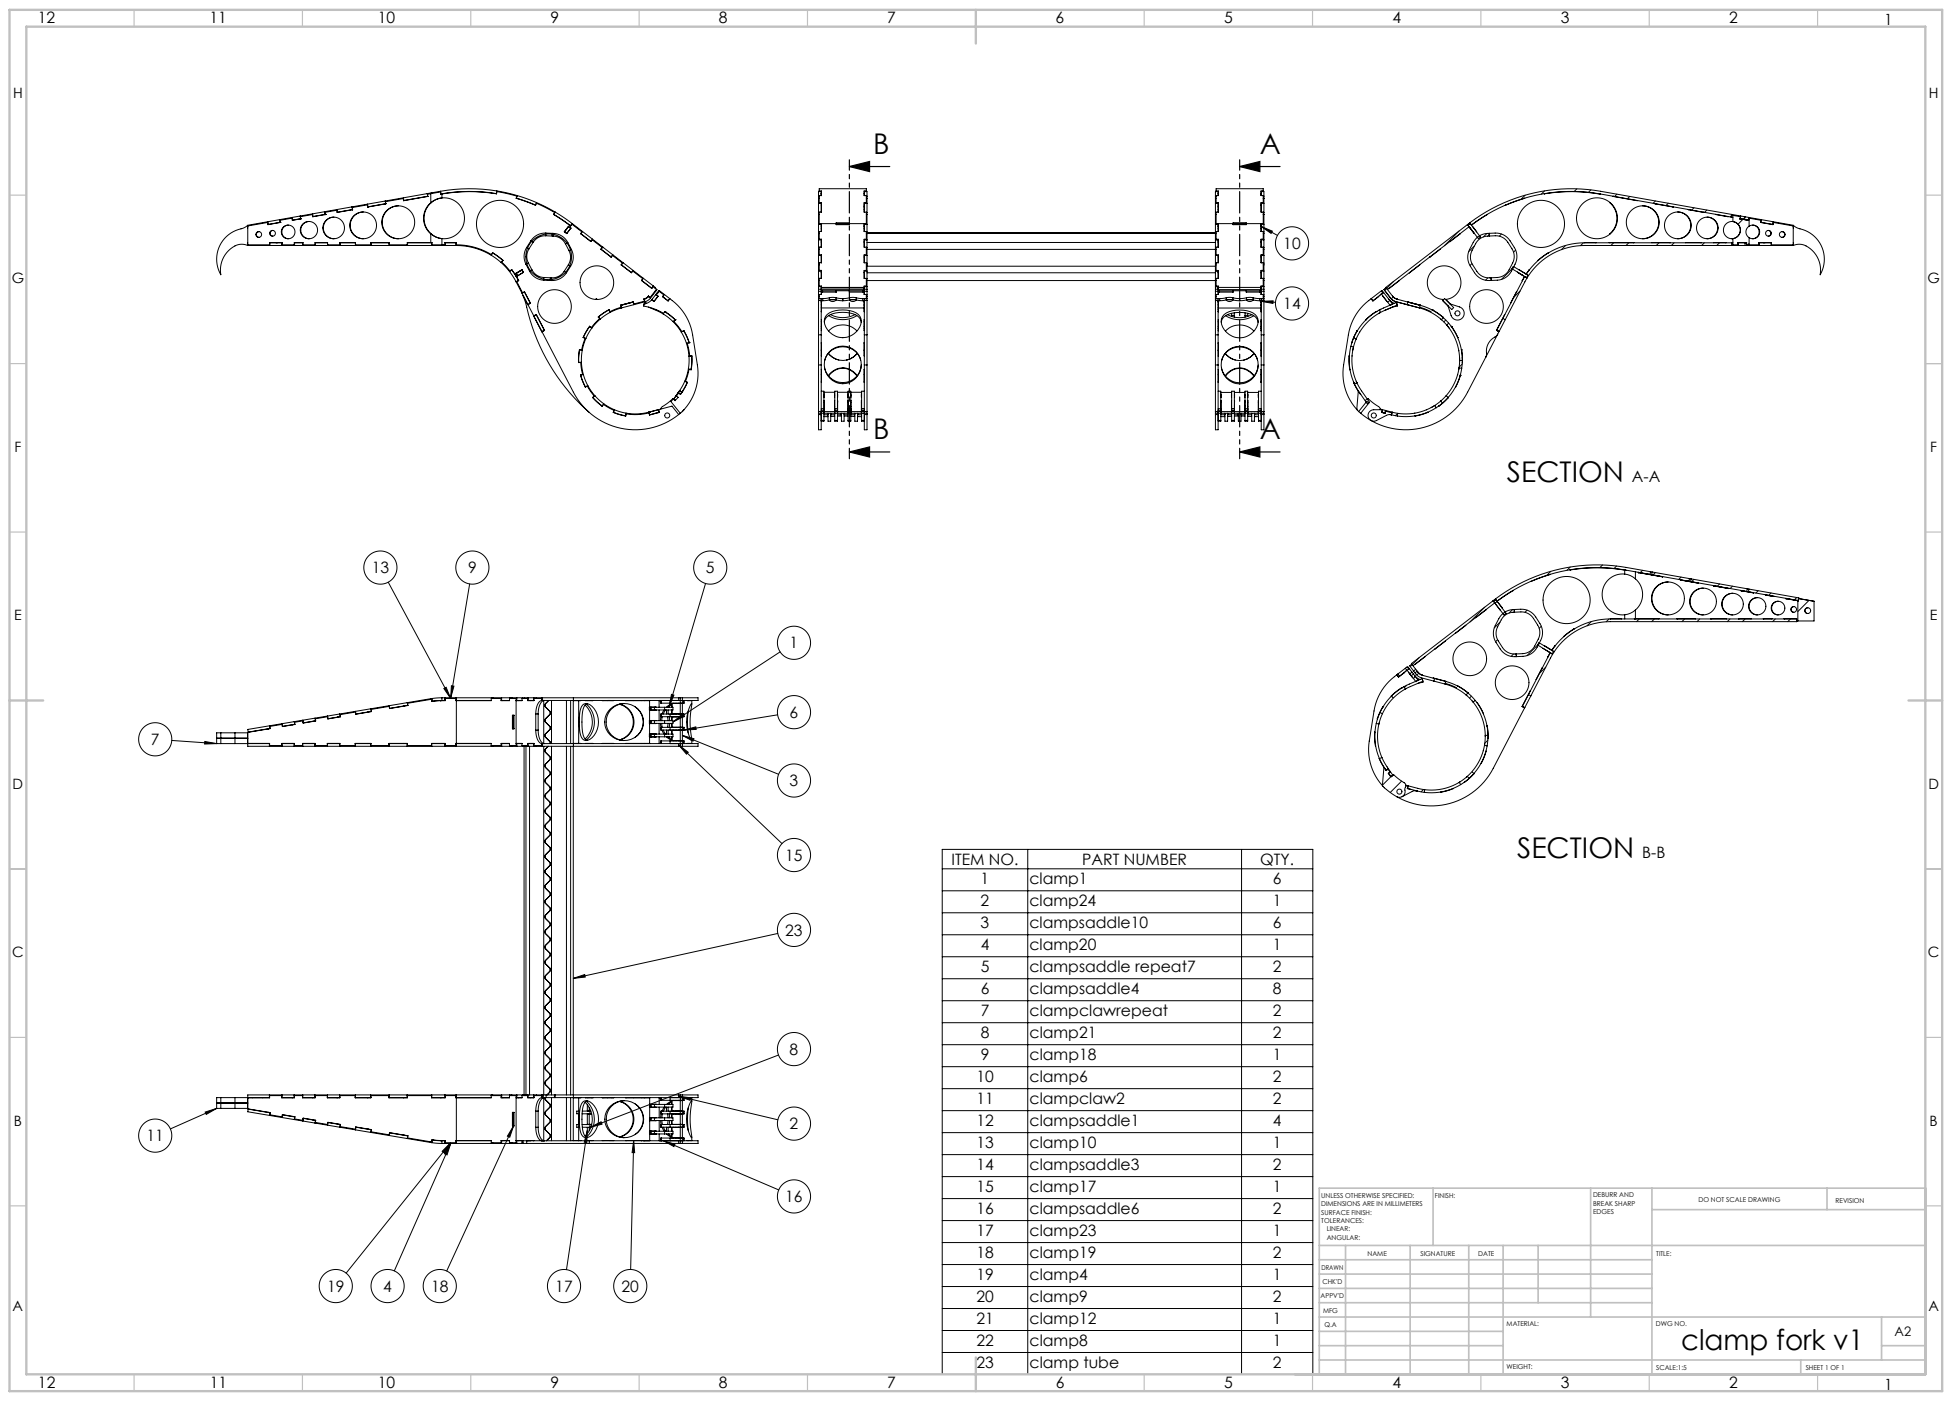
[picture p70: page 1]
SECTION A-A; SECTION B-B ITEM NO.; PART NUMBER; QTY.; clamp tube; FINISH:; DEBURR AND; BREAK SHARP; DO NOT SCALE DRAWING; REVISION; SCALE:1:5; SHEET 1 OF 1

2 | clamp24 | 1
3 | clampsaddle10 | 6
4 | clamp20 | 1
5 | clampsaddle repeat7 | 2
6 | clampsaddle4 | 8
7 | clampclawrepeat | 2
8 | clamp21 | 2
9 | clamp18 | 1
10 | clamp6 | 2
11 | clampclaw2 | 2
12 | clampsaddle1 | 4
13 | clamp10 | 1
14 | clampsaddle3 | 2
15 | clamp17 | 1
16 | clampsaddle6 | 2
17 | clamp23 | 1
18 | clamp19 | 2
19 | clamp4 | 1

UNLESS OTHERWISE SPECIFIED:
DIMENSIONS ARE IN MILLIMETERS
SURFACE FINISH:
TOLERANCES:
LINEAR:
ANGULAR:

NAME | SIGNATURE | DATE | TITLE:

DRAWN
CHK'D

21 | clamp12 | 1
22 | clamp8 | 1

MFG
Q.A | MATERIAL: | DWG NO. clamp fork v1 | A2
