TeamCyberwar/Deadlock/drawings and step files/machining/drive motor shaft.PDF

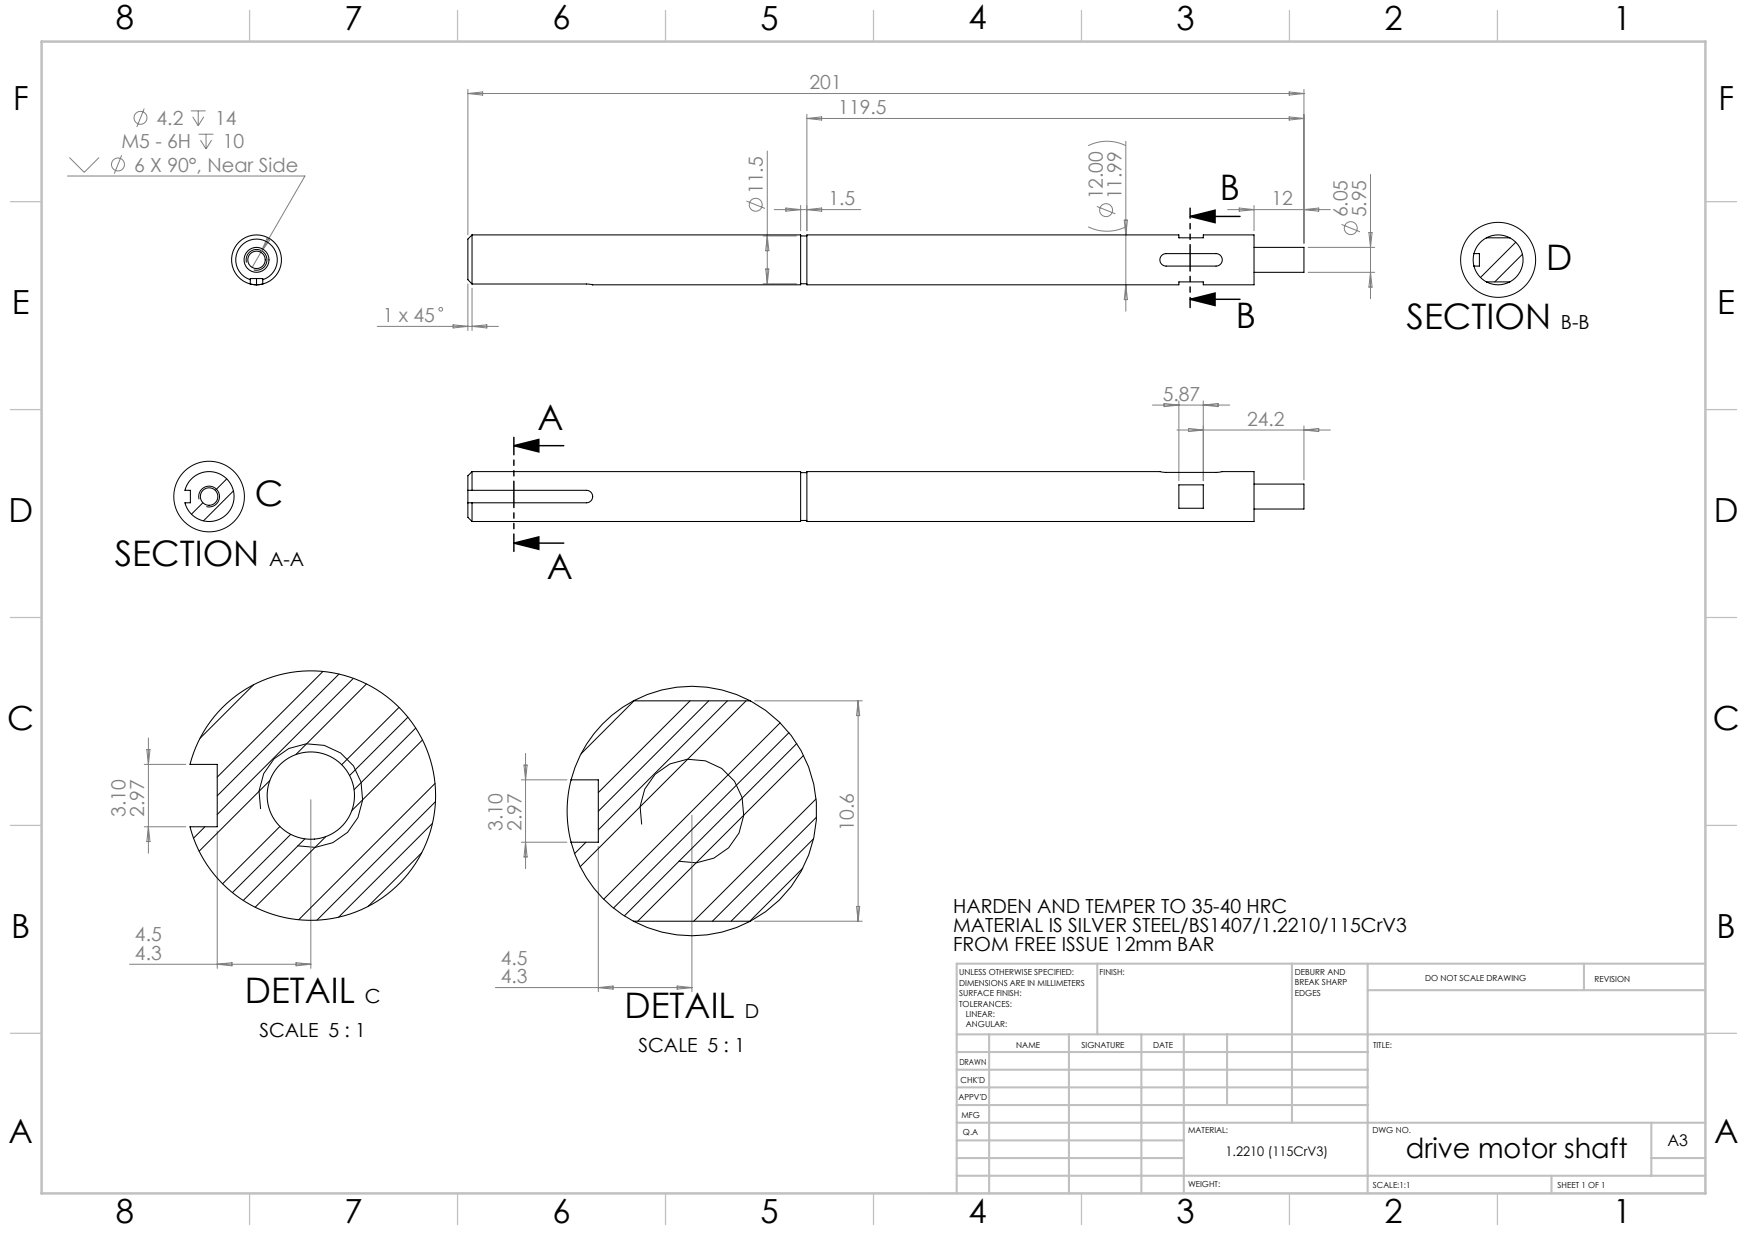
[picture p71: page 1]
4.2 14 M5 - 6H 10 6 X 90°, Near Side; SECTION A-A; SECTION B-B; DETAIL C; SCALE 5 : 1; DETAIL D; FINISH:; DEBURR AND; BREAK SHARP; DO NOT SCALE DRAWING; REVISION; SCALE:1:1; SHEET 1 OF 1

HARDEN AND TEMPER TO 35-40 HRC
MATERIAL IS SILVER STEEL/BS1407/1.2210/115CrV3
FROM FREE ISSUE 12mm BAR

UNLESS OTHERWISE SPECIFIED:
DIMENSIONS ARE IN MILLIMETERS
SURFACE FINISH:
TOLERANCES:
LINEAR:
ANGULAR:

NAME | SIGNATURE | DATE | | | | TITLE:

DRAWN
CHK'D
APPV'D
MFG
Q.A | | | | MATERIAL: | DWG NO. drive motor shaft | A3 1.2210 (115CrV3)
