TeamCyberwar/Deadlock/drawings and step files/machining/front forks v2.7 from sheet.PDF

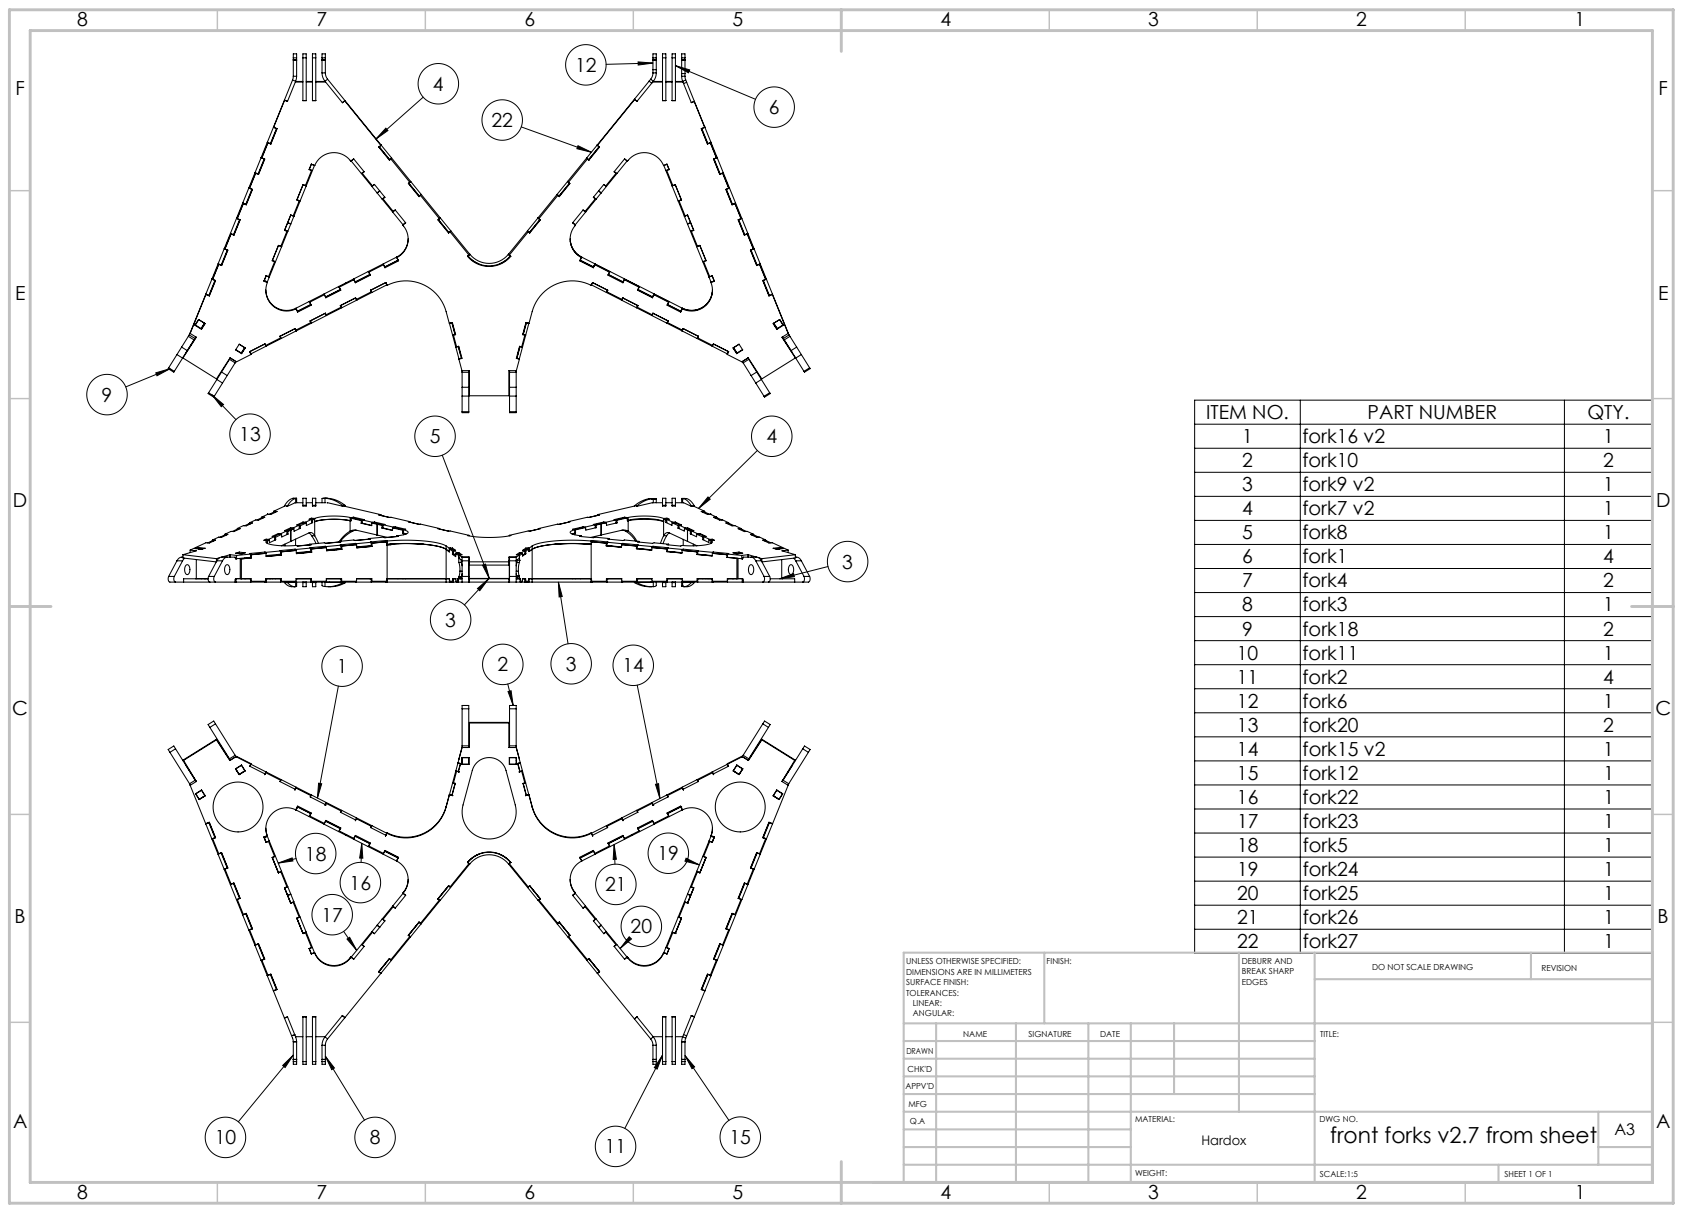
[picture p72: page 1]
SCALE:1:5; SHEET 1 OF 1

ITEM NO. | PART NUMBER | QTY.
1 | fork16 v2 | 1
2 | fork10 | 2
3 | fork9 v2 | 1
4 | fork7 v2 | 1
5 | fork8 | 1
6 | fork1 | 4
7 | fork4 | 2
8 | fork3 | 1
9 | fork18 | 2
10 | fork11 | 1
11 | fork2 | 4
12 | fork6 | 1
13 | fork20 | 2
14 | fork15 v2 | 1
15 | fork12 | 1
16 | fork22 | 1
17 | fork23 | 1
18 | fork5 | 1
19 | fork24 | 1
20 | fork25 | 1
21 | fork26 | 1
22 | fork27 | 1

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

NAME | SIGNATURE | DATE | | | | TITLE:

DRAWN
CHK'D
APPV'D
MFG
Q.A | | | | MATERIAL: | DWG NO. front forks v2.7 from sheet | A3 Hardox
