TeamCyberwar/Deadlock/drawings and step files/machining/front wheel axle2.PDF

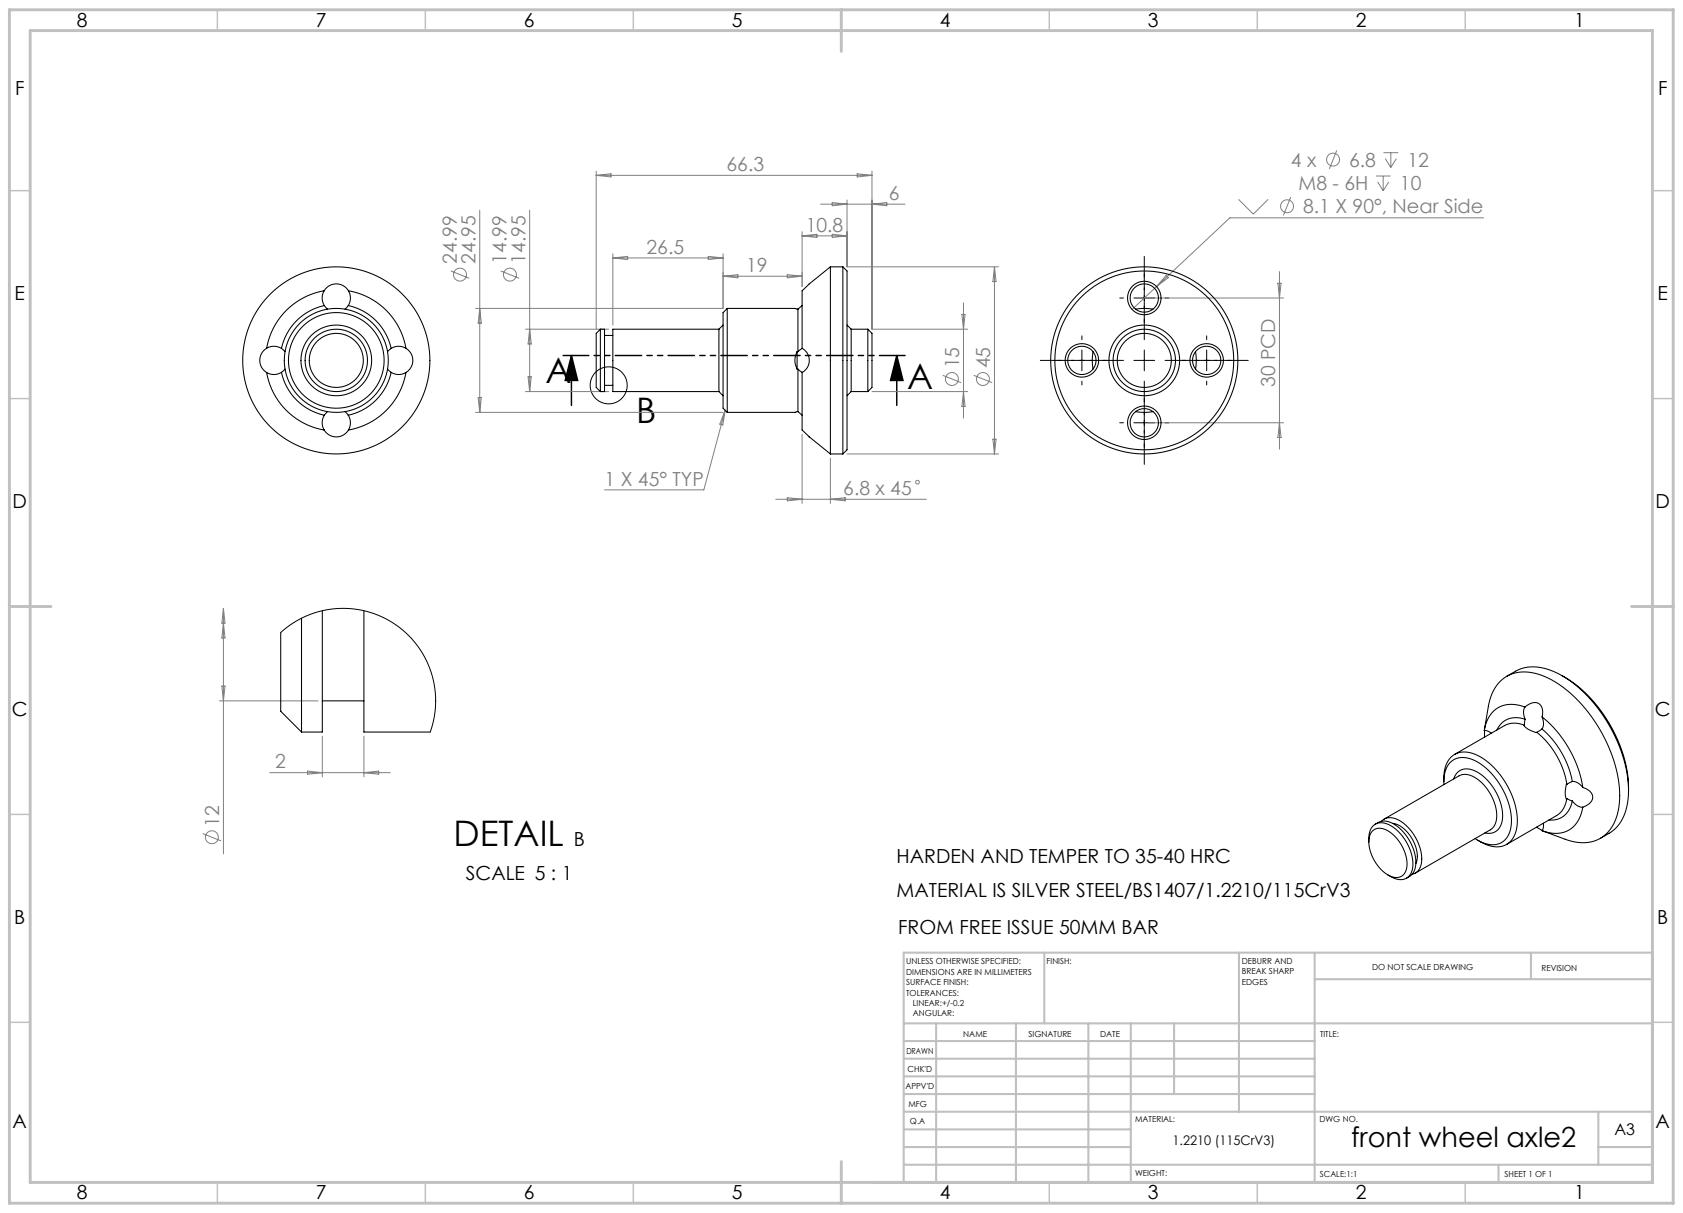
[picture p73: page 1]
6.8 x 45 1 X 45° TYP; M8 - 6H 10 8.1 X 90°, Near Side; 30 PCD; DETAIL B; SCALE 5 : 1; FINISH:; DEBURR AND; BREAK SHARP; DO NOT SCALE DRAWING; REVISION; SCALE:1:1; SHEET 1 OF 1

HARDEN AND TEMPER TO 35-40 HRC
MATERIAL IS SILVER STEEL/BS1407/1.2210/115CrV3
FROM FREE ISSUE 50MM BAR

UNLESS OTHERWISE SPECIFIED:
DIMENSIONS ARE IN MILLIMETERS
SURFACE FINISH:
TOLERANCES:
LINEAR:+/-0.2
ANGULAR:

NAME | SIGNATURE | DATE | | | | TITLE:

DRAWN
CHK'D
APPV'D
MFG
Q.A | | | | MATERIAL: | DWG NO. front wheel axle2 | A3 1.2210 (115CrV3)
