TeamCyberwar/Deadlock/drawings and step files/machining/front wheel hub.PDF

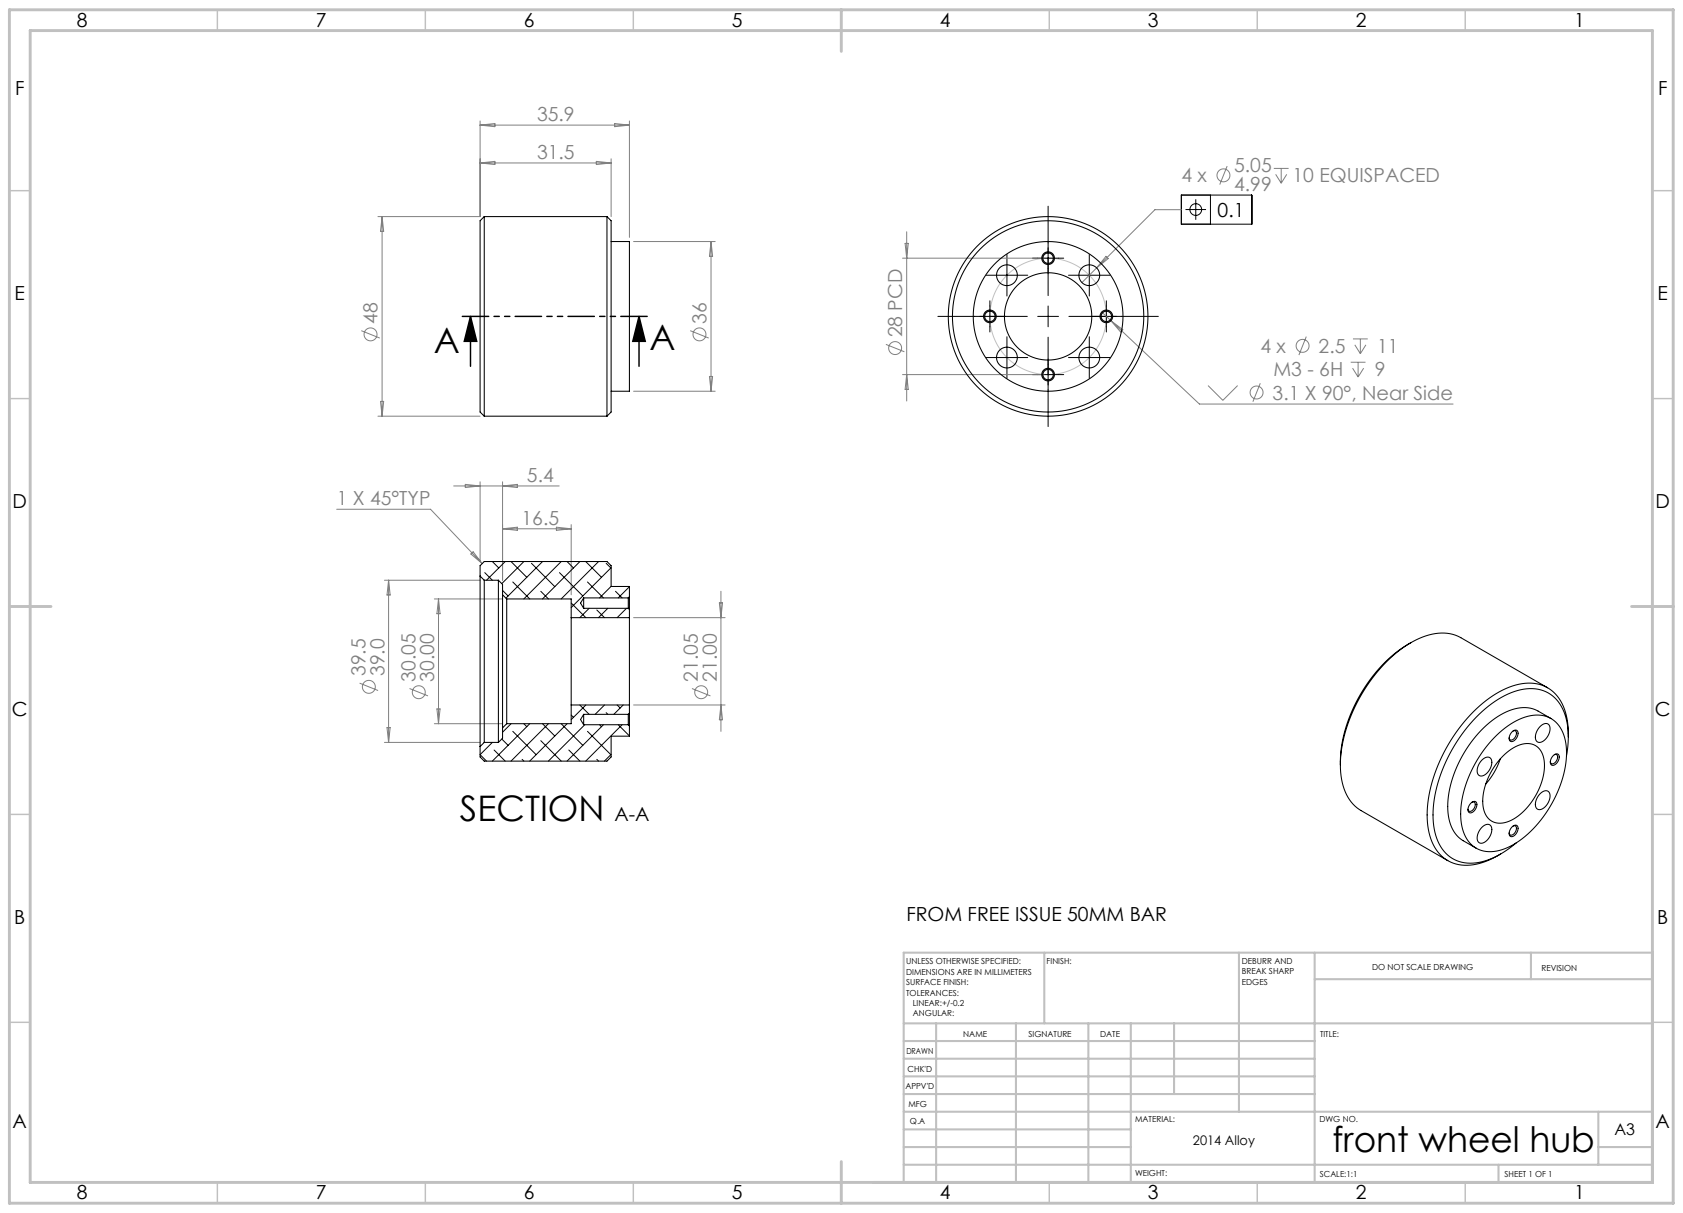
[picture p74: page 1]
4 x 5.05 4.99 10 EQUISPACED; M3 - 6H 9 3.1 X 90°, Near Side; 28 PCD; 1 X 45°TYP30.05 30.00; SECTION A-A; FINISH:; DEBURR AND; BREAK SHARP; DO NOT SCALE DRAWING; REVISION; SCALE:1:1; SHEET 1 OF 1

FROM FREE ISSUE 50MM BAR

UNLESS OTHERWISE SPECIFIED:
DIMENSIONS ARE IN MILLIMETERS
SURFACE FINISH:
TOLERANCES:
LINEAR:+/-0.2
ANGULAR:

NAME | SIGNATURE | DATE | | | | TITLE:

DRAWN
CHK'D
APPV'D
MFG
Q.A | | | | MATERIAL: | DWG NO. front wheel hub | A3 2014 Alloy
