TeamCyberwar/Deadlock/drawings and step files/machining/gearbox saddle clamp v2.PDF

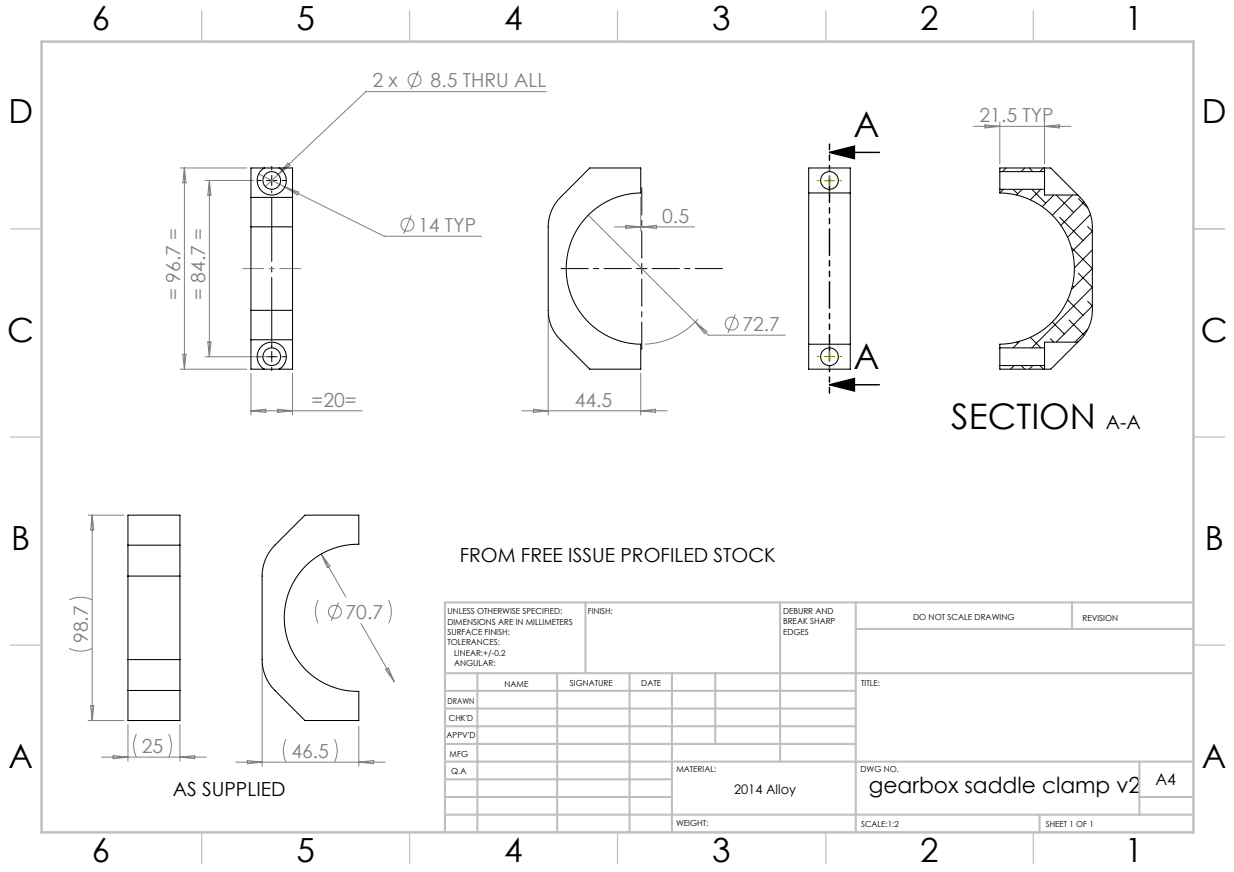
[picture p75: page 1]
8.5 THRU ALL; 14 TYP; 21.5 TYP; SECTION A-A; AS SUPPLIED; FINISH:; DEBURR AND; BREAK SHARP; DO NOT SCALE DRAWING; REVISION; SCALE:1:2; SHEET 1 OF 1

FROM FREE ISSUE PROFILED STOCK

UNLESS OTHERWISE SPECIFIED:
DIMENSIONS ARE IN MILLIMETERS
SURFACE FINISH:
TOLERANCES:
LINEAR:+/-0.2
ANGULAR:

NAME | SIGNATURE | DATE | | | | TITLE:

DRAWN
CHK'D
APPV'D
MFG
Q.A | | | | MATERIAL: 2014 Alloy | DWG NO. gearbox saddle clamp v2 | A4
