TeamCyberwar/Deadlock/drawings and step files/machining/gearbox saddle v2.PDF

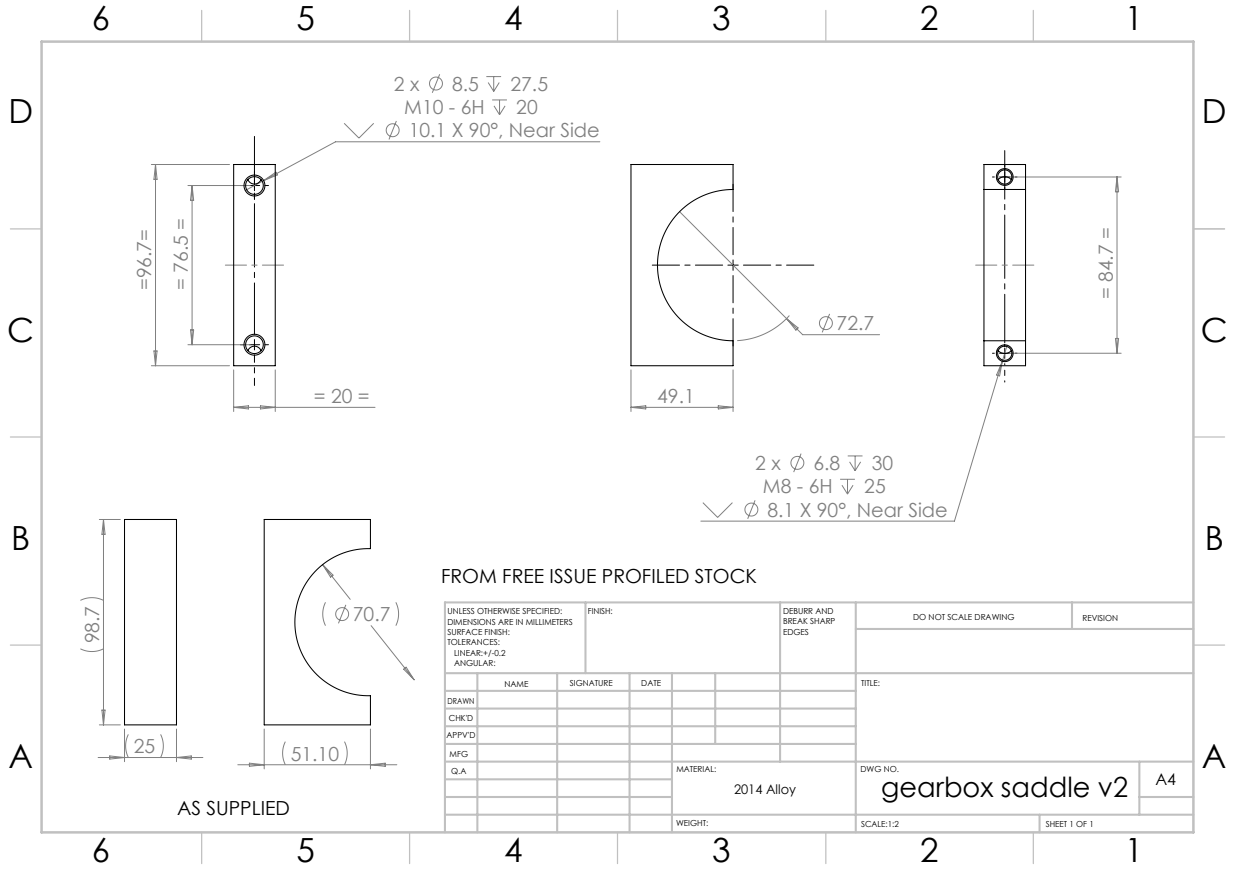
[picture p76: page 1]
M10 - 6H 20 10.1 X 90°, Near Side; M8 - 6H 25 8.1 X 90°, Near Side; AS SUPPLIED; FINISH:; DEBURR AND; BREAK SHARP; DO NOT SCALE DRAWING; REVISION; SCALE:1:2; SHEET 1 OF 1

FROM FREE ISSUE PROFILED STOCK

UNLESS OTHERWISE SPECIFIED:
DIMENSIONS ARE IN MILLIMETERS
SURFACE FINISH:
TOLERANCES:
LINEAR:+/-0.2
ANGULAR:

NAME | SIGNATURE | DATE | TITLE:

DRAWN
CHK'D

MFG
Q.A | MATERIAL: 2014 Alloy | DWG NO. gearbox saddle v2 | A4
