TeamCyberwar/Deadlock/drawings and step files/machining/idler saddle clamp v2.PDF

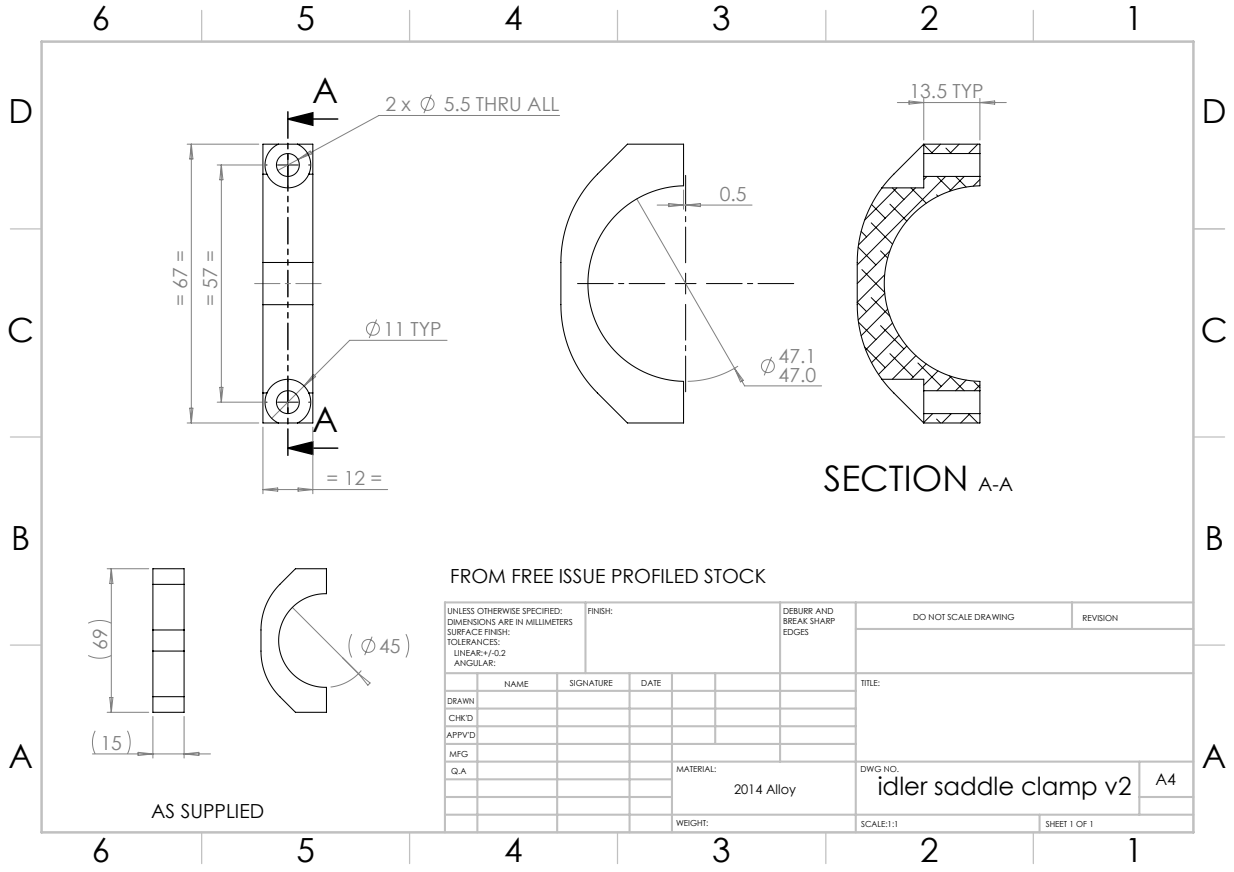
[picture p77: page 1]
5.5 THRU ALL; 11 TYP; 13.5 TYP; SECTION A-A; AS SUPPLIED; FINISH:; DEBURR AND; BREAK SHARP; DO NOT SCALE DRAWING; REVISION; SCALE:1:1; SHEET 1 OF 1

FROM FREE ISSUE PROFILED STOCK

UNLESS OTHERWISE SPECIFIED:
DIMENSIONS ARE IN MILLIMETERS
SURFACE FINISH:

NAME | SIGNATURE | DATE | | | | TITLE:

DRAWN
CHK'D
APPV'D
MFG
Q.A | | | | MATERIAL: 2014 Alloy | DWG NO. idler saddle clamp v2 | A4
