TeamCyberwar/Deadlock/drawings and step files/machining/left lifter rail v3.PDF

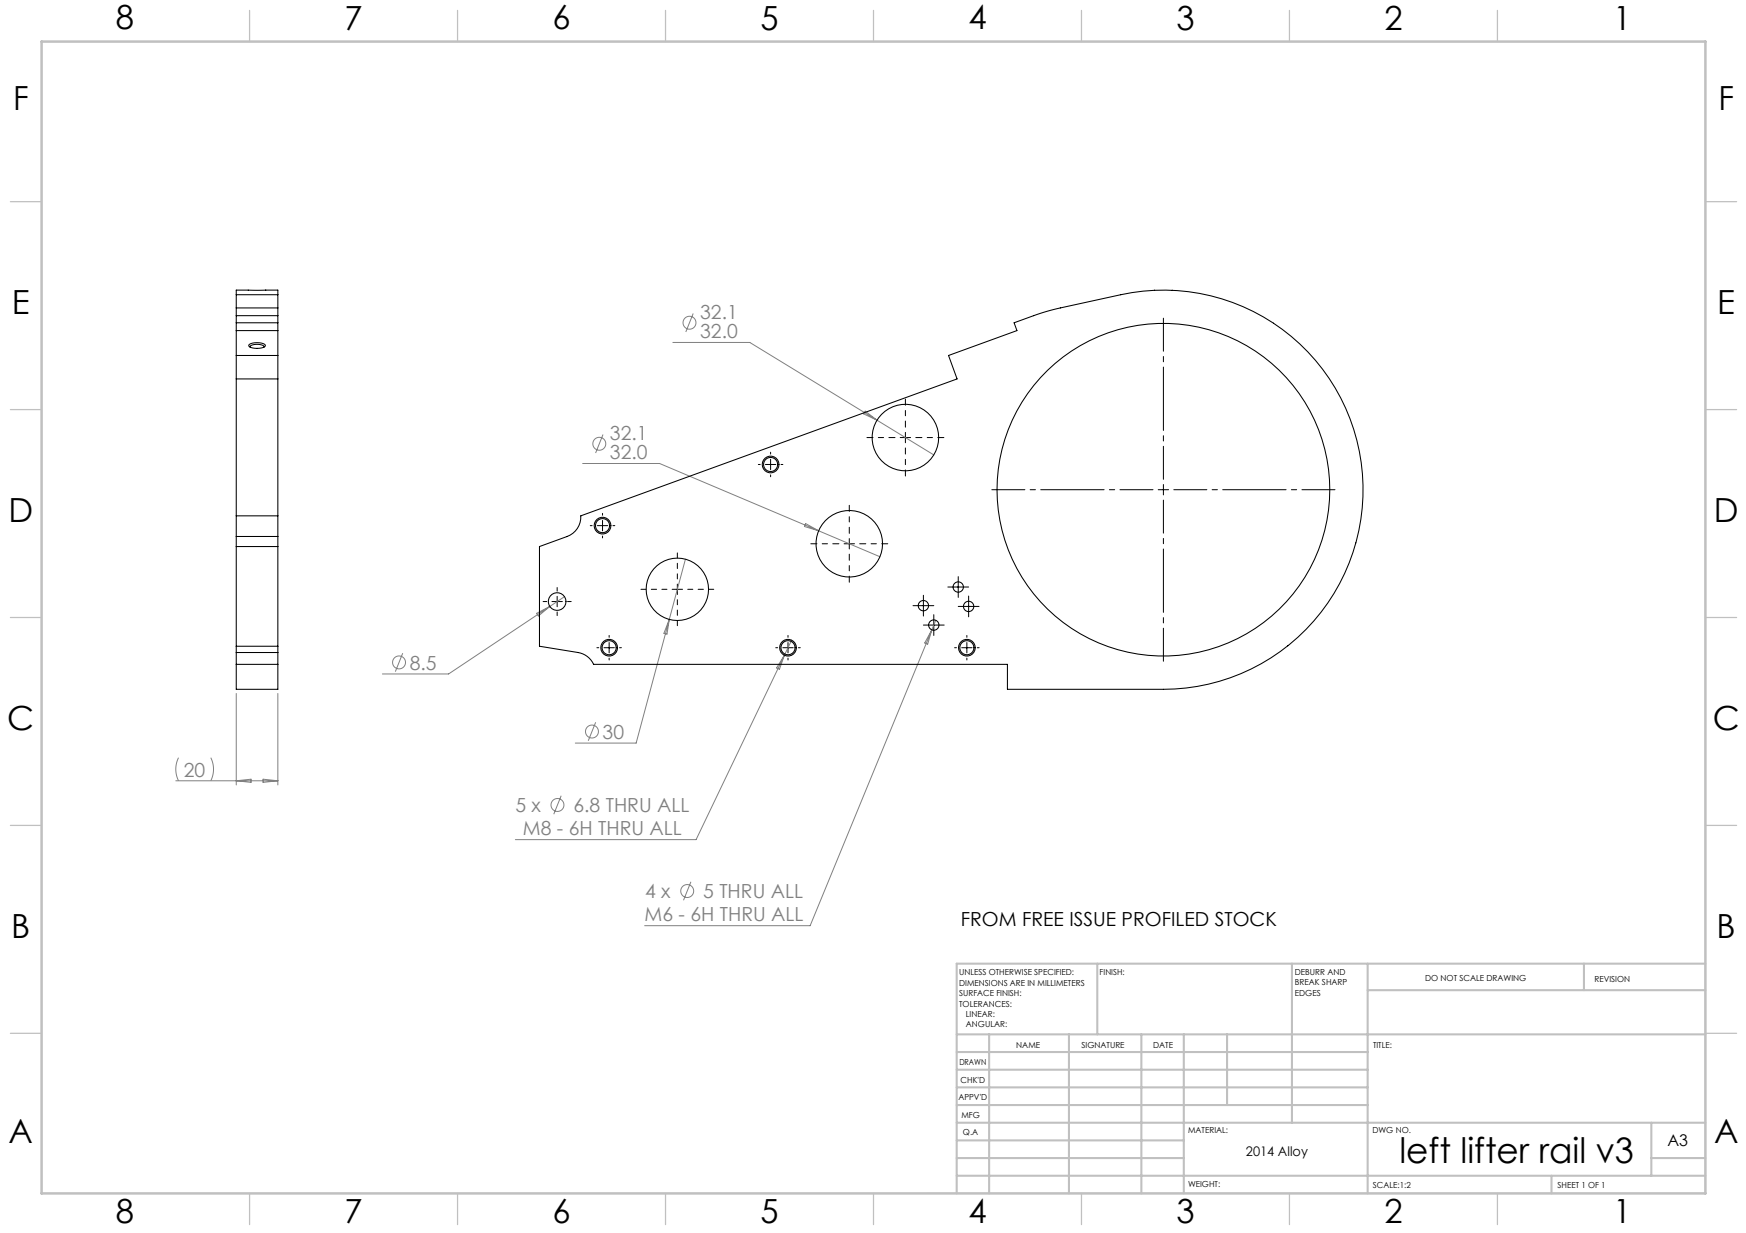
[picture p79: page 1]
6.8 THRU ALL; M8 - 6H THRU ALL; 5 THRU ALL; M6 - 6H THRU ALL; FINISH:; DEBURR AND; BREAK SHARP; DO NOT SCALE DRAWING; REVISION; SCALE:1:2; SHEET 1 OF 1

FROM FREE ISSUE PROFILED STOCK

UNLESS OTHERWISE SPECIFIED:
DIMENSIONS ARE IN MILLIMETERS
SURFACE FINISH:
TOLERANCES:
LINEAR:
ANGULAR:

NAME | SIGNATURE | DATE | | | | TITLE:

DRAWN
CHK'D
APPV'D
MFG
Q.A | | | | MATERIAL: | DWG NO. left lifter rail v3 | A3 2014 Alloy
