TeamCyberwar/Deadlock/drawings and step files/machining/lifter layshaft v0.2.PDF

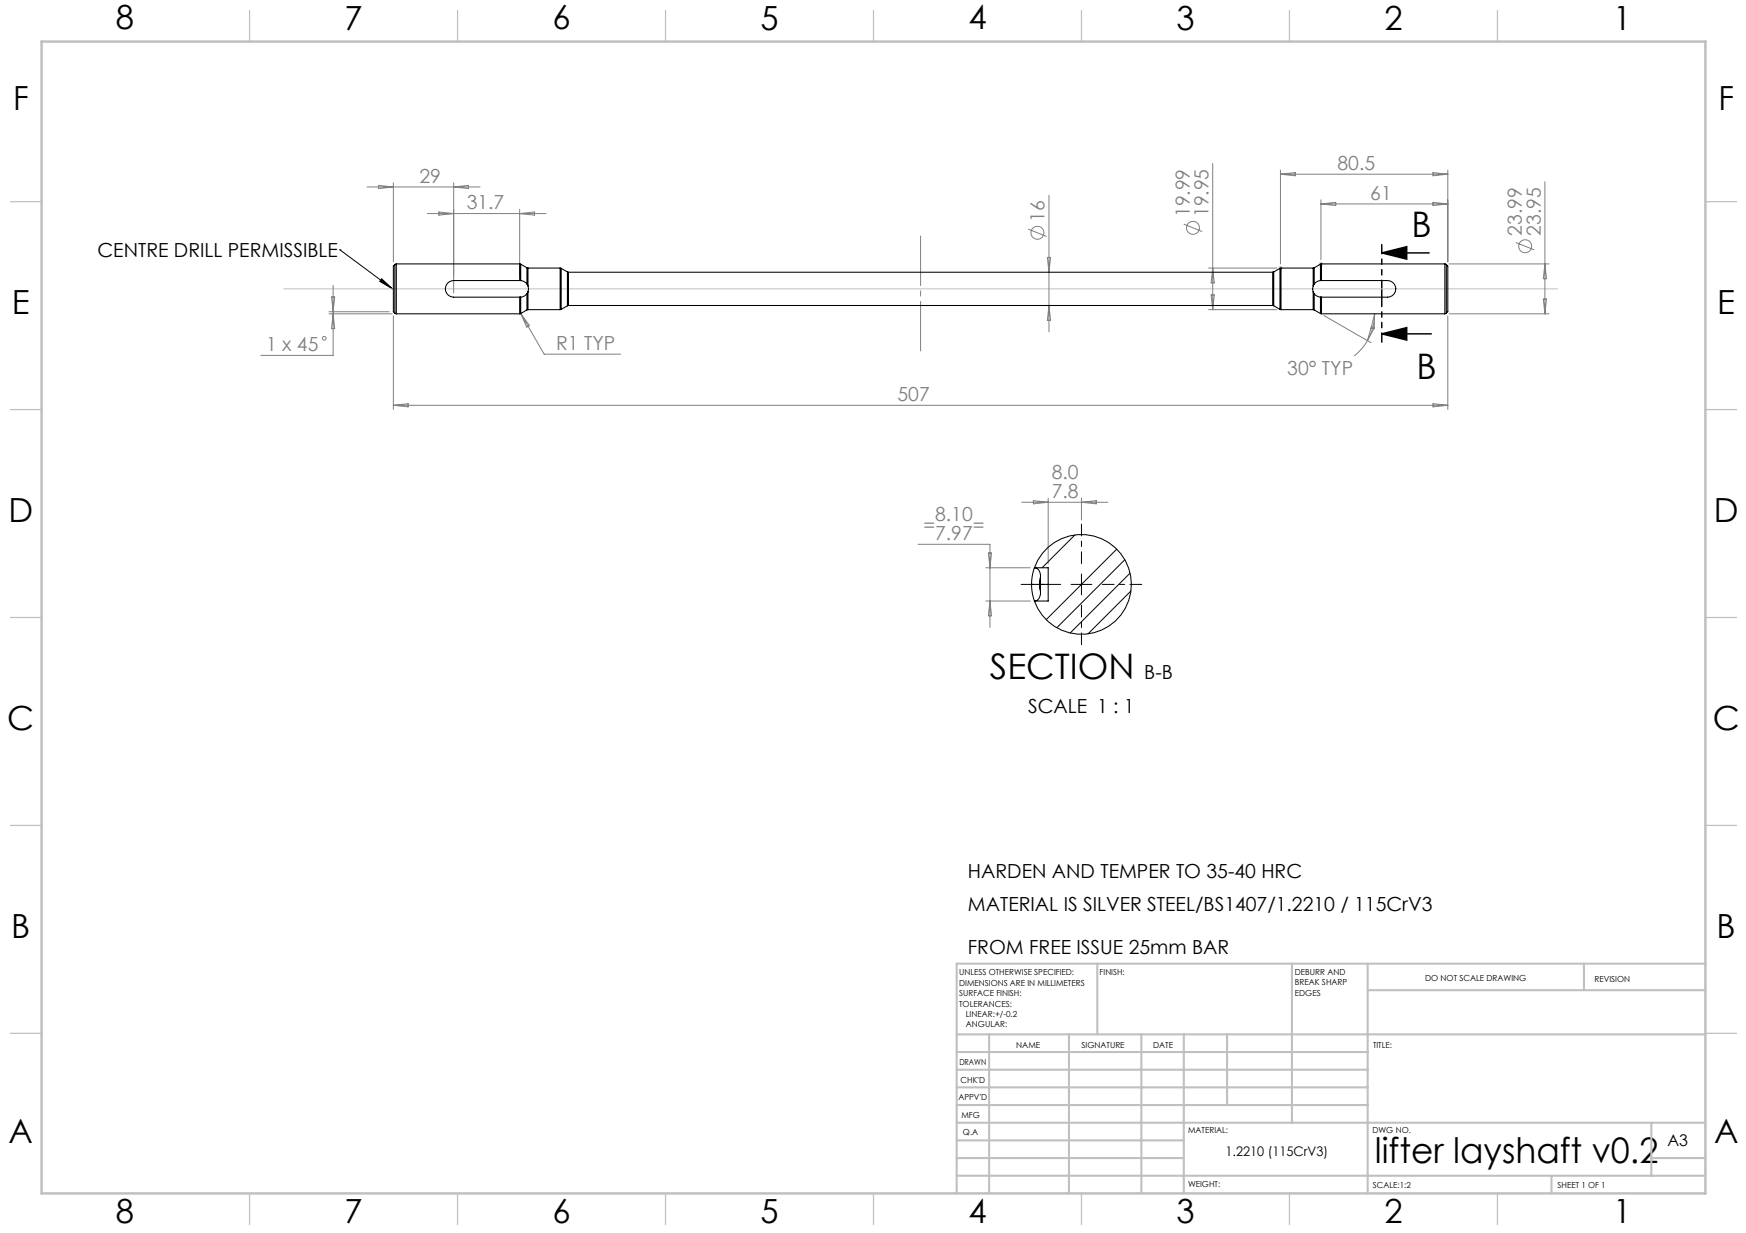
[picture p80: page 1]
30° TYP; R1 TYP; SECTION B-B; SCALE 1 : 1; FINISH:; DEBURR AND; BREAK SHARP; DO NOT SCALE DRAWING; REVISION; SCALE:1:2; SHEET 1 OF 1

CENTRE DRILL PERMISSIBLE

HARDEN AND TEMPER TO 35-40 HRC
MATERIAL IS SILVER STEEL/BS1407/1.2210 / 115CrV3
FROM FREE ISSUE 25mm BAR

UNLESS OTHERWISE SPECIFIED:
DIMENSIONS ARE IN MILLIMETERS
SURFACE FINISH:
TOLERANCES:
LINEAR:+/-0.2
ANGULAR:

NAME | SIGNATURE | DATE | | | | TITLE:

DRAWN
CHK'D
APPV'D
MFG
Q.A | | | | MATERIAL: | DWG NO. lifter layshaft v0.2 | A3 1.2210 (115CrV3)
