TeamCyberwar/Deadlock/drawings and step files/machining/M12 based wedgelet pin .PDF

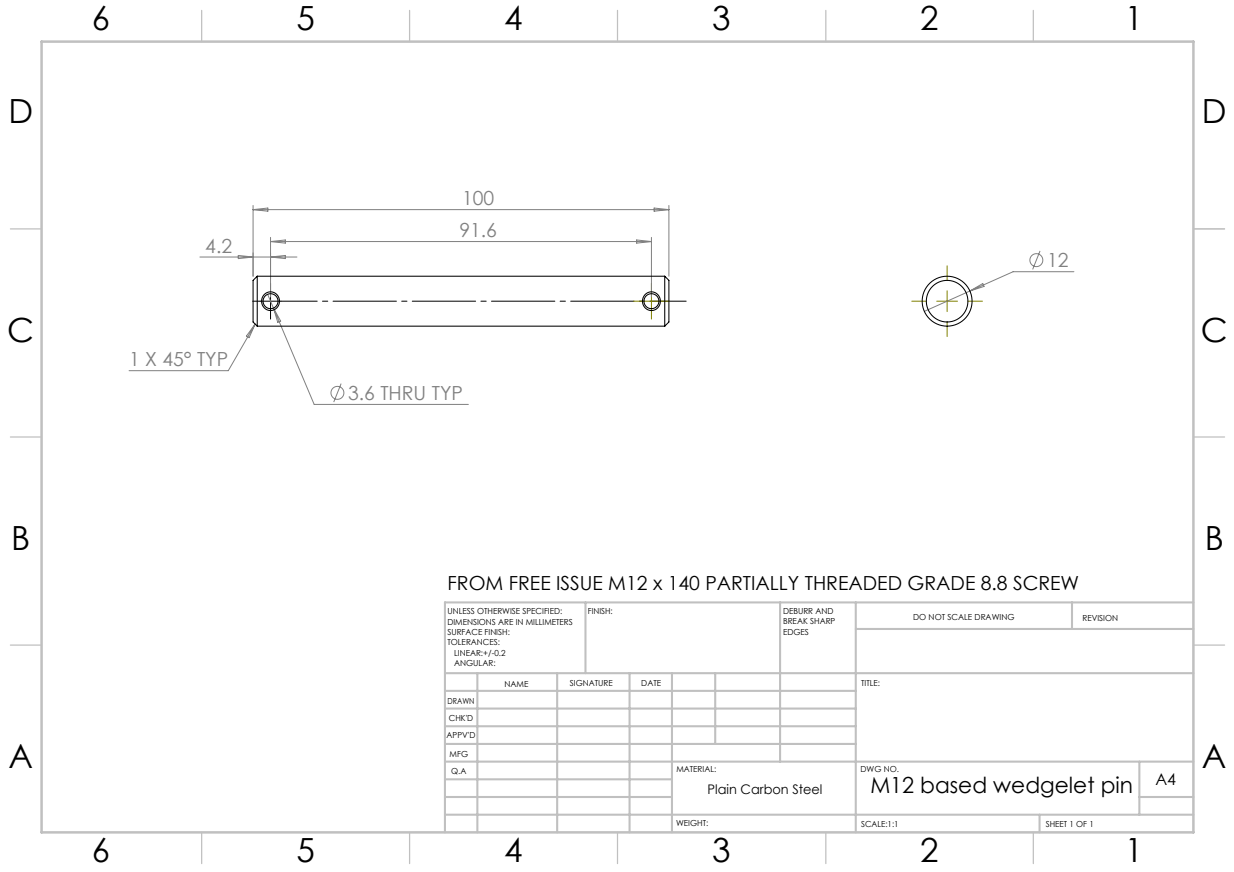
[picture p81: page 1]
1 X 45° TYP; 3.6 THRU TYP; FINISH:; DEBURR AND; BREAK SHARP; DO NOT SCALE DRAWING; REVISION; SCALE:1:1; SHEET 1 OF 1

FROM FREE ISSUE M12 x 140 PARTIALLY THREADED GRADE 8.8 SCREW

UNLESS OTHERWISE SPECIFIED:
DIMENSIONS ARE IN MILLIMETERS
SURFACE FINISH:
TOLERANCES:
LINEAR:+/-0.2
ANGULAR:

NAME | SIGNATURE | DATE | | | | TITLE:

DRAWN
CHK'D
APPV'D
MFG
Q.A | | | | MATERIAL: | DWG NO. M12 based wedgelet pin | A4 Plain Carbon Steel
