TeamCyberwar/Deadlock/drawings and step files/machining/nylon tube v3.PDF

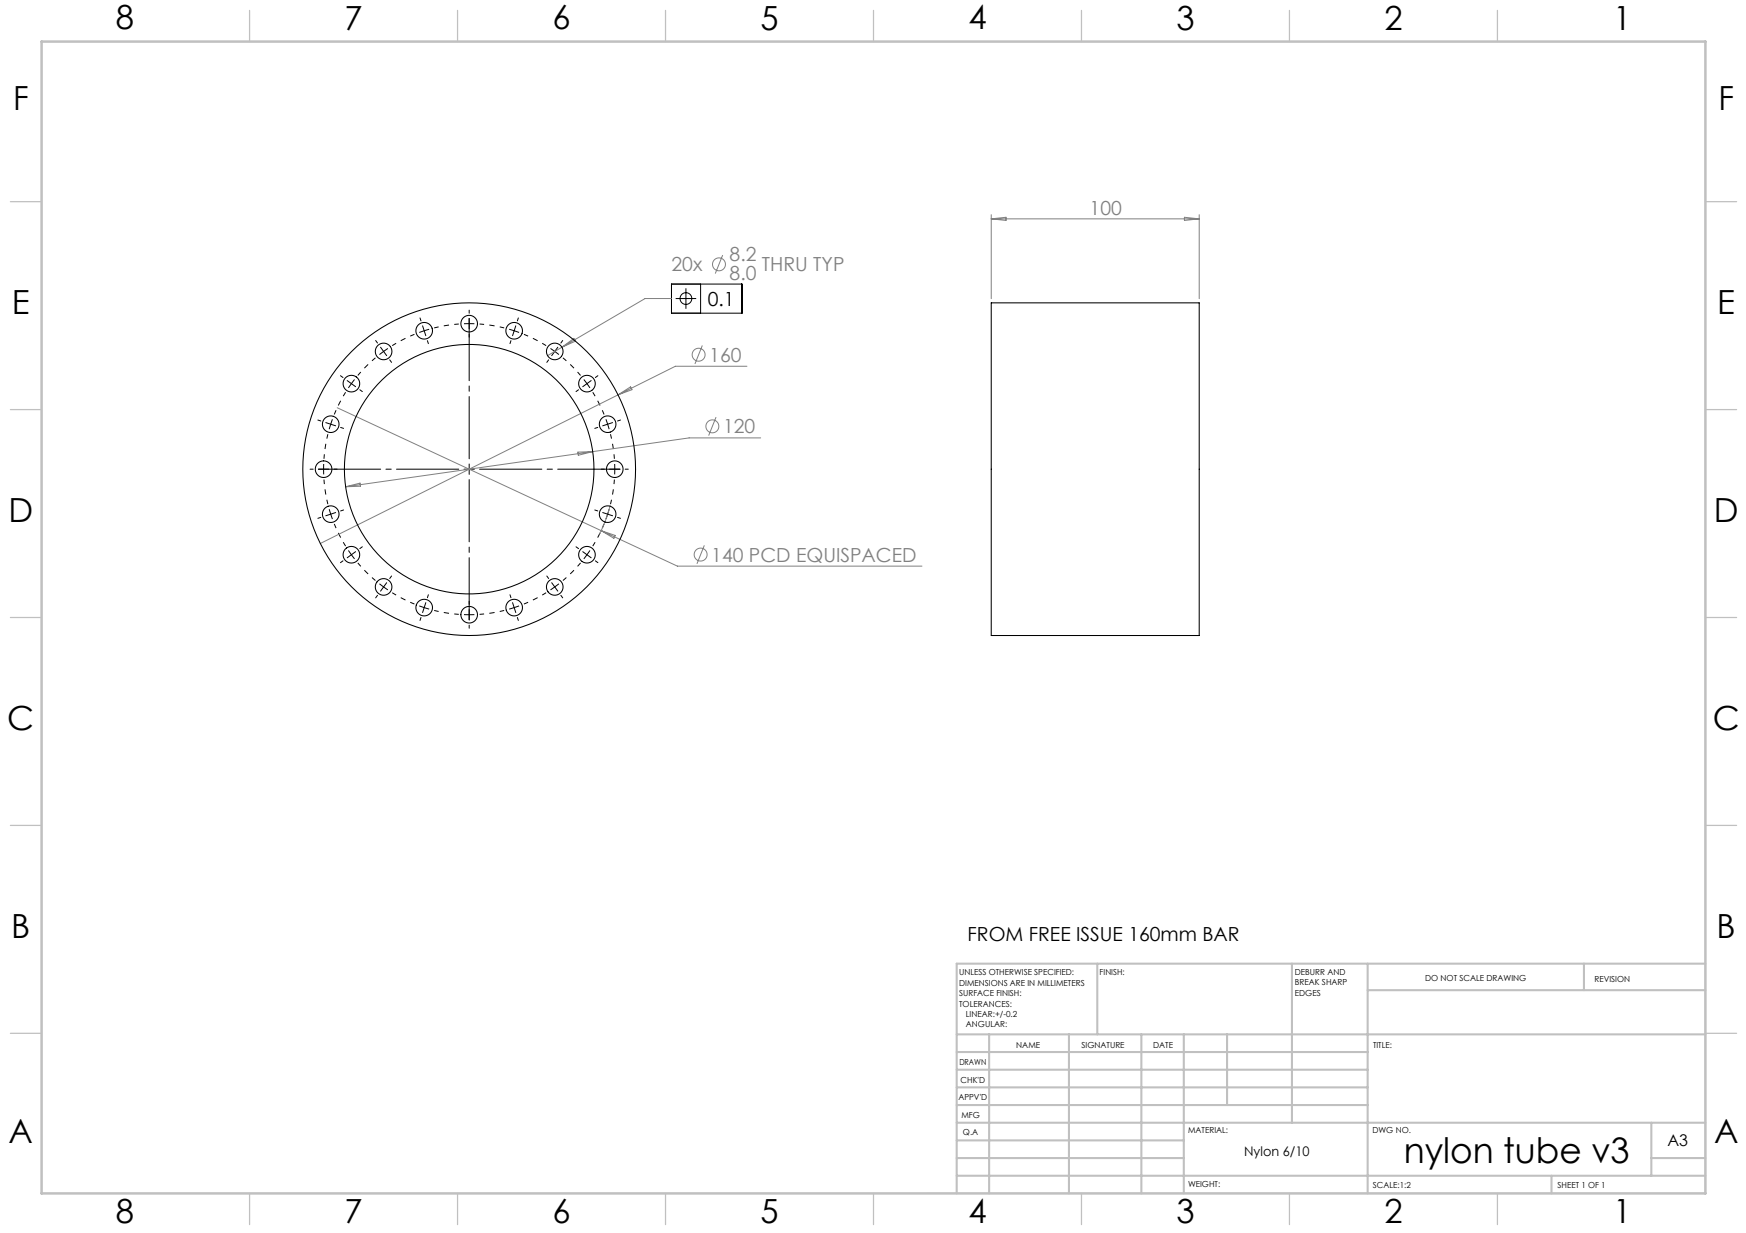
[picture p82: page 1]
20x 8.2 8.0 THRU TYP; 140 PCD EQUISPACED; FINISH:; DEBURR AND; BREAK SHARP; DO NOT SCALE DRAWING; REVISION; SCALE:1:2; SHEET 1 OF 1

FROM FREE ISSUE 160mm BAR

UNLESS OTHERWISE SPECIFIED:
DIMENSIONS ARE IN MILLIMETERS
SURFACE FINISH:
TOLERANCES:
LINEAR:+/-0.2
ANGULAR:

NAME | SIGNATURE | DATE | | | | TITLE:

DRAWN
CHK'D
APPV'D
MFG
Q.A | | | | MATERIAL: | DWG NO. nylon tube v3 | A3 Nylon 6/10
