TeamCyberwar/Deadlock/drawings and step files/machining/rear wheel axle.PDF

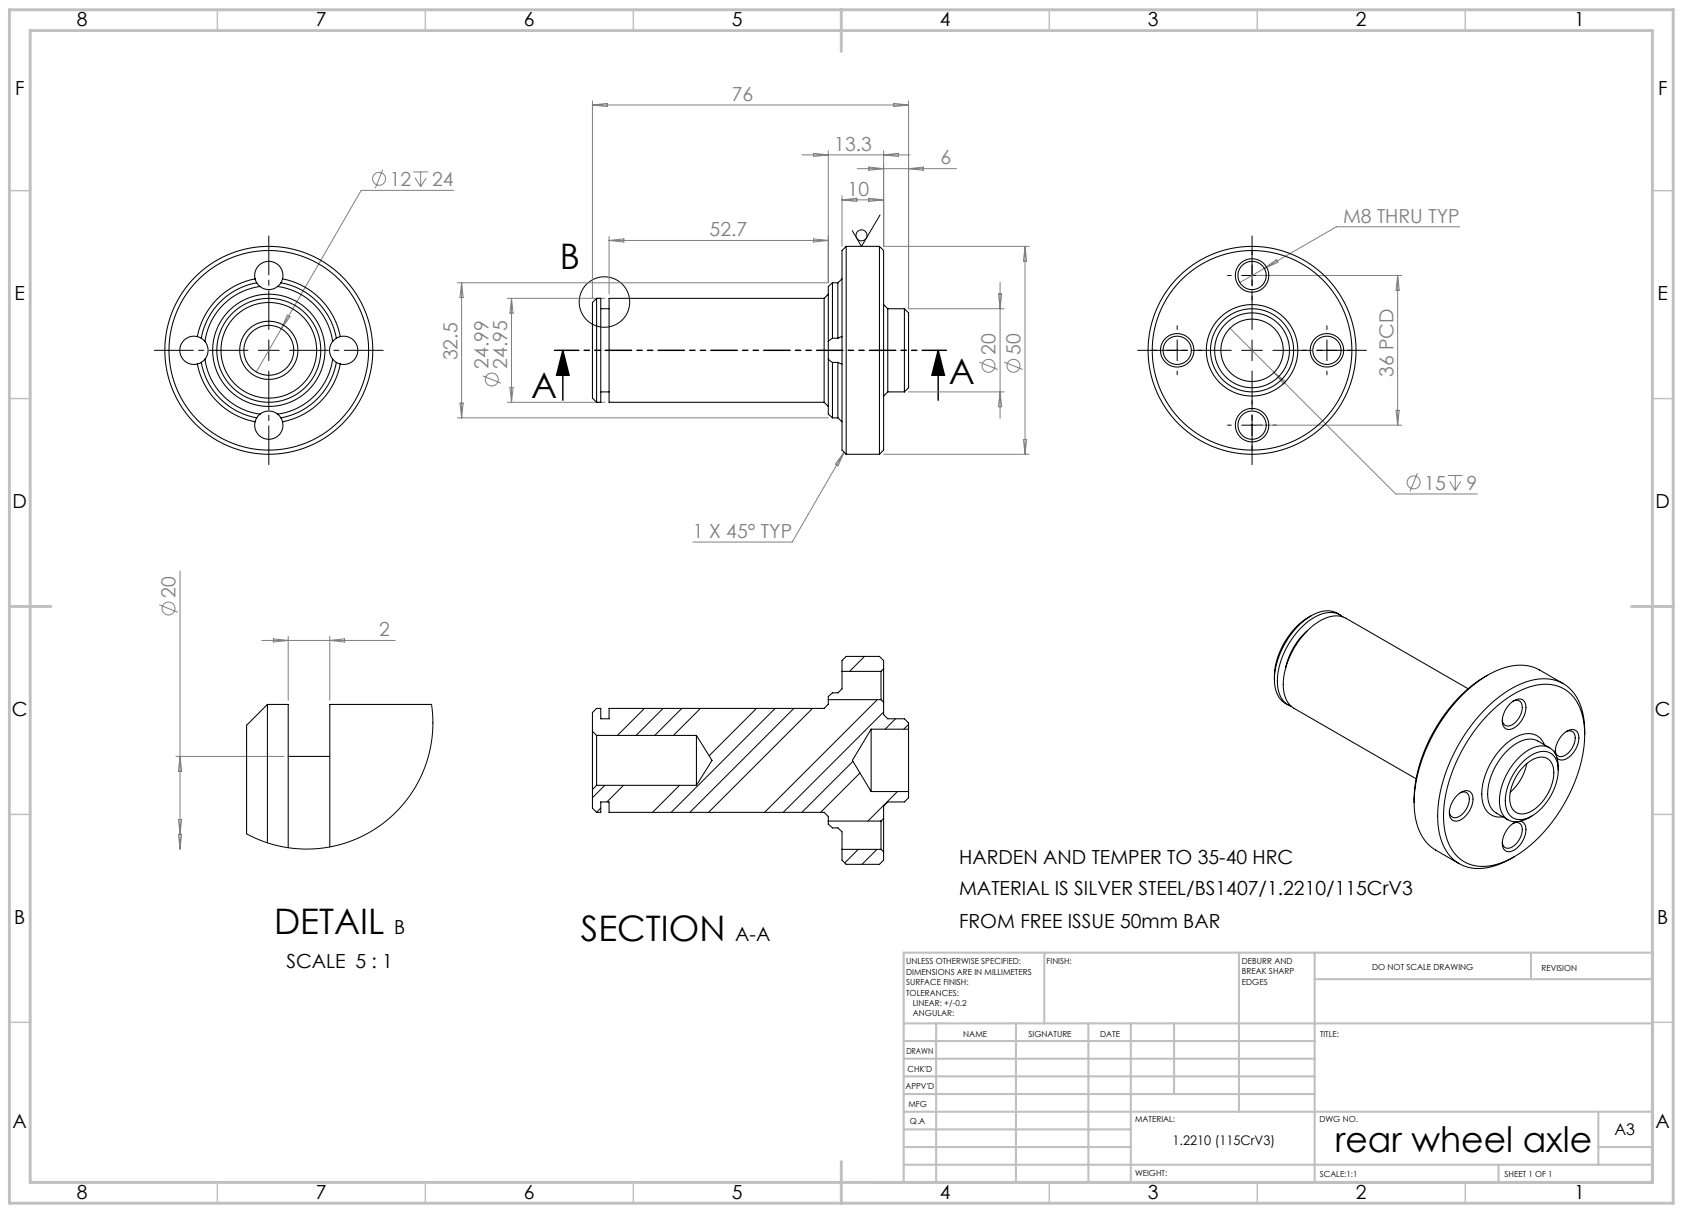
[picture p83: page 1]
1 X 45° TYP; SECTION A-A; DETAIL B; SCALE 5 : 1; FINISH:; DEBURR AND; BREAK SHARP; DO NOT SCALE DRAWING; REVISION; SCALE:1:1; SHEET 1 OF 1

M8 THRU TYP 36 PCD

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

UNLESS OTHERWISE SPECIFIED:
DIMENSIONS ARE IN MILLIMETERS
SURFACE FINISH:
TOLERANCES:
LINEAR: +/-0.2
ANGULAR:

NAME | SIGNATURE | DATE | | | | TITLE:

DRAWN
CHK'D
APPV'D
MFG
Q.A | | | | MATERIAL: | DWG NO. rear wheel axle | A3 1.2210 (115CrV3)
