TeamCyberwar/Deadlock/drawings and step files/machining/rear wheel hub v2.PDF

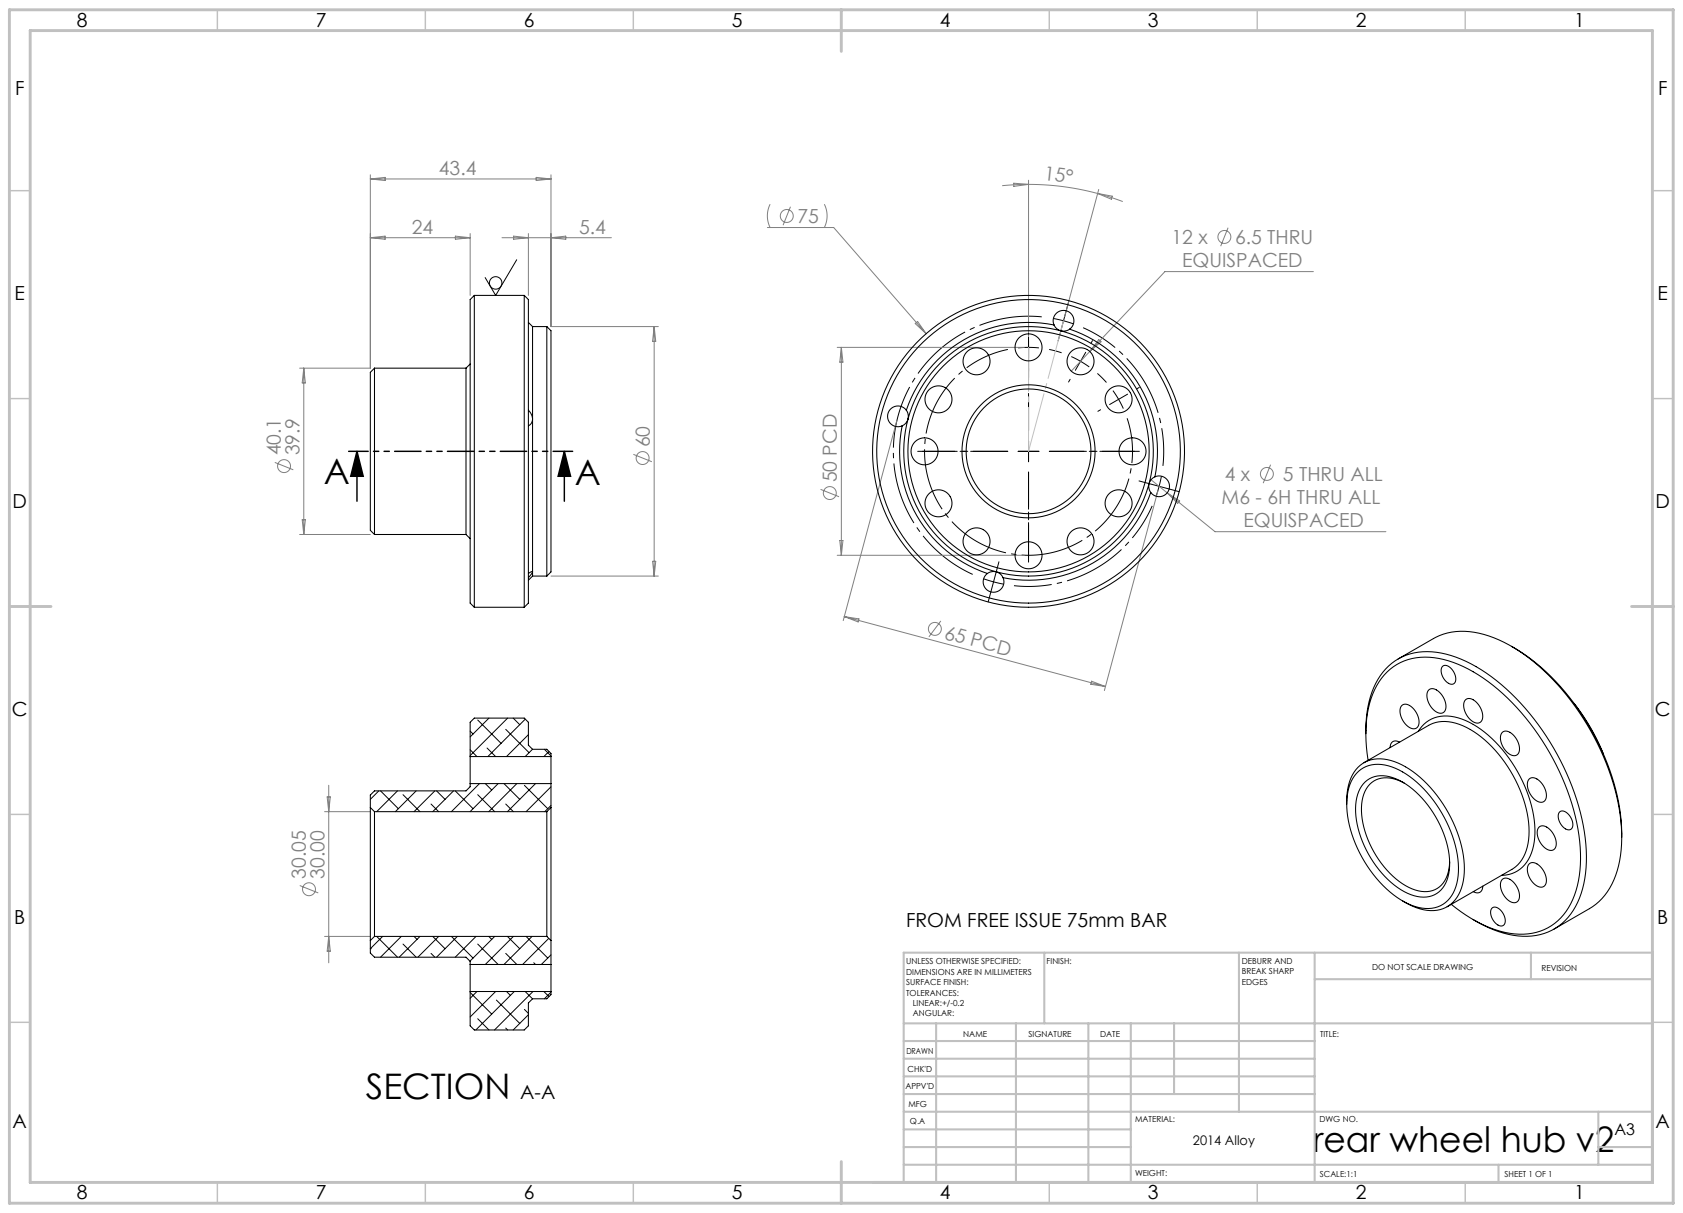
[picture p84: page 1]
50 PCD; 12 x 6.5 THRU; 5 THRU ALL; M6 - 6H THRU ALL; 65 PCD; SECTION A-A; FINISH:; DEBURR AND; BREAK SHARP; DO NOT SCALE DRAWING; REVISION; SCALE:1:1; SHEET 1 OF 1

FROM FREE ISSUE 75mm BAR

UNLESS OTHERWISE SPECIFIED:
DIMENSIONS ARE IN MILLIMETERS
SURFACE FINISH:
TOLERANCES:
LINEAR:+/-0.2
ANGULAR:

NAME | SIGNATURE | DATE | | | | TITLE:

DRAWN
CHK'D
APPV'D
MFG
Q.A | | | | MATERIAL: | DWG NO. rear wheel hub v2 | A3 2014 Alloy
