TeamCyberwar/Deadlock/eVESC/Parts/Heatsink Plate v2.pdf

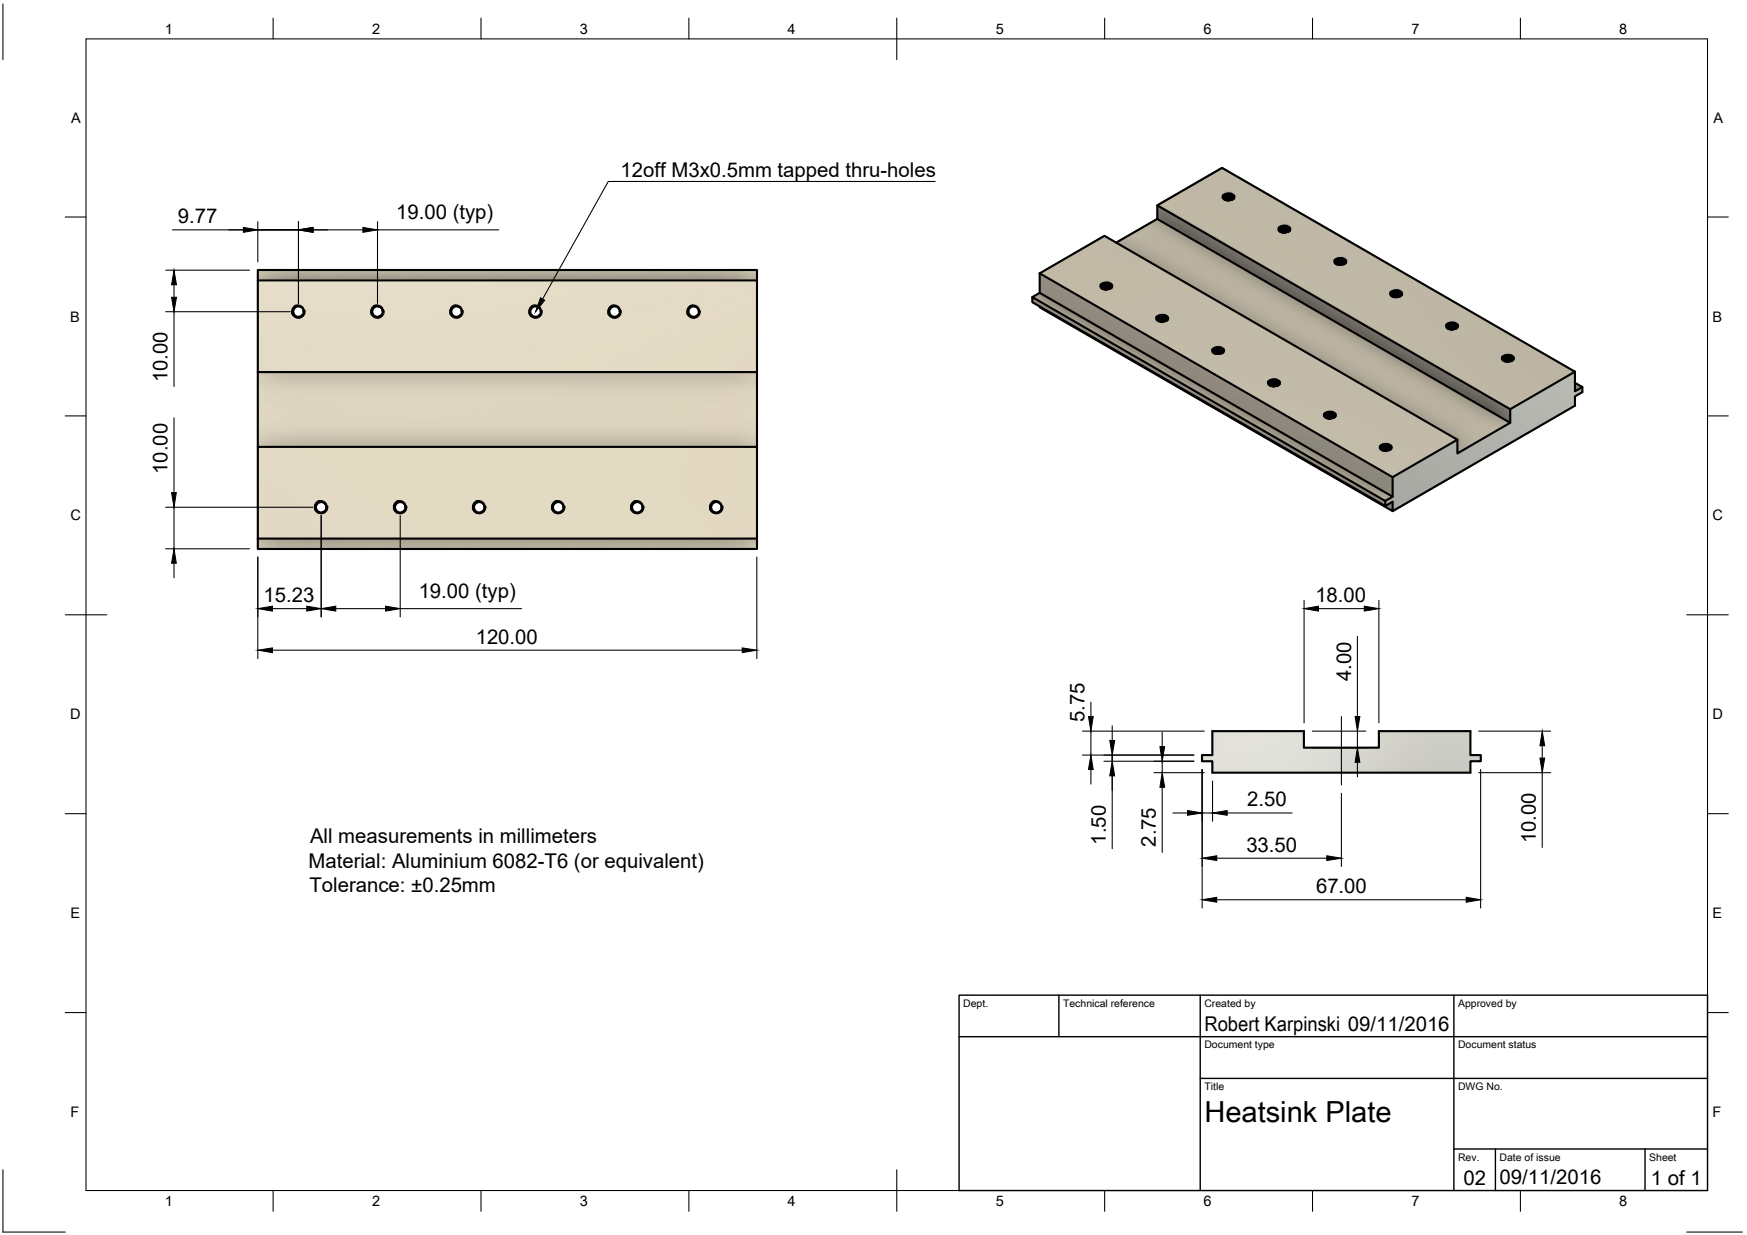
[picture p85: page 1]
Robert Karpinski 10.00 10.00; 19.00 (typ)

12off M3x0.5mm tapped thru-holes

All measurements in millimeters
Material: Aluminium 6082-T6 (or equivalent)
Tolerance: ±0.25mm

Dept. | Technical reference | Created by 09/11/2016 | Approved by

Document type | Document status

Title Heatsink Plate | DWG No.

Rev. 02 | Date of issue 09/11/2016 | Sheet
