TeamCyberwar/Deadlock/dogfood/10mm axle 682-084 b.PDF

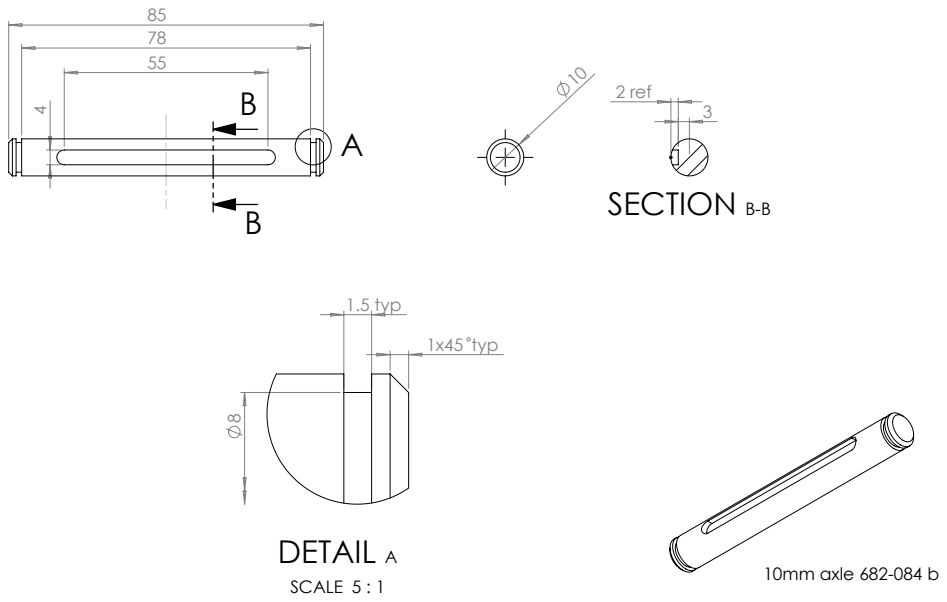
[picture p86: page 1]
10mm axle 682-084 b; 1.5 typ; 1x45 typ; DETAIL A; SCALE 5 : 1; 2 ref; SECTION B-B
