TeamCyberwar/Deadlock/dogfood/15mm axle 682 187.PDF

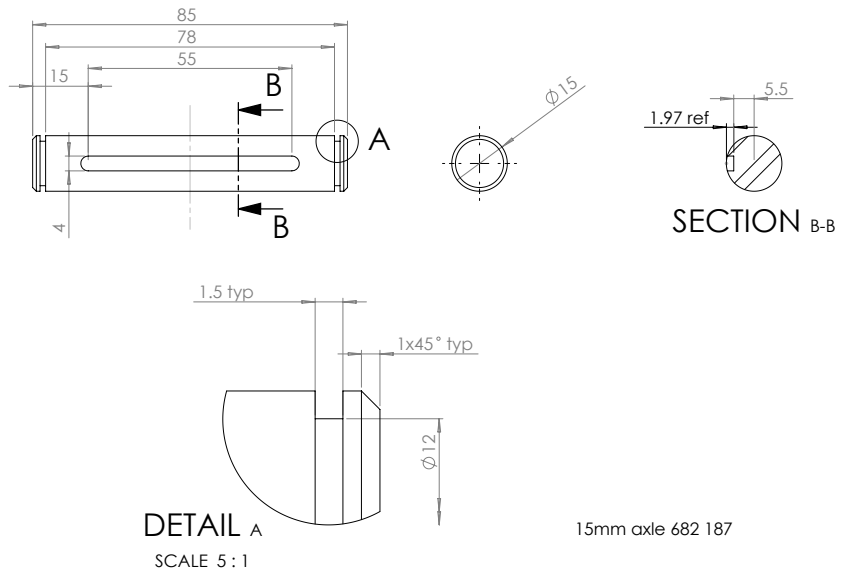
[picture p87: page 1]
1.5 typ; 1x45 typ 12; DETAIL A; SCALE 5 : 1; 1.97 ref; SECTION B-B; 15mm axle 682 187
